ranenbg/Arduino-FFB-wheel/brWheel_my/leonardo hex/ver_info_leonardo_micro.txt

version		features

- firmware HEX versions bellow require wheel control up to v1.81

11		encoder, 3 axis
111		encoder, 3 axis, 32 buttons
112		encoder, 2 axis + 1 for load cell, 32 buttons
12		encoder, 3 axis, up to 1800deg, 2x stronger damper and inertia
121		encoder, 3 axis, 32 buttons, up to 1800deg, 2x stronger damper and inertia
122		encoder, 2 axis + 1 for load cell, 32 buttons, up to 1800deg, 2x stronger damper and inertia
13		encoder, 3 axis, 3 buttons, up to 1800deg, 2x stronger damper and inertia
130		encoder, 3 axis, 3 buttons, up to 1800deg, 2x stronger damper and inertia, fixed periodic effects
131		encoder, 3 axis, 32 buttons, up to 1800deg, 2x stronger damper and inertia, fixed periodic effects + envelope + condition
133		encoder, 2 axis + 1 for load cell, 3 buttons, up to 1800deg, 2x stronger damper and inertia, fixed periodic effects + envelope + condition
14		encoder, 3 axis, 3 buttons, up to 1800deg, 2x stronger damper and inertia, fixed periodic effects + envelope + condition, EEPROM update only, FFB balance instead of brake strength
140		encoder, 3 axis, 3 buttons, up to 1800deg, 2x stronger damper and inertia, EEPROM update only, FFB balance instead of brake strength, reduced serial response details, individual timers for periodic effects + small fix
141		encoder, 3 axis, 32 buttons, up to 1800deg, 2x stronger damper and inertia, EEPROM update only, FFB balance instead of brake strength, reduced serial response details, individual timers for periodic effects + small fix
142		encoder, 2 axis + 1 for load cell, 32 buttons up to 1800deg, 2x stronger damper and inertia, EEPROM update only, FFB balance instead of brake strength, reduced serial response details, individual timers for periodic effects + small fix
141a		the same as v141, with wheel calibration enabled at startup
141b		the same as v141, with wheel calibration enabled at startup and no pedal autocalibration
150		the same as v140, but with only 1 FFB axis (fix for LFS)
151		the same as v141, but with only 1 FFB axis (fix for LFS)
152		the same as v142, but with only 1 FFB axis (fix for LFS)
150z            the same as v150, but with z-index support
151a		the same as v151, but with no pedal auto calibration
153		encoder + Z-index, 2 axis + 1 for load cell, 3 buttons, pedal autocalib, FFB output with 2xDAC (adafruit MCP4725) - recommended for DD wheels

- firmware HEX versions bellow require wheel control v1.9 or newer

160	        encoder, 4 axis, 2 buttons, pedal autocalib, 1FFB axis
160a	        the same as v160, but with no pedal auto calibration
160z	        the same as v160, with Z-index support
161		encoder, 4 axis, 28 buttons, pedal autocalib, 1FFB axis
162a		encoder, 3 axis + 1 for load cell, 2 + 28buttons, no pedal autocalib, 1FFB axis 
163		encoder + Z-index, 3 axis + 1 for load cell, 2 + 28buttons, pedal autocalib, 1FFB axis, FFB output with 2xDAC (adafruit MCP4725) - recommended for DD wheels

- firmware HEX versions bellow require wheel control v2.0 or newer

170 		encoder, 4 axis, 4 buttons, no pedal autocalib, 1FFB axis
170a		encoder, 4 axis, 4 buttons, pedal autocalib, 1FFB axis
170z 		encoder + Z-index, 4 axis, 4 buttons, no pedal autocalib, 1FFB axis
171ah		encoder, 4 axis, 4 (1 hat switch) + 24 buttons, pedal autocalib, 1FFB axis
172h		encoder, 3 axis + 1 for load cell, 4 (1 hat switch) + 24 buttons, no pedal autocalib, 1FFB axis 
172ah		encoder, 3 axis + 1 for load cell, 4 (1 hat switch) + 24 buttons, pedal autocalib, 1FFB axis
172azh		encoder + Z-index, 3 axis + 1 for load cell, 4 (1 hat switch) + 24 buttons, pedal autocalib, 1FFB axis
173azh		encoder + Z-index, 3 axis + 1 for load cell, 4 (1 hat switch) + 24 buttons, pedal autocalib, 1FFB axis, FFB output with 2xDAC (adafruit MCP4725) - recommended for DD wheels

180		encoder, 4 axis, 8 buttons, 2 FFB axis, shift register fix, button matrix, periodic effects timing fix, duration and start delay fix, 16bit direction, new HX711 library, debug FFB optimizations, 16x less strong spring
180z		the same as v180, with support for encoder Z-index channel
180as		the same as v180, with pedal autocalib and support for ADS1015 external ADC for pedals
180az		the same as v180z, with pedal autocalib
180azt		the same as v180az, with 4x4 button matrix support
180azht		the same as v180azt, with hat switch support (1st 4 buttons from a matrix are used)					
181z		the same as v180z, but has shift register support for 16 buttons
181as		the same as 180as, but has shift register support for 16 buttons	
181ahs		the same as v181as but has hat switch support (1st 4 buttons from shift register are used)
181azh 		the same as v181z, with pedal autocalib and hat switch support
182azh		the same as v181z, with pedal autocalib and load cell support with HX711
183ah		the same as v182azh, but without z-index support and has analog FFB output with 2x12bit DAC MCP4275

- firmware HEX versions bellow require wheel control v2.1 or newer

190		encoder, 4 axis, 8 buttons, 100k CPR, wheel angle as metric for conditional effects, shift register fix, button matrix, 2 FFB axis, periodic effects timing fix, duration and start delay fix, 16bit direction, new HX711 library, debug FFB optimizations, 16x less strong spring
190as		the same as v190, with pedal autocalib and support for ADS1015 external ADC for pedals
190azht		the same as v190, with pedal autocalib, encoder Z-index channel, 4x4 button matrix and hat switch support
190azf		the same as v190, with pedal autocalib, encoder Z-index channel and XY analog shifter support
191azh		the same as v190, with pedal autocalib, shift register, encoder Z-index channel and hat switch support	
192azh		the same as v191, with load cell support with HX711
192af		the same as v190, with pedal autocalib, XY analog shiffter and HX711 support (no shift register)	
192azf		the same as v191af, with z-index support
193ah		the same as v192azh, but without z-index support and has analog FFB output with 2x12bit DAC MCP4275

- firmware HEX versions bellow require wheel control v2.3 or newer

200		encoder, 4 axis, 8 buttons, 100k CPR, wheel angle as metric for conditional effects, shift register fix, button matrix, 2 FFB axis, periodic effects timing fix, duration and start delay fix, 16bit direction, new HX711 library, debug FFB optimizations, 16x less strong spring, manual pedal axis calibration, pwm0.50.100 mode
200a		the same as v200, with pedal autocalib instead of manual calib
200z		the same as v200, with z-index support
200c		the same as v200, with hardware wheel recenter button on pin D2
200f		the same as v200, with XY analog shiffter support
200zf		the same as v200, with z-index and XY analog shiffter support
200azf		the same as v200zf, with pedal autocalib instead of manual calib

- firmware HEX versions bellow require wheel control v2.4 or newer

210		encoder, 4 axis, 8 buttons, 100k CPR, wheel angle as metric for conditional effects, shift register fix, button matrix, 2 FFB axis, periodic effects timing fix, duration and start delay fix, 16bit direction, new HX711 library, debug FFB optimizations, 16x less strong spring, manual pedal axis calibration, pwm0.50.100 mode, rcm pwm mode
210a		the same as v210, with pedal autocalib instead of manual calib
210z		the same as v210, with z-index support
210c		the same as v210, with hardware wheel recenter button on pin D2
210f		the same as v210, with XY analog shiffter support
210cf		the same as v210c, with XY analog shiffter support
210acf		the same as v210cf, with automatic pedal calibration
210zf		the same as v210, with z-index and XY analog shiffter support
210azf		the same as v210zf, with pedal autocalib instead of manual calib
210ht		the same as v210, with 4x4 button matrix and a hat switch support
211ah		the same as v210a, with shifter register and hat switch support 
211s		the same as v210, with support for ADS1015 external ADC for pedals and shift register
211chf		the same as v210cf, with a hat switch and shift register		
212ah		the same as v211ah, with load cell support with HX711 
213ah		the same as v211ah, but has analog FFB output with 2x12bit DAC MCP4275

- firmware HEX versions bellow require wheel control v2.5 or newer

220		encoder, 4 axis, 8 buttons, 100k CPR, wheel angle as metric for conditional effects, shift register fix, button matrix, 2 FFB axis, periodic effects timing fix, duration and start delay fix, 16bit direction, new HX711 library, debug FFB optimizations, 16x less strong spring, manual pedal axis calibration, pwm0.50.100 mode, rcm pwm mode, X-axis calibration 0-65k, encoder z-index reset
220a		the same as v220, with pedal autocalib instead of manual calib
220z		the same as v220, with z-index support
220c		the same as v220, with hardware wheel recenter button on pin D2
220f		the same as v220, with XY analog shiffter support
220cf		the same as v220c, with XY analog shiffter support
220ct		the same as v220c, with 4x4 button matrix support
220acf		the same as v220cf, with automatic pedal calibration
220zf		the same as v220, with z-index and XY analog shiffter support
220azf		the same as v210zf, with pedal autocalib instead of manual calib
220ht		the same as v220, with 4x4 button matrix and a hat switch support
220azht		the same as v220ht, with automatic pedal calibration and z-index support
220acht		the same as v220ht, with automatic pedal calibration and hardware wheel recenter button on pin D2
221ah		the same as v220a, with shifter register and hat switch support 
221s		the same as v220, with support for ADS1015 external ADC for pedals and shift register
221chf		the same as v210cf, with a hat switch and shift register		
222ah		the same as v221ah, with load cell support with HX711
222h		the same as v222ah, but with manual pedal calibration
222zh		the same as v221ah, but has Z-index support and has manual pedal calibration instead
223ah		the same as v221ah, but has analog FFB output with 2x12bit DAC MCP4275

- firmware HEX versions bellow require wheel control v2.6.0 or newer

230x		encoder, 4 axis, 8 buttons, 100k CPR, wheel angle as metric for conditional effects, shift register fix, button matrix, 2 FFB axis, periodic effects timing fix, duration and start delay fix, 16bit direction, new HX711 library, debug FFB optimizations, 16x less strong spring, manual pedal axis calibration, pwm0.50.100 mode, rcm pwm mode, X-axis calibration 0-65k, encoder z-index reset, additional h-shifter options, FFB on analog axis selector, variable pedal cal values
230ax		the same as v230x, with pedal autocalib instead of manual calib
230zx		the same as v230x, with z-index support
230cx		the same as v230x, with hardware wheel recenter button on pin D2
230ix		the same as v230x, with averaging of analog inputs for pedals (4 samples)
230sx		the same as v230x, with support for ADS1015 external ADC for pedals
230fx		the same as v230x, with XY analog shifter support
230cfx		the same as v230cx, with XY analog shifter support
230ctx		the same as v230cx, with 4x4 button matrix support
230acfx		the same as v230cfx, with automatic pedal calibration
230zfx		the same as v230fx, with z-index support
230azfx		the same as v230zfx, with pedal autocalib instead of manual calib
230htx		the same as v230x, with 4x4 button matrix and a hat switch support
230azhtx	the same as v230htx, with automatic pedal calibration and z-index support
230achtx	the same as v230htx, with automatic pedal calibration and hardware wheel recenter button on pin D2
231ahx		the same as v230ax, with shifter register and hat switch support 
231sx		the same as v230x, with support for ADS1015 external ADC for pedals and shift register
231chfx		the same as v230cfx, with a hat switch and shift register support		
232ahx		the same as v231ahx, with load cell support with HX711
232hx		the same as v232ahx, but with manual pedal calibration
232zhx		the same as v232ahx, with load cell and Z-index support, but has manual pedal calibration instead
232chx		the same as v232hx, with hardware wheel recenter button on pin D2 
233ahx		the same as v232ahx, but has analog FFB output with 2x12bit DAC MCP4275

- firmware HEX versions bellow require wheel control v2.6.1 or newer

240x		encoder, 4 axis, 8 buttons, 100k CPR, wheel angle as metric for conditional effects, shift register fix, button matrix, 2 FFB axis, periodic effects timing fix, duration and start delay fix, 16bit direction, new HX711 library, debug FFB optimizations, 16x less strong spring, manual pedal axis calibration, pwm0.50.100 mode, rcm pwm mode, X-axis calibration 0-65k, encoder z-index reset, additional h-shifter options, FFB on analog axis selector, with variable pedal cal values, button pin mapping fixes
240ax		the same as v240x, with pedal autocalib instead of manual calib
240wx		the same as v240x, with magnetic encoder support
240zx		the same as v240x, with z-index support
240cx		the same as v240x, with hardware wheel recenter button on pin D2
240ix		the same as v240x, with averaging of analog inputs for pedals (4 samples)
240sx		the same as v240x, with support for ADS1015 external ADC for pedals
240fx		the same as v240x, with XY analog shifter support
240cfx		the same as v240cx, with XY analog shifter support
240htx		the same as v240x, with 4x4 button matrix and a hat switch support
240chtx		the same as v240htx, with hardware wheel recenter button on pin D2
240acfx		the same as v240cfx, with automatic pedal calibration
240zfx		the same as v240fx, with z-index support
240azfx		the same as v240zfx, with pedal autocalib instead of manual calib
240azhtx	the same as v240htx, with automatic pedal calibration and z-index support
240achtx	the same as v240chtx, with automatic pedal calibration
241ahx		the same as v240ax, with shifter register and hat switch support 
241whx		the same as v240wx, with shifter register and hat switch support
241shx		the same as v240sx, with shift register and hat support
241chfx		the same as v240cfx, with a hat switch and shift register support
242ahx		the same as v241ahx, with load cell support with HX711
242awhx		the same as v242ahx, with magnetic encoder support
242hx		the same as v242ahx, but with manual pedal calibration
242zhx		the same as v242ahx, with load cell and Z-index support, but has manual pedal calibration instead
242chx		the same as v242hx, with hardware wheel recenter button on pin D2
243ahx		the same as v242ahx, but has analog FFB output with 2x12bit DAC MCP4275

- firmware HEX versions bellow require wheel control v2.6.3 or newer

250x		encoder, 4 axis, 8 buttons, 100k CPR, wheel angle as metric for conditional effects, shift register fix, button matrix, 2 FFB axis, periodic effects timing fix, duration and start delay fix, 16bit direction, new HX711 library, debug FFB optimizations, 16x less strong spring, manual pedal axis calibration, pwm0-50-100 mode, rcm pwm mode, X-axis calibration 0-65k, encoder z-index reset, additional h-shifter options, FFB on analog axis selector, with variable pedal cal values, button pin mapping fixes, 2 axis FFB support (for constant, sine, spring), 4 channel PWM output (2CH PWM modes available), dac0-50-100 mode (and its 2CH equivalents)
250ax		the same as v250x, with pedal autocalibration instead of manual calibration
250bx		the same as v250x, with 2 FFB axis and 4 channel PWM output	
250abx		the same as v250bx, with pedal autocalibration		
250bcdwx	the same as v250bx, without optical encoder, with magnetic encoder (AS5600) and hardware wheel recenter button on pin TX
250cx		the same as v250x, with hardware wheel recenter button on pin D2
250dx		the same as v250x, without support for optical encoder (you can use pot for x-axis)
250zx		the same as v250x, with z-index support		
250ix		the same as v250x, with averaging of analog inputs for pedals (4 samples)
250sx		the same as v250x, with support for 12bit ADS1015 external ADC for pedals
250fx		the same as v250x, with XY analog shifter support
250zfx		the same as v250fx, with z-index support
250acx		the same as v250cx, with pedal autocalibration
250achx		the same as v250acx, with hat switch support	
250cdwhx	similar to v250bcdwx, just with	only 1 FFB axis	
250acdwhx	the same as 250cdwhx, with pedal autocalibration
250htx		the same as v250x, with hat switch and 4x4 button matrix support	
250chtx		the same as v250htx, with recenter button on pin D2
250zhxn		the same as v250zx, with hat switch and shifter register (nano button box)
250achxn	the same as v250cx, with pedal autocalibration, hat switch and shifter register (nano button box)
250achexn	the same as v250achxn, with support for two extra buttons (on pins A2, A3)
250azhxn	the same as v250zhxn, with pedal autocalibration
250xl		the same as v250x, with load cell support with HX711
250hxl		the same as v250xl, with hat switch support
250fxl		the same as v250xl, with XY analog shifter support		
250hxnl		the same as v250hxl, with shifter register (nano button box)
250hfxnl	the same as v250hxnl, with XY analog shifter support
250ahxnl	the same as v250hxnl, with pedal autocalibration	
250zhxnl	the same as v250hxnl, with z-index support
250zhfxnl	the same as v250zhxnl, with XY analog shifter support
250bdwux	the same as v250bx, with support for 2 magnetic encoders (AS5600) via i2C multiplexer (TCA9548A)
250bcdwux	the same as v250bdwux, with hardware wheel recenter button on pin TX
250xg		the same as v250x, with analog FFB output via 2x12bit external DAC (MCP4275)
250bxg		the same as v250xg, with 2 FFB axis and 2 channel analog DAC output	
250bdxg		the same as v250bxg, without optical encoder (full analog firmware)
250bcdwxg	the same as v250bdxg, with magnetic encoder (AS5600) and hardware wheel recenter button on pin TX 	
250hxng		the same as v250xg, with hat switch and shifter register (nano button box)

- firmware HEX versions bellow require wheel control v2.6.4 or newer

250xnr		the same as v250x, with support for 3x8bit shift register chip SN74ALS166N for 24 buttons
250hxnr		the same as v250xnr, with hat switch support
250bdwuxg	the same as v250bdxg, with support for 2 magnetic encoders (AS5600) via i2C multiplexer (TCA9548A)
250chfxn	the same as v250cx, with support for hat switch, XY analog shifter and shift register (nano button box)
250chfxnr	the same as v250chfxn, with support for 2x8bit shift register chip SN74ALS166N for 16 buttons, instead of nano button box
250dwfx         the same as v250fx, with support for magnetic encoder (AS5600) instead of an optical one
250dwxn         the same as v250x, with support for magnetic encoder (AS5600) and with nano button box
250kx		the same as v250x, with gas axis split into gas and brake axis

- firmware HEX versions bellow require wheel control v2.6.6 or newer

250dkx		the same as v250dx, with gas axis split into gas and brake axis
