ranenbg/Arduino-FFB-wheel/brWheel_my/docs/RS232 commands info.txt

Milos Rankovic, ranenbg@gmail.com
first created 25.03.2020.
last update 19.03.2024.

This txt file contains a list of all available RS232 serial interface commands implemented in my latest Arduino FFB wheel firmware version fw-v250 (you can use this info to make your own control GUI)

Arduino boards are also recognized as a virtual serial communication device (COM port) through which we can send/receive commands to/from the ATmega32U4 microcontroller

RS232,   commands are not case sensitive (in this manual capital letters are used only as an example)
         some commands do not have any parameter following a command char, but if they do, a range of available input values is given
         all commands must be terminated with CR: carriage return - char(13)
         upon receiving valid command Arduino terminates all responses with CR+LF: carriage return - char(13) and line feed - char(10)
         some commands have response and some don't (in this txt file, null means no serial response from Arduino)
         most commands can apply changes right away, but some require Arduino restart (for PWM settings - reconfiguration of internal timer registers is necessary)
         if Arduino restart is needed, do not send any additional commands before restart
         firmware will check if any serial command is received every 10ms (100Hz refresh rate)
         Arduino response time is therefore maximally 10ms, but typically is around (2-5)ms
         at each Arduino powerup firmware will automatically load and configure all settings from EEPROM (for load cell - it takes additional 2s for completing tare zeroing)
         FFB clip LED will quickly blink 3 times to indicate that everything is loaded, configured and ready to use

versions, I have put some logic in firmware naming, so here is some basic explanation (if you plan to upgrade firmware, please respect this, only up to fw-v24X):
         fw-vXX,  two digits only are a test versions of new firmware features (not used anymore)
         fw-vXX0, three digits ending with 0 - the basic firmware with no external devices support, except for optical/magnetic encoder (has PWM signal as FFB output)
         fw-vXX1, three digits ending with 1 - adds support for external button box
         fw-vXX2, three digits ending with 2 - adds support for both external button box and load cell
         fw-vXX3, three digits ending with 3 - adds support for external button box, load cell and two external 12bit DAC - MCP4725 (has analog signal as FFB output)

versions from fw-v250, I've changed firmware naming logic such that all 3 digits in the name now represent firmware version only (everything else is an option, see bellow)

options, firmware version string may include some letters after digits, their meaning is:
         a - pedal autocalibration enabled (if no a, then manual calibration is enabled)
         b - 2 FFB axis support with physical output (4 channel digital PWM or 2 channel analog DAC outputs available)
	 w - magnetic encoder AS5600 support
         d - no optical encoder support
         z - optical encoder with z-index support
         h - enabled Hat Switch (uses first 4 buttons from button box)
         s - enabled external 12bit ADC for analog inputs (ADS1015 i2C)
         t - enabled 4x4 button matrix
         f - enabled XY analog H-pattern shifter
         i - enabled averaging of analog inputs
	 e - support for two additional digital buttons (clutch and handbrake axis will be unavailable)
	 x - enables the option to select to which (analog) axis is FFB tied to
         r - support for external shift register chips for 24 buttons (3x SN74ALS166 wired in series)
         n - support for external button box for 16 buttons via Arduino nano (with my button box firmware)
         l - support HX711 chip for load cell
         g - support for external 12bit DAC to be used for analog FFB output (2x MCP4725 i2C)
	 p - no EEPROM support for loading/saving firmware settings (firmware defaults are loaded at each startup)
         m - replacement pinouts for ProMicro (for FFB clipping LED, buttons 3 and 4, PWM direction pin)

[1] all wheel parameters read out
received numbers are: wheel rotation angle, general, damper, friction, constant, 
periodic, spring, inertia, auto center spring and end stop spring effect gains,
min torque PWM, brake pressure, desktop effects byte, total PWM steps (resolution), encoder CPR and PWM configuration byte
command		example response
U		1080 100 50 50 100 100 100 50 70 0 0 45 1 500 2400 9

[2] show firmware version
command		example response
V		fw-v240x

[3] show states for encoder
0 - not calibrated or no z-index found (normal for encoders without z-channel)
1 - calibrated or z-index found
2 - calibration error
command		example response
S		1			

[4] re-calibrate wheel
this feature has two modes of operation depending on firmware option "z"
(a)for firmware without "z" option, this procedure will try to rotate wheel to the right until a mechanical end stop is detected
do not use this command if you do not have a mechanical limits for wheel rotation installed (should use center command instead)
(b)for firmware with "z" option, this procedure will rotate the wheel until a z-index pulse from encoder is detected
at this position of z-index, a 0deg value will be assigned to the wheel (this may not be a real wheel zero angle)
if a wheel is not centered at this position (99% chance), return the wheel by hand to the center, then send "center" command, then send "save" command to save new z-index offset value
this procedure will store the z-index pulse angle offset in EEPROM 
on next Arduino powerup as soon as z-index is detected, the firmware will automatically apply the angle correction using the offset loaded from EEPROM
note that z-index angle offset will change if you re-mount your encoder, as you are not able to put it back to the exact same angle mechanically
command		example response
R		null

[5] adjust load cell brake pressure calibration factor (valid for fw-vXX2 only, for all other it becomes a *PWM balance slider)
sent and received number is only a relative value
each load cell will have a different max force
value of 4 will give 1:1 reading from HX711 24bit ADC chip
*PWM balance slider - you can use it to compensate for example if your motor has a stronger pull in one direction (128-center, equal pull in both directions)
value	leftPWM(%)	rightPWM (%)
0	100    		50
128	100		100
255	50		100
command		example response	range
B 45		1			1-255

[6] re-calibrate pedals
will reset pedal axis auto-calibration
if load cell is used for brake it will not affect its calibration factor and will only reset throttle and clutch
if no load cell is used reset will be done for brake axis as well
command		example response	range
P		1			null

[7] optical encoder CPR (PPR) adjustment
sent and received number is CPR - counts per revolution of encoder shaft (valid for optical, magnetic encoders and pots)
encoders usualy have specified PPR - pulses per revolution
CPR = 4 * PPR * X
X=1 if encoder is directly mounted to the wheel rim, otherwise it is a gear ratio between encoder and wheel shafts
if a pot is used for X-axis then CPR is tied to resolution of that analog input (Arduino 10bit 1024, with averaging 4096, or with ADS1105 in single ended readout 2048)
command		example response	range
O 2400		1			4-600000

[8] re-center wheel
use this command to reset 0deg position of your wheel rim (after you manually centering the wheel)
this will be required each time Arduino is powered on or reset, but it's very quick and easy to do
for HEX firmware with "z" option enabled, it will set z-index offset in the units of encoder CPR
command		example response	range
C		1			null

[9] reset encoder Z-index
use this command to set the Z-index encoder offset value to 0
after using this command you can move the wheel to a new position and press the center, than press save button
command		example response	range
Z		1			null

[10] adjust wheel rotation angle 
sent and received number is in degrees (lock-to-lock)
command		example response	range
G 900		1			30-1800

[11] adjust desktop effects
byte, bit0-autocentering spring, bit1-damper, bit2-inertia, bit3-friction, bit4-ffb monitor, bits5,7-are index of FFB axis selection (bit5 is LSB for index, 0 means X-axis)
bit0 - is LSB (lowest significant bit)
sent and received number is a decimal equivalent (form) of this byte
command		example response	range
E 1		1			0-31

[12] adjust PWM/DAC settings - only requires Arduino restart to apply PWM changes (press reset button, or just re-plug Arduino to USB port)
byte, bit0-phase correct (or fast pwm), bit1-dir enabled (or pwm+-), bits 2-5 are frequency select, bits6-pwm0-50-100 mode enable, bit7 is unused
PWM0-50-100 mode selection is done by setting bit1 LOW and bit6 HIGH
RCM mode selection is done by setting both bit1 and bit6 HIGH (please note that not all frequencies are available, see firmware_info.txt for more details)

bit0 pwm_type
0    fast pwm
1    phase correct

bit1 bit6 pwm_mode	pwm_mode2 (2-ffb axis)
0    0    pwm+-		2ch pwm+-
0    1    pwm0.50.100   2ch pwm0.50.100
1    0    pwm+dir       2ch pwm+dir
1    1    rcm           2ch rcm (not used)

IMPOPRTANT NOTE: if USE_MCP4725 is uncommented in Config.h then configuration byte has the following interpretation
bits 0-4 unused, bits 5,6 dac mode (see bellow), bit7 dac output (enable/disable)

bit7 dac_out
0    disabled (set to 0V or 2.5V depending on dac mode)
1    enabled

bit6 bit5 dac_mode     dac_mode2 (2-ffb axis)
0    0	  dac+-        1ch dac+- (xFFB)
0    1    dac0-50-100  2ch dac0-50-100
1    0    dac+dir      2ch dac+dir
1    1    none	       none

for available frequency selection see firmware info.txt
sent number is a decimal equivalent (form) of this byte
received number is PWM resolution (max number of PWM steps, for given PWM frequency and PWM type)
the settings will be stored in EEPROM right away (no additional saving is necessary with command A)
command		example response	range
W 5		400			0-255

[13] Save command - store firmware settings in EEPROM (stores everything except for PWM settings)
command		example response
A		1

[14] adjust FFB general (overall effects) gain
unit for sent and received number is %
command		example response	range
FG 100		1			0-200

[15] adjust FFB constant force effect gain
command		example response	range
FC 100		1			0-200

[16] adjust FFB damper effect gain
command		example response	range
FD 100		1			0-200

[17] adjust FFB friction effect gain
command		example response	range
FF 100		1			0-200

[18] adjust FFB periodic effect gain (affects sine, triangle, square, sawtoothup and sawtoothdown effects only) 
command		example response	range
FS 100		1			0-200

[19] adjust FFB spring effect gain
command		example response	range
FM 100		1			0-200

[20] adjust FFB inertia effect gain
command		example response	range
FI 100		1			0-200

[21] adjust FFB auto-centering spring effect gain
command		example response	range
FA 100		1			0-200

[22] adjust FFB end stop spring effect gain
command		example response	range
FB 100		1			0-200

[23] adjust minimal PWM signal level
unit for received number is x0.1%
range corresponds to (0.0-20.0)% of max PWM value
command		example response	range
FJ 100		1			0-200

[24] XY analog shifter calibration "a" limit
sets the X pos limit between 1st-2nd and 3rd-4th gear
command		example response	range
HA 255		1			0-1023

[25] XY analog shifter calibration "b" limit
sets the X pos limit between 3rd-4th and 5th-6th gear
command		example response	range
HB 511		1			0-1023

[26] XY analog shifter calibration "c" limit
sets the X pos limit between 5th-6th and 7th-8th gear
command		example response	range
HC 767		1			0-1023

[27] XY analog shifter calibration "d" limit
sets the Y pos limit between gears 1,3,5,7 and neutral
command		example response	range
HD 255		1			0-1023

[28] XY analog shifter calibration "e" limit
sets the Y pos limit between neutral and gears 2,4,6,8
command		example response	range
HE 511		1			0-1023

[29] XY analog shifter gear configuration byte
advanced configuration allows to adjust how shifter operates 
input is a decimal representation of a byte where
bit0=1: reverse gear button inverted (for Logitech G25/G27/G29/G923 H-shifters)
bit1=1: 8 gear mode (rev gear in 8th+rev button), otherwise it's in 6th+rev button
bit2=1: X-axis inverted
bit3=1: Y-axis inverted
command		example response	range
HF 2		1			0-255

[30] XY analog shifter calibration and config readout
returns shifter config byte and limits a, b, c, d, e
command		example response	range
HG		0 255 511 767 255 511	null

[31] XY analog shifter position readout
returns current h-shifter X and Y position
command		example response	range
HR		123 456			null

[32] manual pedal axis calibration "a" limit
sets the minimal calibration value for brake pedal
command		example response	range
YA		1			0-4095

[33] manual pedal axis calibration "b" limit
sets the maximal calibration value for brake pedal
command		example response	range
YB		1			0-4095

[34] manual pedal axis calibration "c" limit
sets the minimal calibration value for accelerator pedal
command		example response	range
YC		1			0-4095

[35] manual pedal axis calibration "d" limit
sets the maximal calibration value for accelerator pedal
command		example response	range
YD		1			0-4095

[36] manual pedal axis calibration "e" limit
sets the minimal calibration value for clutch pedal
command		example response	range
YE		1			0-4095

[37] manual pedal axis calibration "f" limit
sets the maximal calibration value for clutch pedal
command		example response	range
YF		1			0-4095

[38] manual pedal axis calibration "g" limit
sets the minimal calibration value for handbrake pedal
command		example response	range
YG		1			0-4095

[39] manual pedal axis calibration "h" limit
sets the maximal calibration value for handbrake pedal
command		example response	range
YH		1			0-4095

[40] manual pedal axis calibration readout
returns pedal axis calibration limit values a, b, c, d, e, f, g, h
note that depending on firmware options these limits have different ranges
range	fw-option
1023	all (except "s" and "i")	
2047	"s"
4095	"i"
command		example response		range
YR		0 4095 0 4095 0 4095 0 4095	null
