ranenbg/Arduino-FFB-wheel/brWheel_my/wirings/Firmware-vXX1 button box pinout.pptx

This pinout is valid for firmware with option “n” only
Arduino Leonardo (as wheelbase) -> Arduino Nano or UNO (as button box)
Leonardo GND -> Nano GND
Leonardo 5V -> Nano 5V
Leonardo pin 6 (DT_SR) -> Nano pin 12
Leonardo pin 7 (CLK_SR) -> Nano pin 13
Leonardo pin 8 (PL_SR) -> Nano pin 10 and pin 2
Nano pins available for buttons (0-15):
A0, 7, 6, 5, 4, 3, 9, TX, RX, 8, 11, A5, A4, A3, A2, A1

one pin of each switch go to one of these pins,
other end of all switches go to GND
when pressed, switch has to short these 2 pins (normally open contact)

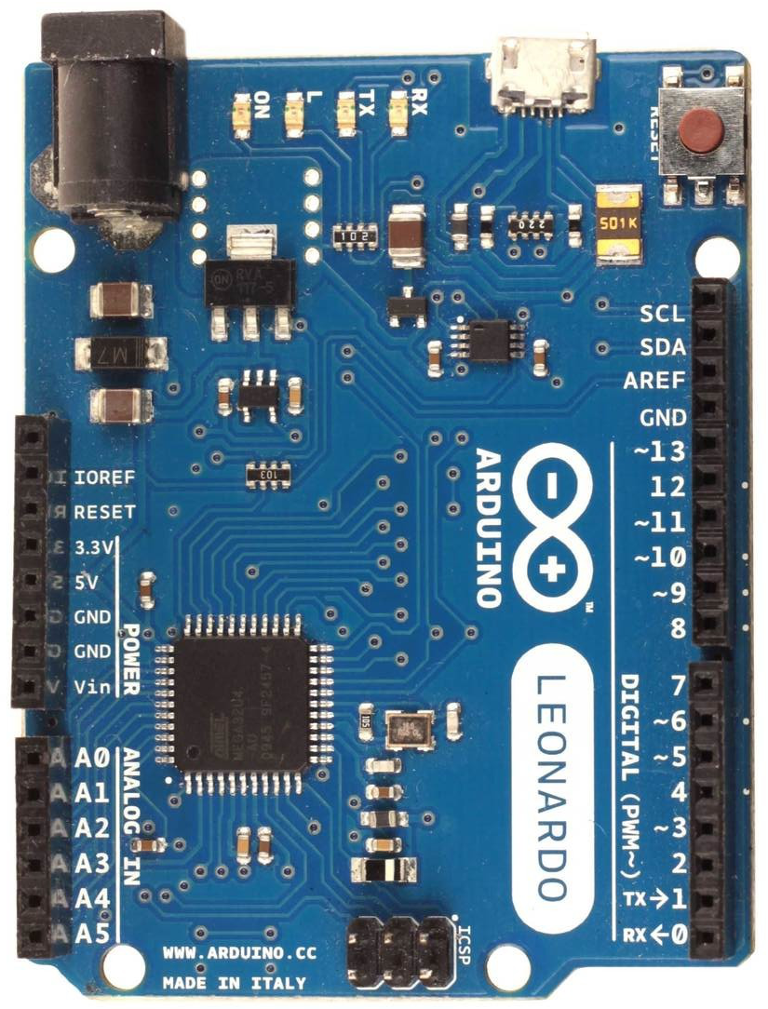
[picture p15: figure]

separate button box
*.ino file is provided

Firmware with “h” option
has hat switch support on
nano pins:

A0 - up
D7 - right
D6 - down
D5 - left

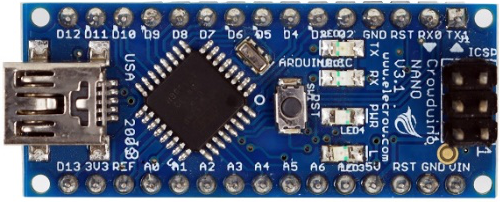
[picture p16: figure]

Goes in the wheel rim along with all switches
Up to 16 switches are possible (can be less or none)

you will need to find a way to take
5 wires through or around the wheel shaft

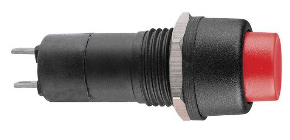
[picture p17: figure]
