ranenbg/Arduino-FFB-wheel/brWheel_my/wirings/Firmware-v16x pinout.pptx

Arduino Leonardo

Arduino Leonardo FFB wheel fw-v16x pinout:
GND - common ground
5V - Vcc for all devices
A0 - throttle pot
A1 - brake pot (if LC - then clutch pot)
A2 - clutch pot (if LC - then handbrake pot)
A3 - handbrake pot (if LC - then button0)
A4, A5 - buttons 1,2 (fw-v160)
RX - channel A optical encoder
TX - channel B optical encoder
2 - SDA, data for i2C (ADS1105)
3 - SCL, clock for i2C (ADS1105)
4 - DT pin for HX711 (LC)
5 - CLK pin for HX711 (LC)
6 - DT_sw for shift register (wheel rim)
7 - CLK for shift register (wheel rim)
8 - PL for shift register (wheel rim)
9 - left PWM channel
10 - right PWM channel
11 - PWM direction pin
12 - button3
13 - FFB clipping LED
LC - load cell with HX711


Arduino Pro Micro


Replacement pinouts:
16 - PWM direction pin
3 - FFB clipping LED (if no ADS1105)
14 - button1 (fw-v160)
15 - button2 (fw-v160)
2 - button3 (if no ADS1105, fw-v160)
