ranenbg/Arduino-FFB-wheel/brWheel_my/wirings/Firmware-v15x pinout.pptx

Arduino Leonardo

Arduino Leonardo FFB wheel fw-v15x pinout:
GND - common ground
5V - Vcc for all devices
A0 - throttle pot
A1 - brake pot (if LC - then clutch pot)
A2 - clutch pot (if LC - then unused)
A3, A4, A5 - buttons 0,1,2
RX - channel A optical encoder
TX - channel B optical encoder
2 - SDA, data for i2C (ADS1105)
3 - SCL, clock for i2C (ADS1105)
4 - DT pin for HX711 (LC - load cell)
5 - CLK pin for HX711 (LC - load cell)
6 - DT_sw for shift register (wheel rim)
7 - CLK for shift register (wheel rim)
8 - PL for shift register (wheel rim)
9 - left PWM channel
10 - right PWM channel
11 - PWM direction pin
12 - unused
13 - FFB clipping LED


Arduino Pro Micro


Replacement pinout:
A3 - button0
16 - PWM direction pin
3 - FFB clipping LED (if no ADS1105)
14 - button1 (fw-v13 only)
15 - button2 (fw-v13 only)
