ranenbg/Arduino-FFB-wheel/brWheel_my/resources/as5600_pcb.jpg

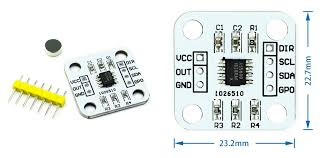
brWheel_my/resources/as5600_pcb.jpg
