ranenbg/Arduino-FFB-wheel/brWheel_my/resources/bts7960.jpg

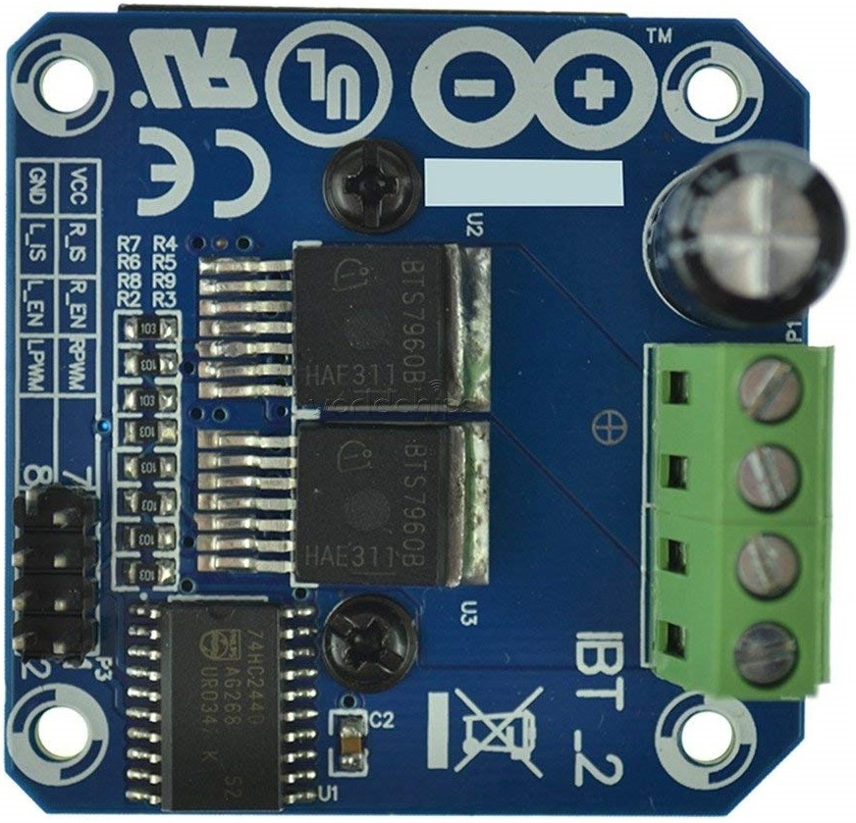
brWheel_my/resources/bts7960.jpg
