ranenbg/Arduino-FFB-wheel/brWheel_my/resources/button_matrix.bmp

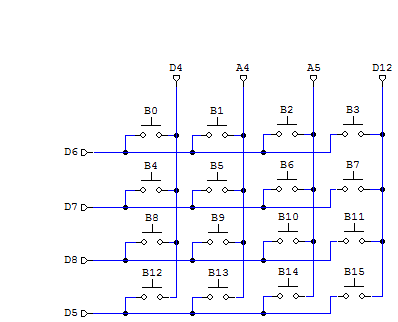
brWheel_my/resources/button_matrix.bmp
