ranenbg/Arduino-FFB-wheel/brWheel_my/resources/button_matrix_PCB.jpg

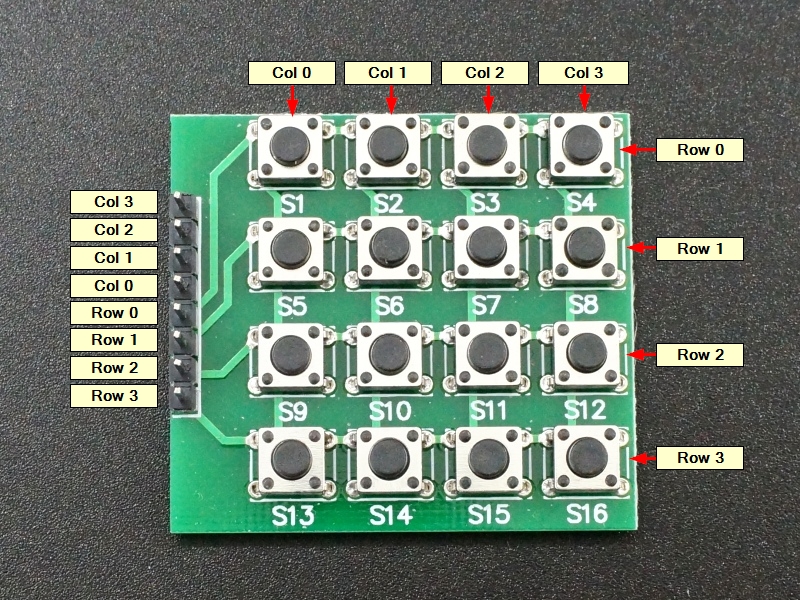
brWheel_my/resources/button_matrix_PCB.jpg
