ranenbg/Arduino-FFB-wheel/brWheel_my/resources/HX711_module_pcb.jpg

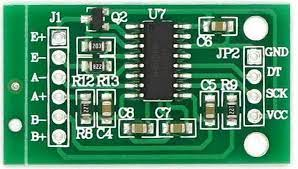
brWheel_my/resources/HX711_module_pcb.jpg
