ranenbg/Arduino-FFB-wheel/brWheel_my/resources/pot_pic.jpg

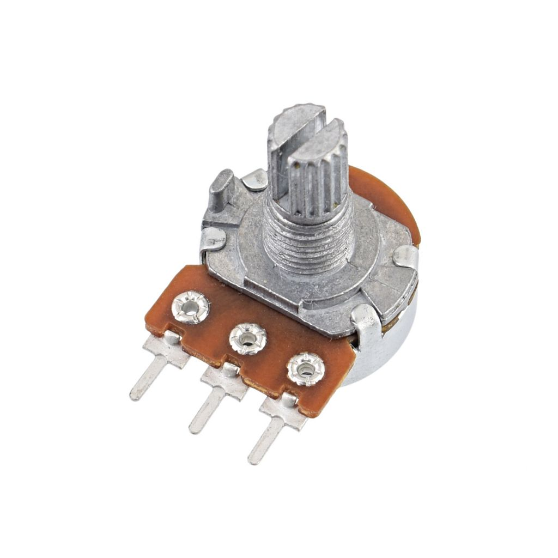
brWheel_my/resources/pot_pic.jpg
