ranenbg/Arduino-FFB-wheel/brWheel_my/resources/sn74als166n_shift_register.png

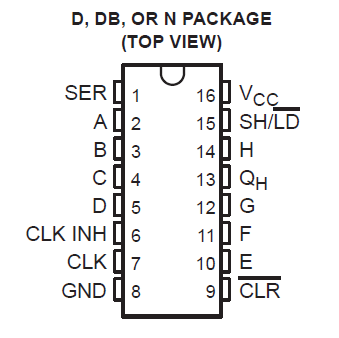
brWheel_my/resources/sn74als166n_shift_register.png
