ranenbg/Arduino-FFB-wheel/brWheel_my/resources/sn74hc165_shift_register.png

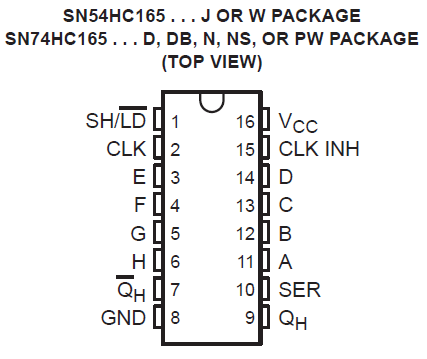
brWheel_my/resources/sn74hc165_shift_register.png
