ranenbg/Arduino-FFB-wheel/brWheel_my/resources/tca9548a.jpg

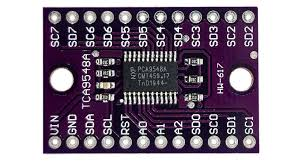
brWheel_my/resources/tca9548a.jpg
