ranenbg/Arduino-FFB-wheel/brWheel_my/wirings/Firmware-v15x pinout.png

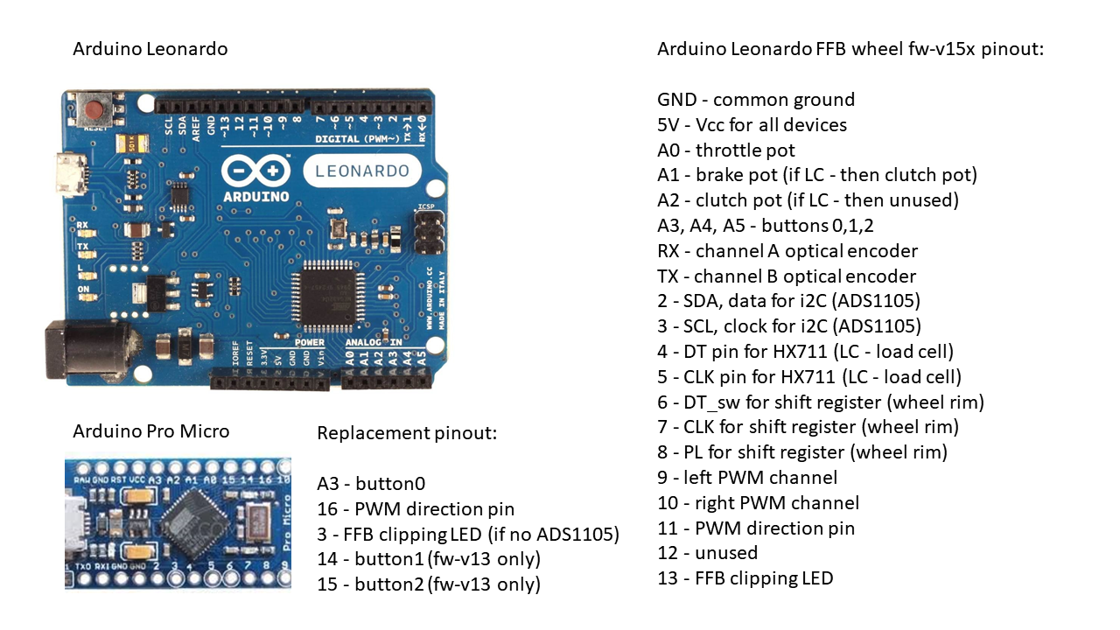
brWheel_my/wirings/Firmware-v15x pinout.png
