ranenbg/Arduino-FFB-wheel/brWheel_my/wirings/Firmware-v17x pinout.png

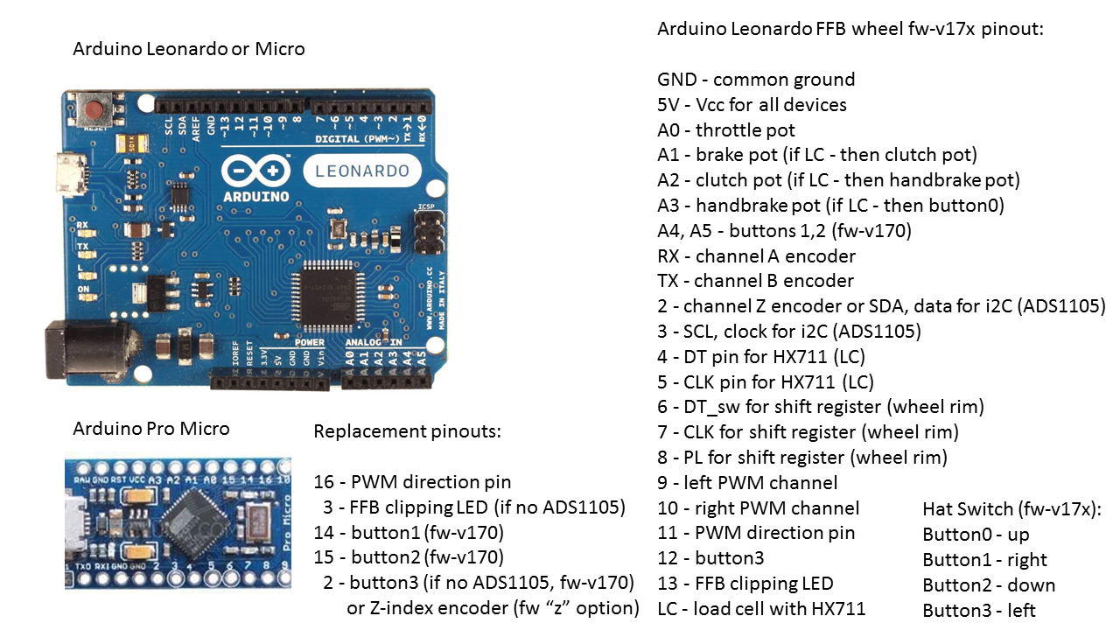
brWheel_my/wirings/Firmware-v17x pinout.png
