ranenbg/Arduino-FFB-wheel/brWheel_my/wirings/Firmware-v18x pinout.png

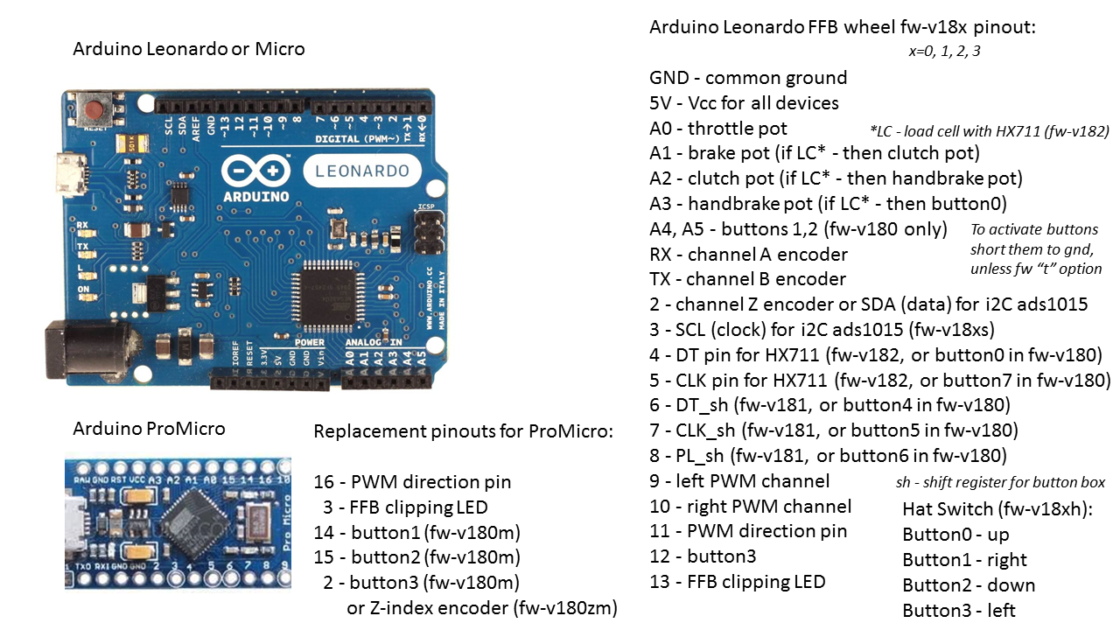
brWheel_my/wirings/Firmware-v18x pinout.png
