ranenbg/Arduino-FFB-wheel/brWheel_my/wirings/Firmware-v22x pinout.png

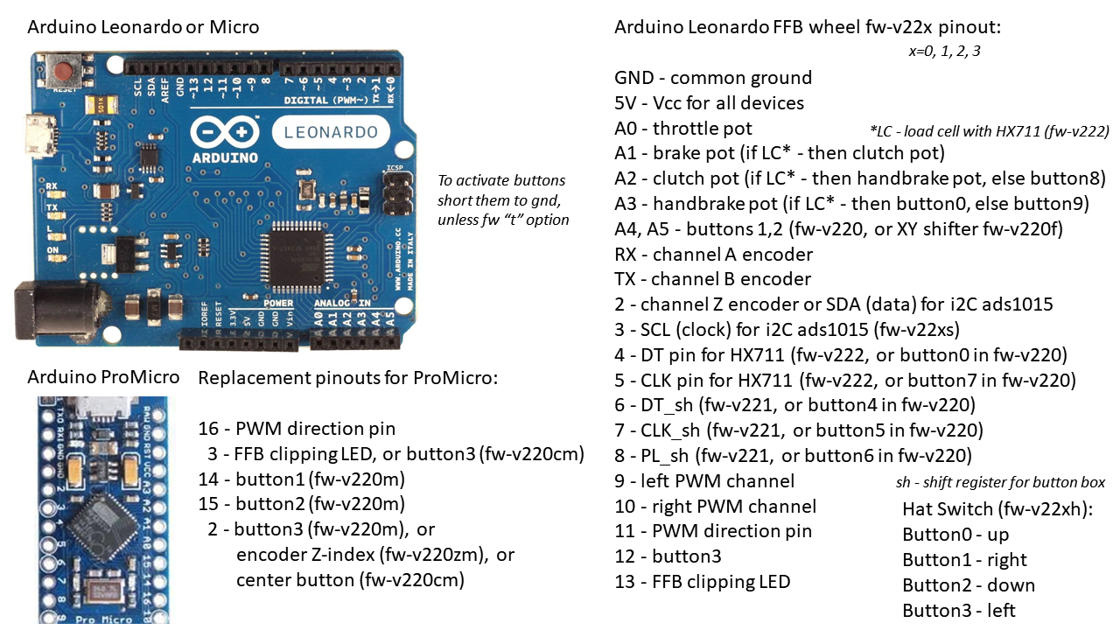
brWheel_my/wirings/Firmware-v22x pinout.png
