ranenbg/Arduino-FFB-wheel/brWheel_my/wirings/input_report_bytes_ver1.png

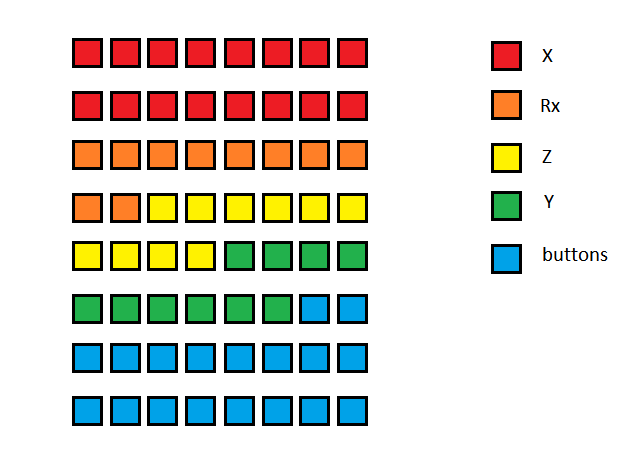
brWheel_my/wirings/input_report_bytes_ver1.png
