ranenbg/Arduino-FFB-wheel/brWheel_my/wirings/XY_shifter_wiring_diagram.pptx

Wiring diagram for analog XY shifter (only valid for firmware with option “f”)

Arduino Leonardo or Micro only

a

c

1023

neutral gear (no button)


10k linear pots

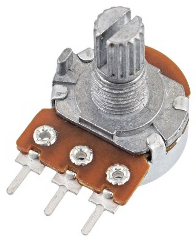
[picture p41: figure]

Y

1

3

5

7

pot0

pot1

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
6 (r)

8 (r)

0

X

1023


button0 for
reverse gear

in order to activate a reverse gear
you need to press this switch and
shift into last gear which
can be 6th or 8th depending
on the shifter configuration

Arduino XY shifter
5V 5V (pot0,1 pin 3)
GND GND (pot0,1 pin 1)
A4 X position (pot0 pin2)
A5 Y position (pot1 pin2)
4, A3* button0 (push switch)
*when load cell is enabled (firmware option “l”),
note that button0 is at pin A3 instead

b

or A3*
