ranenbg/Arduino-FFB-wheel/brWheel_my/wirings/mcp4725_wiring_diagram.pptx

Wiring diagram for external DAC’s (only valid for firmware with option “g”, in DAC± mode)

Arduino Leonardo, Micro or ProMicro

20k

+Vcc

shielded audio grade cable

Vcc can be provided by
regulated bipolar power supply
use LM7812, LM7912 for ±12V
or LM7815, LM7915 for ±15V

output ±10V

goes to AASD analog input
use of analog optocoupler
is desired but not required


10k

+

10k

20k

IC1

-Vcc


DAC1
0x61
right

IC1 - can be any audio grade
operational amplifire like
TL072, NE5532 or equivalent

DAC0 - ADDR pin to GND
i²C address 0x60 is for left force
DAC1 - ADDR pin to VCC
i²C address 0x61 is for right force

DAC0
0x60
left

Arduino MCP4725
5V VDD
GND GND
2 SDA (i²C data)
3 CLK (i²C clock)

MCP4725
external i²C 12bit DAC
