ranenbg/Arduino-FFB-wheel/brWheel_my/wirings/button_matrix_wiring_diagram.pptx

Wiring diagram for 4x4 button matrix (only valid for firmware with “t” option)

Arduino Leonardo, Micro or ProMicro

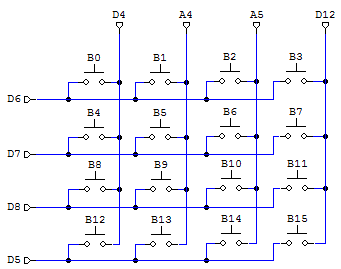
[picture p43: figure]

Firmware with “h” option
has hat switch support on
matrix buttons B0-B3:

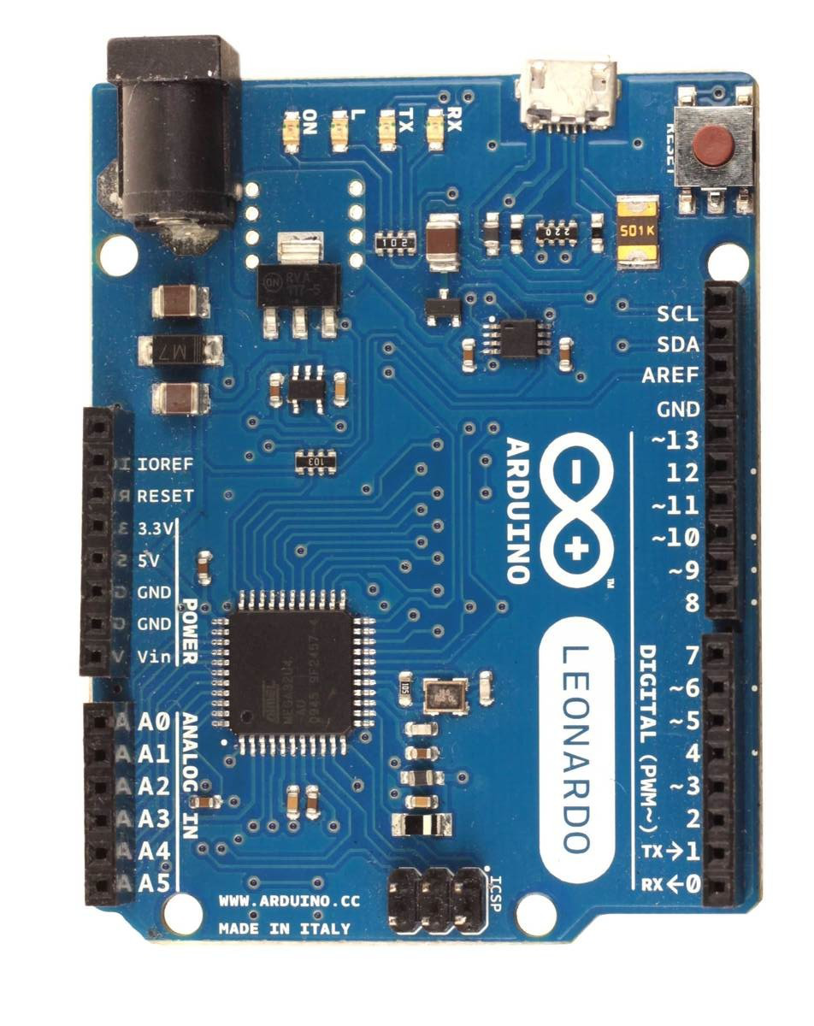
[picture p44: figure]

B0 - up
B1 - right
B2 - down
B3 - left

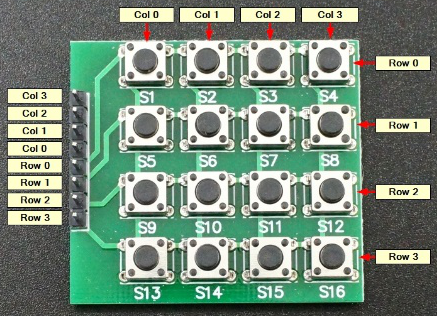
[picture p45: figure]

Button matrix schematic and PCB

Matrix pins:
row0 - D6
row1 - D7
row2 - D8
row3 - D5
col0 - D4
col1 - A4
col2 - A5
col3 - D12
