ranenbg/Arduino-FFB-wheel/.github/versions-to-build.txt

# List versions to build (space or newline separated)
# Example:
# v250
# v251
v250
