ranenbg/Arduino-FFB-wheel/(threads)

Thread 1 (2022-04-06):

More detailed and visual diagram

lazenyuk-dmitry, 2022-04-06:
It's hard to understand the wiring diagram.
Could you paint it more visual and detailed?
And the readme could be improved.

Like in this project for example https://github.com/vsulako/AFFBWheel

lazenyuk-dmitry, 2022-04-18:
Hey Milos. I want to draw a wiring diagram. What does "if LC - then clutch pot", "if LC - then handbreake pot", "if LC - then botton0" mean? what does LC mean?

lazenyuk-dmitry, 2022-04-18:
Why are you replacing pins with ProMicro and Leonsrdo? Leonsrdo also has pins 14, 15, 16 on the ICSP connector. Or am I misunderstanding something?

lazenyuk-dmitry, 2022-04-18:
What is i2C (ads1105) for?

ranenbg, 2022-04-19:
Hi Dmitry, tnx for the questions. Here is the explanation:

LC stands for load cell, as it is written in firmware_info.txt, all HEX that ends with number 2, has support for HX711 chip, in that case, analog input pin A3 is free and I am doing some rearranging of analog inputs due to that, such that I can use other available analog input pins for buttons for example.

I have to provide replacement pins for Arduino ProMicro, because it does not have pins 12 and 13 that I use in Leonardo. Even though Leonardo has this ICSP header with pin numbers 14-16, those pins are just shorted to corresponding SPI pins on the Leonardo which are 10,12 and some other - that is the part which you are overlooking.

My firmware supports external ADC or DAC with the i2C bus. There are two variants of external ADC available for Arduino. Those are 12bit ads1105 and 16bit ads1115. I'm using ads1105 to read pedal inputs and this is supported in HEX files that have letter "s" in the version. I did not compile such HEX yet, since no one was requesting it. Also I do now want to have to compile a milion versions of HEX files covering all possible combinations of my firmware options. I tried to compile only the most used ones. If one wants, I provided the entire source code and compile it himself or make any changes.

Tnx for all suggestions, I do try to provide all explanations and make them as clear as I can. All my instructions assume at least a basic knowledge of electronics and microcontrollers, since this is not a beginner project.

lazenyuk-dmitry, 2022-04-19:
> My firmware supports external ADC or DAC with the i2C bus. There are two variants of external ADC available for Arduino. Those are 12bit ads1105 and 16bit ads1115.

Are you sure you spell ads1105 and not ads1015 correctly?

I only found schemas for [ads1015 and ads1115](https://forum.fritzing.org/t/adc-ads1015-ads1115/4081).

lazenyuk-dmitry, 2022-04-19:
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

Hat switch this is a D-Pad?
I see where buttons 1, 2, 3 are connected, but I don't see where button 0 is connected.

ranenbg, 2022-04-19:
Yes, you are right it's ads1015. I made a typo, will fix it tomorrow.

Yes, the hat switch is an 8-way D-pad. Button0 is at pin A3 when LC is used (fw-v182) and on pin 4 when there is no LC, that is for all other firmware versions except for fw-v182. I will update the pinout png, tnx for pointing this out man.

lazenyuk-dmitry, 2022-04-20:
> Could you draw or write how you connected ads1105?

How do youuse ads1015?
More or less like this:
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

lazenyuk-dmitry, 2022-04-20:
Here's what I'm getting at the moment)
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

or* - connection differences for the firmware version.

But I think it's still complex, confusing, and hard to edit. I think we need to draw a diagram for each firmware version. Or draw one common to the major version and then draw only schema changes to other versions. What do you think about this?

ranenbg, 2022-04-20:
Hi Dmitry, tnx for this wiring diagram, it is correct. I must admit that I am not a fan of such wiring diagrams at all, that is why I tried to avoid making one and just provide the firmware pinouts. For me, an actual electronics scheme is enough, but for many people that is just way too technical, so I avoided that as well. I think the best would be just to keep the original pinout.png and add individual pictures for the wiring diagram for each external device separately, indicating which firmware supports it, just like you did for ads1015.

The ads1015 wiring diagram looks good, I'm preparing my own, which looks pretty similar to yours but with some useful details, I'll upload it soon.

As for the main/master branch stuff, I'm a total github noob as you can see. This was my first ever repo that I created, I was using gitbash and remote commands, so something got messed up and I never figured out how to fix that. I'd appreciate any help in solving it.

ranenbg, 2022-04-21:
Ok, I have uploaded the ads1015 wiring diagram and compiled a corresponding HEX. I also finally sorted out the branch things, such that there is only 1 branch called master.

lazenyuk-dmitry, 2022-04-21:
> Also, I do now want to have to compile a milion versions of HEX files covering all possible combinations of my firmware options, each time I update the code.

try to take a closer look at this project https://github.com/vsulako/AFFBWheel

It does not compile a million files, but simply writes what changes need to be made to config.h in order to get this or that functionality.

It might make your job easier. You can just flash from source through the IDE.

lazenyuk-dmitry, 2022-04-21:
Can you write to me what firmware versions you want to compile now and what they are for?

For example: fw-v18Xh - hat switch, fw-180 - main firmware and etc.

I want to understand whether it is possible to draw one general diagram and then draw diagrams that reflect which modifications. I think it should work)

lazenyuk-dmitry, 2022-04-21:
And I still really like this implementation of the buttons. There are a lot of them, 32 buttons. They are divided into two lines. For example, it is very easy to place 8 buttons on the steering wheel and 8 on the base, and also make a gearbox out of 8 buttons and place 8 more buttons on the gearbox. That's more than enough buttons and doesn't need to run a lot of wires. And it's cheap on the 74HC165. Do you plan to implement something similar on cheap components 74HC165 or analog?

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

lazenyuk-dmitry, 2022-04-22:
z-index supported in fw version with "z" suffix only?

lazenyuk-dmitry, 2022-04-22:
A4, A5 - button1,2 its only for fw-v180 or and forfw-v18X?

ranenbg, 2022-04-23:
Hi Dmitry, I see you have many question already for me, I'll try to answer.

I want to provide HEX for my firmware in order to minimize the effort required by users with no Arduino IDE knowledge. My firmware is using 4-5 Arduino usb core files which are modified and in order to compile from IDE is required to replace those files, which is not a trivial task at all. I have provided all modified files, used libraries and a full package or Arduino core files for boards version 1.6.21 so advanced Arduino users will be able to use that. For everyone else HEX is easy to upload with XLoader.

All info about what each firmware version support is in the ver_info.txt and ver_info_promicro.txt files. It is possible to make a wiring scheme for the most basic firmware version fw-v180 and make additional ones with specific devices separately.

As I mentioned before and I have written in my instructions, the code for button box that is uploaded to Arduino Nano is simulating shift register chip, so you can in principle just connect two 74HC165 in series and get 16 buttons readout, on firmware fw-v181. With a simple number change in my source code, more shift register chips can be supported, for now HID supports up to 28 buttons (4 of those are taken by HatSwitch, but that can be extended if required).

Buttons 1,2 on pins A4,A5 on Arduino Leonardo are enabled for all firmware versions. Only for Arduino ProMicro, since it does not have those pins, I have moved them to other available pins.

FFB clipping LED is to be connected at pin13 (Leonardo) and pin3 (ProMicro). This pin provides a separate PWM signal (it is not the same as for FFB output) to drive the LED and is not just a simple ON/OFF indicator. I have made a special function for it and this is how it works -  when FFB magnitude is from (0-89)% LED is off, for FFB (90-99)% it lights up linearly from (0-50)% of LED intensity and for 100% FFB it's at the max intensity or LED pin is at 5V. You have to connect LED anode (+) to pin13 and LED cathode (-) to one end of a series resistor for example (220-680)Ohm and another end of a resistor to GND. I have written how FFB clipping LED works in one of the firmware info txt files.

lazenyuk-dmitry, 2022-04-23:
> As I said earlier, I'm not a fan of such wiring diagrams because they have no value to me, I do not want to have to trace some lines and colors to be able to know what goes where. I do think that a simple pinout table for the firmware is good enough and provides complete wiring information.

Thank you for your responses. I agree with you that drawing a wiring diagram is not very convenient. And perhaps even for those who are well versed in electronics, the pinout table is much more convenient than the wiring diagram. But as a person who knows how to simply solder two wires, I’ll say that the wiring diagram is simpler and clearer for me, and the pinout table raises many questions and takes a very long time to figure it out, I even thought to draw a diagram just for myself.

lazenyuk-dmitry, 2022-04-23:
I have almost everything ready. I will prepare all the changes and make a pull request.

lazenyuk-dmitry, 2022-04-23:
I have a question about version 183, you write "but has analog FFB output with 2x 12bit DAC MCP4275". I understand that this is the only difference. Can you provide a pinout table for the DAC MCP4275 or a wiring diagram?

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

ranenbg, 2022-04-23:
Yes, the connection is something like that, except that SDA is at pin 2 and SCL at pin 3. I'll make a wiring diagram for this one and put a differential amplifire to utilze 2xMCP4725 in DAC+- mode, such that output is +-10V which is suitable for AASD.

lazenyuk-dmitry, 2022-04-23:
> This was my first ever repo that I created, I was using gitbash and remote commands, so something got messed up and I never figured out how to fix that.

You can try using a GUI like *[SmartGit](https://www.syntevo.com/smartgit/)*.
Of course, it's good to be able to use git Bash, but the GUI is convenient)

lazenyuk-dmitry, 2022-04-23:
> I'll make a wiring diagram for this one and put a differential amplifire to utilze 2xMCP4725 in DAC+- mode, such that output is +-10V which is suitable for AASD.

 Ok. I just have to make a circuit for the MCP4725.

lazenyuk-dmitry, 2022-04-23:
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

Is it correct that I connected the PWM direction(pin11) to R_EN and L_EN pins on BTS7860?

ranenbg, 2022-04-23:
Tnx for suggestion about SmartGit, I'll check it out.

No, you should not connect bts pwm enable pins to pin11, because in pwm+- mode, this pin is allways low (unused), while in pwm+dir mode it is low when ffb is negative and high when ffb is zero or positive. It should be connected to 5V, the same ss vcc pin of bts.

lazenyuk-dmitry, 2022-04-23:
> No, you should not connect bts pwm enable pins to pin11, because in pwm+- mode, this pin is allways low (unused), while in pwm+dir mode it is low when ffb is negative and high when ffb is zero or positive. It should be connected to 5V, the same ss vcc pin of bts.

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

That's right? VCC connects to R_EN and L_EN on BTS7960?

Then what is pin 11 on the Arduino Leonardo for?

ranenbg, 2022-04-23:
Yes, this bts connection is good now.

Some motor drivers like brushless, H-bridge or AASD for servo motors have the input defined as pwm signal and direction signal. For that use case I made pwm+dir mode of FFB output, where  pin 9 provides pwm signal and pin 11 provides a direction signal.

ranenbg, 2022-04-28:
Hi Dmitry, I have uploaded a new wiring diagram for mcp4725. If all is fine, you can close this thread.

lazenyuk-dmitry, 2022-05-03:
I made a pull request)
https://github.com/ranenbg/Arduino-FFB-wheel/pull/5

Closed 2022-05-03.

Thread 2 (2022-04-06):

Wiring of buttons.

lazenyuk-dmitry, 2022-04-06:
Somehow very difficult in your project with buttons. And you can make more buttons.
I think you could implement the same button connection as in this project like https://github.com/vsulako/AFFBWheel.

ranenbg, 2022-04-06:
Hi Dmitry,

Tnx for your feedback.

My implementation of buttons is the same as in the project you mention. I'm
using a standard shift register protocol, except that instead of shift
register chips I'm using Arduino nano that simulates a shift register and
has 16 buttons. It is possible to just change one line of code and have the
ability to read more than 16 buttons when using shift register chips
stacked in series.

I believe that my wiring diagram shown on the button box wiring png is
clear enough, there is all information one needs, but you are right there
can be improvements I'll think about it and put a better picture. I did
show an example of wiring one button, but the same goes for all other
buttons, not sure what exactly is not clear there to you.

Best regards,
Milos.

On Wed, Apr 6, 2022 at 4:02 PM Dmitry Lazenyuk ***@***.***>
wrote:

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

Closed 2022-04-06.

Thread 4 (2022-04-30):

Have a ads1115 16 bit and arduino uno button box

Armagedon13, 2022-04-30:
Hi and thanks for this firmware, my question is if i can have a ads1115 16 bit [ads datasheet](https://www.ti.com/lit/gpn/ads1114) and a arduino or multiplexer button box and if i can make a button matrix to optimize the buttons in pins like this:
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
And the multiplexer is the 74hc4067 or 74HC595 [74hc4067 datasheet](https://www.ti.com/lit/ds/symlink/cd74hc4067.pdf) / [74HC595 datasheet](https://www.diodes.com/assets/Datasheets/74HC595.pdf) and you can wire multiple by cascading:
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

Armagedon13, 2022-04-30:
Something off topic you can add more flash memory with this: [https://github.com/Marzogh/SPIMemory](https://github.com/Marzogh/SPIMemory) and a cjmcu-2516 module (W25Q16BVSIG chip) add 16 M-bit more memory

ranenbg, 2022-05-05:
Hi, I can compioe a HEX firmware with some custom options, that would be fw-v181hs. It will have support for ads1015 and arduino nano button box for 16 buttons. I did not enable ads1115 because it is much slower than ads1015, but I can if you wish, however you should note that only brake axis is 16bit in HID while other pedal axis are oboy 12bit.

ranenbg, 2022-05-11:
In order to compile my code yourself, this is a tricky part. It took me about 6 months just to compile Fernando's code back when I was starting. You can use the latest Arduino IDE 1.8.19, but I use older boards version 1.6.21. You will have to copy all the avr/core files that I provided and also replace a few USB core files, which are inside br_wheel_my folder. Said files have to be replaced in C:\Users\milos\AppData\Local\Arduino15\packages\arduino\hardware\avr\1.6.21\cores\arduino. You also have to put all required libraries that I provided in your documents\arduino\libraries folder.

Closed 2022-05-07.

Thread 7 (2022-06-20):

Esp32 Upgrade

etempm, 2022-06-20:
Hi, thanks for great work. I want to convert project to esp32.   I can code esp and arduino and want to convert project to arduinoesp framework. What is your opinion about this ? Can be doable, easy or hard ? Thanks again.

ranenbg, 2022-06-20:
Hi man, you are welcome. I think that porting this code to esp32 is an extremely difficult task, but feel free to do it :) There are many Arduino USB core files that I modified. Esp32 will have those very different, so you will most probably have to write them from scratch. Remember, this is low-level C++ stuff, so you have to know your way around HID very well.

etempm, 2022-06-20:
Thanks for pointing me to right direction. I am no so pro low level c++, so I will go with arduino. I have a small problem when compiling. Arduino ide can not find Platform.h file. Where can I find it ? I am using Lenoard.

Thanks for quick reply.

etempm, 2022-06-20:
Finally One more question. VNH5019 is very pricy in my country. I can easyly find BTS7960 here and it is cheap. Can I use this firmware with BTS7960 ? Thanks again.

ranenbg, 2022-06-20:
Yes, as you can see in the description I have provided wiring for BTS7960. What you saw in the code is just some leftover from previous guys that worked on the code, I left it there, but it is commented and VNH5019 is not in use in the code.

ranenbg, 2022-06-20:
Here is some info on what you need to do, that I know so far:

Thread 8 (2022-06-22):

Some New Questions

etempm, 2022-06-22:
Hi again,

I am planing to build wheel with rs997 motor (more bigger one) and bts7960 as I said before. Here I have some questions about build.

1) Is it possible to use AS5600 magnetic encoder (4000ppr) with firmware. It is cheap and more resolution (12bit)
2) Is it possible to use loadcell for brake and throttle pedal together
3) Because of big motor, it will be nice to read currents from BTS. Is there a support in firmware about this

Thanks you again.

ranenbg, 2022-06-22:
Hi man, here are the answers:
1. yes, but I do not plan to do it any time soon
2. probably, you have to do this in the game somehow, I do not plan to implement that in the firmware
3. there is no need to waste main mcu time for this, you can just use a separate arduino and read these voltages and display it on some LCD

Closed 2022-06-23.

Thread 10 (2022-07-28):

Custom code / xbox 360 racing wheel

Leizar06001, 2022-07-28:
Hi,
Great job !
I'm currently trying to modify an old racing wheel I have from the x360, there has never been any driver for the FFB on pc..
So I'd like to do this with as few modification as necessary. This wheel uses one potentiometer instead of an encoder to get it's position so I tried to change bits of your code but I keep getting errors during the compilation, and I tried many things with the files included here, but never get to the end of compilation..
I'm really out of idea now ! :(

ranenbg, 2022-08-01:
Yeah, getting the code to compile error free is a real pain. When I first took Fernando's code back in 2017 it took me 6 months to figure it out. I do not remember anymore the exact procedure and I was only able to get it to compile on 2 PC's, one with windows 7 and other with windows 10. The Arduino boards version 1.6.21, IDE 1.8.19 You have to replace the original USB core files with the ones present in the BRwheel_my folder. You also have to place it along with all hardware avr core files, I have them in the following folder:
C:\Users\milos\AppData\Local\Arduino15\packages\arduino\hardware\avr\1.6.21\cores\arduino
If there are still errors, then at one more place which I forgot where you have to replace USBCore.h and USBCore.cpp files.

Closed 2022-11-03.

Thread 11 (2022-07-31):

Encoder Resolution

etempm, 2022-07-31:
Hi, what is your suggested resolution in ppr? I have 400 and 600 ppr with z index. Also I have as5047p magnetic higher resolution. Is bigger is better, or there is a limit for arduino?

I am making some modifications to work with dd wheel foc controlled. If I succeed, I can share it.

Thanks again.

ranenbg, 2022-07-31:
Hi dude, in principle the bigger the encoder PPR the better, but there is a limit in arduino, regarding how fast it can detect pulses at interrupt pins. This limit is at about 100kHz and very much depends in the max desired encoder rpm. Magnetic hall can be good if 14bit, 12bit is too low, but you have to implement it in the code yourself. There is not enough mcu power to run the FOC loop along side everything I have so far. Even stm32f407 would struggle.

etempm, 2022-07-31:
Foc is working on stm32, simplefoc. It takes inputs from arduino(your ffv).
For optical omron like encoders, so 400 - 600 ppr is not good enought, right?

ranenbg, 2022-07-31:
It is good enough. If you don't mind losing the z channel, you can allways mount encoder via a pulley to motor shaft and increase CPR, you don't need more than 5k, 6k PPR.

Closed 2022-08-01.

Thread 12 (2022-08-01):

Linux FFB support?

HanYangZhao, 2022-08-01:
Hi,

I was wondering if this will work with Linux with FFB? I have previously build a steering wheel with EMC firmware but the FFB did not work on Linux. The reason I need Linux is because I'm using a Steam Deck as a steering wheel.

Thanks

ranenbg, 2022-08-01:
I have not tested it under Linux and I'm 99% sure that it will not work since I did not implement the DirectInput API for HID and PID in full. Your best bet is to have a look at openffb firmware for stm32F407.
https://hackaday.io/project/163904-open-ffboard
https://github.com/Ultrawipf/OpenFFBoard

Closed 2022-08-01.

Thread 14 (2023-05-26):

Force feedback not working

tomascarabajal7, 2023-05-26:
Hi! Great project!
I'm currently having issues with 2 subjects.
1) my force feedback doesn't work. Hardware wise it all moves. But when i try the wheel config app or the i racing one nothing moves or changes. I have everything conected as it is specified. The only time i got it to respond was when i plugged one of the pwm to pin 11 and it made sort of a barrier just in one way. This brings me to my second question.
2) PWM pin direction (or pin 11) is not specified ANYWHERE. I see there is an option in the software tl implement it but hardware wise I don't even know how to connect it.
Thanks in advance!

ranenbg, 2023-05-26:
Hi man, tnx. So to continue answering from my other GUI repository where you asked questions firmware related.

1. You have to upload the correct firmware (HEX file) to your Arduino first. Please have a look at the readme of the FFB-wheel repository, there you have a detailed explanation of how I name each HEX and what it means, which features it supports. For you, I assume something like HEX with fw-v220 would be a good start. As I wrote in the readme, please make sure to upload the correct HEX that is designed for the Arduino board that you use. Micro HEX is only for Arduino ProMicro board, while Leonardo HEX can be used for both Arduino Leonardo and Arduino Micro.

2. Once you upload for example fw-v220, you can configure it using my GUI the desired ffb output option, for that I also made a dropdown menu selection in the GUI, just note that for each change of PWM settings you have to restart Arduino for changes to take place. Depending on which motor type and motor driver you plan to use. I assume you have a DC motor and use it with H-bridge driver like BTS7960, so then just have a look at readme, there I have put a detailed wiring diagram for this case. In the very first image in the readme, you can see the pinouts for the firmware, by default PWM+- mode, you will have pin9 as left PWM signal and pin10 as right PWM signal. If you want to utilize the direction pin then you have to select PWM+dir mode in my GUI, where PWM signal is on pin9 and direction signal will be on pin11. Note that I made firmware in a way that configuring everything in Arduino takes place via serial communication, so in principle you could use any other software cable of serial configuration to configure it, you don't have to use my GUI if you don't want. Then I would refer you to RS232commands.txt for more info about it.

I hope this answered all your questions, but if you have more, I'll gladly answer. Take some time and read the manuals, txt files and readme more carefully, I have explained pretty much everything there.

tomascarabajal7, 2023-05-26:
Excellent answer! Thank you very much :)
I understand now that i hD the wrong firmware. Apparently i was so tired that night that choose the wrong one hahaha.
Besides that i still don't understand how the direction pin works at a hardware level 🤔. I have a bts 7960 and I've wired it exactly as the diagram shows.
Also I'm new to ffb wheels so there are some things that i don't quite understand. For example, if i choose "c" (hardware wheel re center support, do i need to wire some sort of switch? Or the program will remember where i set las time the center and use that?.
Sorry if this seems silly but my wheel almost killed me last night hahahaha

ranenbg, 2023-05-27:
The "c" version firmware gives you two ways to reset your wheel's center position (0 angle), by hardware using a switch, or by software in GUI by pressing center button. As this firmware doesn't utilze a 3rd channel of an encoder called z-index you will have to center the wheel after each powerup. If you do have an encoder with 3 channels or with a,b and z you could use "z" firmware version, there it would automatically find 0 angle as soon as a z-index pulse from encoder is detected.

For your bts7960, I recommend the following PWM settings: fast top, 8kHz and PWM+-. You should not use PWM+dir mode with it, as this mode is designed for other type of motor drivers like ac servo motor driver or some other that need that kind of control input. Briefly, PWM+dir mode works in a way that PWM provides and absolute magnitude of the FFB signal (always positive) and dir signal gives the sign (direction) of the FFB signal. In my firmware, on dir pin 0V - left direction and 5V - right direction, while PWM's duty cycle represents 0-100% of FFB signal.

Just take your time and be patient, once you setup your wheel correctly you will enjoy it very much. It's very rewarding feel and this effort pays off in the end.

tomascarabajal7, 2023-05-30:
Thanks again for the great answer 👏😁.
I made it work and it's awesome! In some games its dull but older ones like assetto corsa or my fav Race Room it's EPIC how i can feel every detail! 😍🥳🥳🥳.
I still need to figure out a way to keep the belt tensioned or it skips steps 😅. I think i will try printed gears instead. Any advice?
Also the version with the nano wheel works FANTASTIC!.
I'm from Argentina and wheels with FFB are soooo expensive so I'm enjoying this thing A LOT!

ranenbg, 2023-05-30:
You're welcome. I strongly recommend you to try LFS (live for speed), in my opinion this is the best sim with the best ffb and demo version is free, there are a lot of servers to chose from, plenty of players from south america. Assetto corsa does have a decent ffb, but LFS has even better while online gameplay and overall game experience is many levels above.

I tried using gears. The only gear type that makes sense for this application is a Herringbone (double helical) gear, but those are very difficuilt to 3D print correctly. It may be better to stay with belt + pulley system, because it allows you to have some imperfections in the mechanism. People make spring loaded dummy pulley made out of M5 or M5 screw and some bearings to keep the belt tightened. Try HTD 3M or even 5M with 3mm or 5mm tooth spacing, these are timing belts and pulleys with l, that DIY community uses the most. Usually people buy small 12 tooth aluminium pulley that goes on motor shaft and design and 3D print their own big pulley with 60+ teeth.

By wheel with nano, I think you are talking about a button box firmware for arduino nano which allows connection of up to 16 buttons. Yeah, it took some effort to make that working correctly and not waste too much of the MCU time in the main board firmware.

tomascarabajal7, 2023-05-31:
Thanks for all the info! I will check that sim out!
Im using a 12tooth and a 60tooth. I'm thinking of printing a few gears for the encoder. I was able to tighten the belt for the motor but it was a pain in the ass haha 😆.
Now i get all range, no skipping and even the psu has a hard time keeping up (12v 10A) with the dc775.
I think i will add a second motor but donno what to do with the psu... Maybe a pc one? 😅.
I will still try gears at some point cause in my country pulleys are hard to come by, expensive and more so for thicker ones.
And so if it is meant for Thrustmaster... Will it be possible to use Thrustmaster wheels? Just for curiosity haha.

ranenbg, 2023-05-31:
Please, let's keep the disscussion only to firmware related things.

In principle Thrustmaster wheel rims should be compatible with my firmware, but one has to be very careful because TM wheel rim operates at 3.3V and Arduino is 5V, so some bidirectional TTL level converters must be used for every signal line between arduino and a wheel rim.

Closed 2023-05-31.

Thread 15 (2023-06-09):

Wheel Control 2.1 doesn`t show FW version.

RomanFolab, 2023-06-09:
Wheel Control 2.1 doesn't show the FW version.
Was uploaded "brWheel_my.ino.leonardo_v14"
Im using Arduino pro Micro

ranenbg, 2023-06-09:
Hi, if you look closely into the readme of GUI in my other repository, you will see that wheel control v2.5.1 is only backward compatible with Arduino HEX firmware down to v170. The HEX version you have now v14 is ancient, this was way before I introduced the firmware recognition features. You have to update to the latest firmware, for example, v220m, this is suitable for your Arduino ProMicro. Please have a look at the pinout diagram to avoid wiring confusion.

RomanFolab, 2023-06-09:
Hi
I have uploaded v220m and received from wheel control next massage
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

Closed 2023-07-05.

Thread 16 (2023-07-05):

About open programming

Zigandbee, 2023-07-05:
I wanted to know how I can edit that open schedule I put nor do ID is but a lot of errors appear I use 1.8.13 ide . What do I have to do to be able to edit it and then compile .I wanted to do a different project.

ranenbg, 2023-07-06:
Hi, I have described the procedure of compiling the source in Arduino IDE in section "how to compile the source code" of readme on GitHub.

Thread 17 (2023-07-06):

pwm frequency question

ernest-cpu, 2023-07-06:
What is the max pwm frequency and resolution in your firmware? I see in the data sheet the best I can get out of the 32u4 is 9.6bit and 20khz pwm frequency on a 16mhz pro micro. It makes sense to use 20khz because you don't want a really whinny motor. Does it make sense?

ranenbg, 2023-07-07:
Hi dude, yes it does make sense. I have put detailed information about the available PWM frequencies of my firmware in the documentation. Have a look at firmware_info.txt in the docs folder, there are plenty of PWM options to choose from.

ernest-cpu, 2023-07-07:
How does fast compare to phase correct? I would imagine that it might cause the wheel to be more noisy but the forces should feel finer?

ernest-cpu, 2023-07-07:
I was imagining 800 steps in one direction not dived in half haha

ranenbg, 2023-07-07:
Fast PWM has random small glitches even when there is no PWM signal. This is however no issue at all for DC motors with bts7960, thay anyway require some min voltage to start spinning.

It is 800 steps per direction, since there are two PWM channels which are used in PWM+- mode.

korvolle, 2023-07-08:
Im

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

I have a motor controller that only accepts "RC PWM". Would this work to connect to that controller? Sorry for this dumb question, im not good at electronics at all

ranenbg, 2023-07-08:
It's not a dumb question at all. Sometime in the past I have added this special PWM mode for RC servos or RC ESC, I call it in my firmware RCM.

You can use it for your motor driver, there are plenty of frequencies to chose from. Normaly, in RC world they use 50Hz for this PWM signal, which is good enough for human control (20ms update rate), but it's very low for FFB signal. In theory, max supported frequency for RCM mode is 500Hz which is exact match with the FFB update rate of my firmware. Since I can't check all possible drivers myself, you may want to experiment with your driver and see which frequency it likes the best. I wouldn't go lower than 100Hz.

korvolle, 2023-07-08:
Thank you so much for the reply! Its actually a hoverboard motor driver that i will use for this project. I will update with how it goes once i get it working :)

korvolle, 2023-07-08:
Btw i just noticed that your firmware has support for DAC output and the custom firmware that i will use on the hoverboard controller has support for ADC input, wouldnt that work better than PWM you think?

ranenbg, 2023-07-08:
Ah I see, good. I think that you will need to calibrate the driver, such that it knows which PWM duty cycle corresponda to 0 force and which for max left and right forces. You can use autocenter spring for this, with enabled ffb realtime monitor amd just move encoder untill you get desired ffb outputs, for the driver calibration procedure. As I'm told, this is quite tricky to do. So pls, do update

ranenbg, 2023-07-08:
Yes, you can use external dac. I don't know which is better, you may want to play with this as well. PWM signals are less prone to external noise. If you go the analog way, you will have to pay special atention to shielding all the wires that cary ffb signals, in a similair way as you would do with audio signals before the amplifire.

Closed 2023-07-24.

Thread 18 (2023-07-07):

Dual bts7960

tomascarabajal7, 2023-07-07:
Hi i have an issue with my dual motor Setup.
I've connected 2 bts7960 to two dc775 and every wire that comes from the Arduino in parallel. And when it hits an end (either right or left) it's starts to spin like crazy randomly. But if i use spring or centering effects it just works. The problem it's, for now, only on the ends.
I believe there could be 2 reasons but please enlighten me 😅. First one could be that there is some sort of lag between the two drivers.
And the second one could be the wiring. In this one i will like to add that for the first driver i used the shunt resistors you specify on the wiring diagram and in the second one i didn't bother. Could this be the issue? What are this shunt resistors used for?
Thanks in advance 👏🤩

ranenbg, 2023-07-07:
Hi man, yeah, interesting behaviour. I recommend to first use only 1 bts7960 and 1 RS775 motor, untill you make it work as intended. Then you may try adding one more bts in parralel to PSU and to Arduino PWM output pins. Endstop force is very similair to a spring force, the only difference is that it gets activated when the encoder hits the ends of the axis, the force should

tomascarabajal7, 2023-07-07:
Thanks! So quick! Haha.
I had the wheel working with two motors and one bts but the bts burned one of the chips so it only worked on one side haha.
I will check the cables again but everything is jumped from the connection i had that worked fine. Any othe ideas?
And i will take the shunt resistors off then 😅. I misunderstood from the diagram that i SHOULD have them connected.

tomascarabajal7, 2023-07-07:
I'm using exactly that, 12v 40A and keeping it to 0.7 overall strength. And from what I've researched 775 has a max of 15A, so two of them would be safe for a 7960.. but i was wrong apparently haha. Also both are cooled with a blower so as they don't spin they are still cooled.
I donno really where this issue could be coming from... Again, I'll try cables.. but could it be that the two bts have a delay? I'm loosing my mind haha. If i plug just one it works fine.

ranenbg, 2023-07-07:
I'm not exactly sure, but I think that stall curent for RS775 is much higher than 15A. It is a 300W motor, so it depends on the voltage. It's coils should be good even at 30A. The issue is that in FFB wheel application motor is barely spinning and is not able to cool its coils with airflow created by the fan at the back of the shaft.

Also the issue with bts is that it comes with a horrible cooling solution. You may think that it's fine as heatsinc is not even warm, but the fact is that heat is not conducted well from mosfets, causing them to overheat and die long before heatsinc gets warm.

tomascarabajal7, 2023-07-07:
Hahahaha yep! I have 80mil fan just for the driver and also did glue some of those small heatsinks that comes with 3d peinters but with 2 motors it just died wile racing hahaha.
Now the solution and also the problem is to use 2 of them, one for each motor... But after taking out resistors and checking wires it goes crazy when it touches the end 😅💔

tomascarabajal7, 2023-07-07:
Solved it! 👏😍.
Problem was... Wait for it... Damper Gain in wheel control 😅. It was in 0.6, lowered it to 0.3 and done! I also changed the Min torque % to 5.5 As you recommended. That for sure did something but to be honest i don't really know what most of this values do ✌️🤣. If you can explain this one it would be great.

Again... Im so happy with this project and your kindness to always help so quickly. You have earned heaven my friend! Have a nice weekend!

ranenbg, 2023-07-08:
Tnx man. Unfortunately, I don't have much time for my hobies at the moment, so I will not be writing a detailed explanation for every slider and button in my gui. I tried to make it in a way to be very intuitive to use and self explanatory.

The beat is to first read manual.txt for the gui. There I explained all important stuff and how to use it. In principle, every slider on the right is a gain for each FFB effect and there is a possibility to enable some of those effects as "allways on", also called user or desktop effects. In my gui, you can enable/disable these with a square button next to a slider. These are damper, inertia, friction and auto center spring. For a DC motor, I do not recommend to use any of those. You can leave auto center spring enabled, because thos one is special in a way that it is automaticaly turned off, as soon as a game or other application takes over the ffb control.

tomascarabajal7, 2023-07-17:
Hey! I've been doing some testing... Apparently the problem is that the motors spin too fast. This i should fix it by changing the gear ratio from 4:1 to 8:1 or something like that.
The motors without the actual wheel attached to the shaft spun out of control. Once there is some weight to it doesn't go crazy.
Besides that i believe there is something to add to the firmware. The force feedback should cut after a certain threshold. Otherwise if the system looses position it just keeps spinning forever and braking everything into pieces. I believe, if possible, this could add some layer of security.
Maybe something simple as a condition that contemplates some extra margin after the set maximum (for example if you set 900deg it should be 50 deg extra, or something like that) and when exceeded the ffb dies.
Something to add more security.
Thank for your time! I hope this helps :)

ranenbg, 2023-07-17:
The question is where you mounted encoder. Arduino has a certain limitation above which it can no longer detect pulses from encoder. But yes, you are right there could he some sort of software detection of curent angle and a safety that cuts off ffb in case of emergency. Usualy these stuff are handeled by the motor driver, but since bts is simply a brainless amp, it must be done somehow with arduino. I'll think about it and see what can be imolemented.

Closed 2023-09-13.

Thread 19 (2023-07-24):

.

vortex464, 2023-07-24:

ranenbg, 2023-07-24:
Hi dude, first of all, it is pointless to post such a long compiler error list. I see that you didn't read my reply for your question about how to compile the source code. I'm copy pasting the instructions I wrpte in the readme file of the repository.

How to compile the source
In order to compile the firmware yourself you may use windows7, 8, 10 or 11, you need to install Arduino IDE v1.8.19 and Arduino Boards v1.6.21. You must place all [libraries](https://github.com/ranenbg/Arduino-FFB-wheel/tree/master/arduino-1.8.5/libraries) in your .../documents/Arduino/Libraries folder. In windows folder options set to show hidden files and folders then navigate to C:\Users\yourusername\AppData\Local\Arduino15\packages\arduino\hardware\avr\1.6.21\cores. Rename the folder "arduino" as a backup as we will need some files from it latter, I just add "arduino_org" to the filename. Create a new folder called "arduino" and place the entire content from [modified core](https://github.com/ranenbg/Arduino-FFB-wheel/tree/master/arduino-1.8.5/hardware/arduino/cores/arduino) into newly created "arduino" folder. Navigate back to "arduino_org" folder and copy files "IPAddress.cpp", "IPAddress.h", "new.cpp" and "new.h", then paste and replace the ones inside the "arduino" folder. That should fix all errors and you should be able to compile the code. Bare in mind that if you make any changes to HID or USB core files you will need to repeat the procedure and paste all modified files in the newly created "arduino" folder each time.

ranenbg, 2023-07-26:
Make sure to install Arduino boards 1.6.21 and copy and paste all the modified files to the correct location. Also make sure that in your Arduino IDE sketch, you have all the tabs with .h and .cpp files.

Closed 2023-08-24.

Thread 20 (2023-07-25):

Inverted FFB issue

EliDev05, 2023-07-25:
Hi, congratulations for the project!
Really well documented, and it's the only Arduino based FBB wheel firmware that is plug and play and user friendly.

I have only one problem, that's on the force feedback direction. When I connect BTS9760 R_PWM and L_PWM pins according to given scheme (so R_PWM to Arduino pin 10 and L_PWM to pin 9) and power up circuit, connect Arduino and open wheel control program, if I turn the wheel to left the motor starts rotating left instead of right, vice versa if I turn the wheel right.
If I swap R_PWM and L_PWM pins (so pin 10 for L_PWM and pin 9 for R_PWM), the FFB start to working good, so if I turn the wheel to left the motor starts rotating right, trying to re-center the wheel.

My question is if it's a problem swapping the R_PWM and L_PWM pins or maybe there is an "Invert FFB" option somewhere.
I'm using Arduino Leonardo.

Thanks.

ranenbg, 2023-07-25:
Hi, thank you very much. Do not change Arduino or BTS PWM pins, just swap the motor wires :) It's just a DC motor and it has no polarity so you can connect it the way you want. To invert ffb, you simply reverse motor direction, that's all.

Closed 2023-09-13.

Thread 22 (2023-07-29):

Reduce torque

jwinfieldnz, 2023-07-29:
Great project! I built a steering wheel using a cordless drill. It seems to have worked out of the box which is great. This is my first project with FFB and am a bit lost so apologies for the N00B questions. Being a cordless drill it has finger amputating torque. Which would be the best setting to tone down the power?

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

ranenbg, 2023-07-29:
Hi man, very nice build, tnx for sharing. Master control for overall ffb strenght is general gain slider, about 0.5 should be good starting point.Play with it first to find a good feel, then you can add a little bit of min torque slider to compensate for the ffb deadzone in low forces, about 4-5% should be enough.

jwinfieldnz, 2023-08-02:
Great I found it. Here is a video of my project. Not an issue technically: https://youtu.be/vo7tVuBD-hI

jwinfieldnz, 2023-08-03:
[Hackaday](https://hackaday.com/2023/08/03/force-feedback-steering-wheel-made-from-power-drill/) picked it up as well so that is cool.

Closed 2023-08-02.

Thread 23 (2023-08-02):

open

vortex464, 2023-08-02:
hello, my project needed a special firmware so I modified yours but I have a question for you to send the configuration data did you use 100% serial connection? How did you make the Arduino not crash with too much information. I also modified the force feedback to peg to get the "torque" I used the already existing torque variable is it the best option?

if (torque >= 0) {
        motorffb.TurnRight(abs(torque));
      } else {
        motorffb.TurnLeft(abs(torque));
      }

ranenbg, 2023-08-02:
Hi, congratulations on compiling my firmware, you are the 1st one  so far who managed to do it :)

I'm not sure that I understand what do you want to do with your project. Yes, I'm using virtual serial port connection to configure everything and send the ffb single value data, for the purpose of the feature of my gui called ffb real time monitor. Arduino is receiving serial comands that are terminated by CR, processing them and then sending the response terminated by CR+LF, there is no reson to have a crash. Each config data is sent individually. The difference is only in ffb monitor or torque data, once you send the comand to arduino it starts sending data continously, which requires some smart coding on the receiver side, you can have a look how I solved that in my gui.

vortex464, 2023-08-02:
It was exactly what I needed to modify the FFB, I just wanted to know if I collected the correct value I used the value I found "torque",. in serial communication I already understood!

Closed 2023-08-24.

Thread 24 (2023-08-03):

Hall effect support

jwinfieldnz, 2023-08-03:
I am not sure if it is tuneable in Arduino-FFB-gui but I would like to use hall effect sensors for the pedals. The problem with these (the ones I have anyway) is the quiescent voltage is around 3.2v and goes up maybe 1-1.5v to 4.2-4.8v. I was going to use a rail-to-rail op-amp or even a slave Arduino to convert the voltage but if this could be done in Arduino-FFB-wheel that would be awesome!

ranenbg, 2023-08-03:
Hi, you can use firmware with manual pedal calibration, there you can set the range for each pedal axis using the gui. Arduino analog input will read 0V to 5V in 10bits, so you should be use those hall sensors. The only downside would be that once you do the range calibration you can be left with a small number of steps, but even with 200-300 steps left out of 1024 it shpuld be still usable. Logitech pedals are 8 bits anyway (256 steps).

jwinfieldnz, 2023-08-03:
Actually, I just clicked on autocal and worked perfectly! 4096 steps. Hate to go OT but one niggling issue is the wheel in the GUI tool turns about 25% faster turning one way than the other. Maybe it is the encoder I am using.

ranenbg, 2023-08-03:
Ok, good, pedal autocalibration is done on every powerup, it just dynamicaly looks for min and max values and keeps the calibration only while arduino is powered. On each powerup, you just press all pedals full range and it will calibrate itself.

Yeah, that is interesting situation. You should check in DXtweak and maybe have to do reset device default calibration, encoder axis is Xaxis and it could be that something went wrong there. Then in gui you only have to set correct encoder CPR, desired rotation degrees and recenter.

jwinfieldnz, 2023-08-22:
Seems unless I have the encoder sensor perfectly parallel to the encoder disk it will turn further one way than the other. It must have some sort of parallax error.

Closed 2023-08-22.

Thread 25 (2023-08-19):

Hello,

BobbysRoss, 2023-08-19:
Hello,

in PWM + DIR on pro-micro, Dir seems to be not working.
Arduino is fine tho. On dual PWM both pins work.
Just on PWM+Dir, Dir stays at 0V while direction change.

Unbeliveable Work btw! Really love it!

Closed 2023-08-20.

Thread 26 (2023-08-24):

z index

vortex464, 2023-08-24:
How Encoder z-indexing works how it works

ranenbg, 2023-08-25:
Hi, this is a very general question. The answer consits of 2 parts, one is understanding the hardware or how the encoder with 3 channels work and which signals it outputs on A, B and Z channel, this I will assume you already know.

Now the 2nd part is about firmware, or a routine which I implemented to support such encoders. The idea is that z-index pulse is always triggered at a fixed angle of encoder. Since the slit in z channel on encoder disc is very small, we can say that reaching towards this angle from both directions of rotation will trigger z-index pulse the same way. In practice, this is true for 1k ppr encoders, but for 2.5k ppr or above there may actually be 2 distinguishable angles, z+ and z-. To avoid this issue, I recommend to allways search z-index pulse from the same direction as when doing first z-index offset calibration. Depending how you mounted encoder on your wheel shaft this angle may end up anywhere inbetween 0-360deg, so you have to tell the firmware  how far is this angle from the actual zero angle of your wheel shaft. This you do by pressing z button in gui, then save. That way arduino will save this z-offset and store it in eeprom, such that on next power up as soon as z-index pulse is detected, this offset will be applied to the curent angle and voila, that's it :)

Closed 2023-09-13.

Thread 27 (2023-08-26):

SPI version of button box

jwinfieldnz, 2023-08-26:
It would be great to have a SPI version of the button box firmware. So rather than use "DT," "CLK," and "PL" you could use SPI and then use something like a NRF24L01 to communicate between the wheel and the Leonardo removing the requirement to try and run wires up the steering shaft.

ranenbg, 2023-08-26:
Hi, I agree, it would be great for sure :) I'm not going to be  implementing this, I don't think here is enough memory left. You may go ahead and add it ofcourse.

ranenbg, 2023-08-27:
I did have a look into this, to maybe try to get the NRF module working on the Arduino nano, but again, even nano has SPI pins used for the shift register communication, so I really see no easy possible way to add this module anyway.

RaceMax, 2023-08-29:
Hi there. What about if, connect 2 slave boards to the master board? Or even use separate boards for different tasks with additional power supply ( plug in to one usb hub to connect PC) ?

Warning - I'm a noob yet) But  it's intereting project, and I get started ).. , now stuck with choosen fw version for fist prototype...

ranenbg, 2023-08-29:
Haha, you wild ideas RaceMax :) Well, in principle Arduino Leonardo has 2 communication interfaces, one is i2C and other is SPI, so one could implement a 2 way communication using both. In theory, one could attach one more Arduino to each of those and offload some of the tasks, but this is way out of the scope of my project. If one needs more procesing power then switching to another microcontroler is a much better idea. There are plenty of ffb wheel firmware for STM32F407, like OpenFFB, VNM, EMC or MMOS.

For start, you can use HEX fw-v220 for Leonardo as this is the most basic and easy to get setup. You only have to connect encoder to get some functionality and first signs of life.

RaceMax, 2023-08-29:
Thanks for answer) I'm only on start and so badly in theme.

to topic: "...NRF24L01 to communicate between the wheel and the Leonardo..." - thinked about that trick, but, if removed wires from wheel, needs other microcontroller and power supply on the wheel, is in't?

jwinfieldnz, 2023-08-29:
With the SPI pins on the leonardo already populated it sounds like it is dead in the water. You wouldn't use the shift register on the nano if you were using SPI maybe? I think a curly cord is a solution. It would just be cool to have a quick release with out having to plug in a cord. First world problems:)

ranenbg, 2023-08-29:
Yes, if say I make an SPI version of button box, I need to free up pins 11, 13, 7 which means no PWM+dir mode, no FFB clip led indicator and no digital button on pin 7. It's not that much of a sacrifice, but another problem is I'm at about 95% of used memory already. Once I start adding libraries required for NRF it will probably get passed by 100%, then I would need to start cutting down other features which I'm not a fan of.

RaceMax, 2023-08-29:
Just theoretically. Replace Nano with Nano 33 IoT or some other BLE models?

ranenbg, 2023-08-29:
Yes, it's a good idea, but that's only 1 part of the story. Still, a transmitter board and ble devices (inside wheel rim) need to be coded and an appropriate communication format has to be developed, which I really do not have time or motivation to get into.

Closed 2023-09-13.

Thread 28 (2023-08-29):

Rotary encoder pos stuck outside of range

Cle4tle, 2023-08-29:
Hi, I have a problem where my rotary encoder's position is outside 0-65k, I can't seem to return it to within that range no matter how much I turn the input shaft (both ways). Resetting to default in DXTweak2 doesn't work. The rotary encoder is working when I test it with an Arduino UNO.
I have tried pushing the reset button on the Leonardo, unplugging and plugging into the pc, restarting my pc. I have not tried re-flashing the Leonardo, a different rotary encoder or a different Leonardo.
When press b in wheel control it shows that it is at 65535 same thing is shown in DXTweak2, otherwise it is centered at 32767
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

Cle4tle, 2023-08-30:
ay reflashing and doing all that worked, thanks man.
Also, I used the center button and the c command before, but it was still not getting any input. So I just tried every command, “b” and “c” were the only ones that did something.

Closed 2023-08-30.

Thread 29 (2023-09-12):

Encoder help

tote46, 2023-09-12:
Hi i have a problem in which my encoder only reads movement clockwise even if irl i spin it clock wise or counter clock wise , what could it be?

ranenbg, 2023-09-12:
Hi, the encoder will only turn in one direction when only one of its two channels is connected. Check your encoder wiring again and it should be fine, given that encoder itself is working ok.

tote46, 2023-09-12:
Hello I checked and it seems wiring is OK, I've tried everything: connecting a and b phase to respective pins, only works one side , inverting connections, still only works one side, connecting a phase only still the same, connecting b phase only still the same.
I have not tried using pull up resistors as I do t have 10k resistors rn, for my encoder might be a must because is an open npn collector.
Also wheelcheck and other axis showing apps don't even recognize any movement, only arduino gui recognize some move.
Also I'm having problems with other axis,  when connecting some analog Hall sensors, they work they output voltage but for example braking axis triggers Y, RX and the other axis in app.
Also even when everything is unconnected only leonardo is on, the app triggers the 20 button. When I connect hall sensor and use a magnet near it it changes the trigger from button 20 to button 22 so it seems like it's detecting it like a button?

tote46, 2023-09-12:
Could it be I'm flashing it wrong? Do I need to restart pc o do something after ploading firmware?

ranenbg, 2023-09-12:
Which firmware did you upload? I'm 99% sure you uploaded the wrong one :)

tote46, 2023-09-12:
Hi ye i uploaded the last one as i thought it was the most refined, i plan to use only steering axis and some analog axis for pedals. Which one should i use?

ranenbg, 2023-09-12:
Yes, exactly as I suspected :) You uploaded probably v223. This firmware expects an i2C communication device like a DAC or ADC, if you don't connect one then the firmware will just hang.

For your use case, I recommend vanilla firmware for Leonardo v220.

tote46, 2023-09-12:
Now I feel bad cause you're right lol you spend lots of time doing this and I want it to work right away doing nothing , sorry.
Ok gonna try that one.
I'm having problems with my bts 7960 as I cannot make it work, I have a cordless drill motor 18v and a atx psu, both have thin wires so maybe I cannot get sufficient current flow , do you know anything bout this? Idk how to test if it's a psu problem or pwm pins problem how can I check that?

ranenbg, 2023-09-13:
You opened the encoder help issue, which I think we solved now, so I'm going to close this one.

As before, first, go through all the previous issues. Many people already asked about BTS7960 wiring and troubleshooting, there I went into details on how to check things. If you still have some questions you may open a new issue. Yeah, generally you want to put the correct wires that can support 10A at least between BTS and the motor. Getting a cheap multimeter is a good start. You have to be able to measure the voltages at least.

Closed 2023-09-13.

Thread 30 (2023-09-12):

Rename device

jwinfieldnz, 2023-09-12:
Is it possible to rename how the device appears in Windows from Arduino Leonardo to something like "Handbrake HID"?

Would it just be a case of changing the name in `add_to_boards.txt` and compiling?

ranenbg, 2023-09-12:
Yes and yes.

jwinfieldnz, 2023-09-22:
Doesn't seem to work, unfortunately. I got it to compile okay but the name is stuck with the default, I updated it in boards.txt manually also. Plugged into another PC also to check it wasn't cached in Windows or something. Just in case anyone else tries it.

Closed 2023-09-12.

Thread 31 (2023-09-15):

Raspberry pi pico with arduino firmware support?

smahdink, 2023-09-15:
As the title says, will this project work on a pico that runs arduino firmware and is flashed with this?
Thanks

ranenbg, 2023-09-16:
Hi, that's an interesting idea. I didn't try this myself so I have no idea if it would work, You can give it a try and please let me know how did it go.

However, I'd be very surprised if it would go without any compiler error, after all, these are two very different MCUs.

Closed 2024-09-09.

Thread 32 (2023-09-21):

Hall sensor encoder

tote46, 2023-09-21:
sorry to be bothering again lol, i cant get to work my encoder so im looking for some alternatives.
Will a hall effect encoder work?

Closed 2023-09-23.

Thread 33 (2023-09-23):

X Axis troubleshooting (?)

tote46, 2023-09-23:
Hello, i having a problem with games reading X axis (encoder axis i guess), both in AFFB GUI and some other apps like WheelCheck, DlView,DxTweak and even in windows calibration X axis is read, but it seems like games (Automobilista 2 and F1 2023) cant read it for some reason.
Leonardo board and analog inputs are readed and work just fine, i made some pedals with hall sensors and potentiometers and they work fine in both games.
What can i do?

ranenbg, 2024-05-06:
Hi, give it a try with new firmware HEX v230x and wheel control 2.6.0 and see if this helps. It seems like a non-firmware related problem, more like something to do with the automobilista 2 if windows and both wheel control report X axis movement correctly.

Closed 2024-09-09.

Thread 34 (2023-11-02):

Pomoc

dericakasapin, 2023-11-02:
zdravo brate, vidim da si moj sugradjanin i ako mi ti ne pomognes ne znam ko ce. U glavnom imam problem sa enkoderom i arduinom. Sve radi ali enkoder nikako ne moze. Kad stavim na pinove 2 i 3 radi ali na tx i rx nece nikako. Da li je problem u arduino ploci ili kodu. Da li je moguce da se neki hex kod izmeni da bih mogao da stavim signale na pinove 2 i 3. Ne treba mi ffb dovoljno mi je da imam volan gas i kocnicu. Ako ovo vidis mnogo bi mi znacilo da mi pomognes. Hvala u napred

ranenbg, 2023-11-03:
Cao Zemljace :) Najpre budi siguran da si uploadovao HEX v220 ispravno, mozes videti u mom wheel control programu verziju firmware-a. Sledece stavi pullup otpornike na kanale A i B od enkodera, mozes da probas od 10k do 1k bilo koji. Ne mogu da promenim HEX i prebacim enkoder na pinove 2 i 3 jer pin 3 nema hardwerski interupt, a pin 2 vec koritstin za Z kanal od enkodera.

dericakasapin, 2023-11-03:
zaboravio sam da napomenem da enkoder brojis amo u pozitivnom smeru bez obzira na koju stranu okrecem. Hvala na informacijama, probacu ovo pa se javljam!

dericakasapin, 2023-11-03:
Da li je moguce da mi je crkao neki od pinova ex tx, jer nikako nece da radi, a radi sa obicnom kodom koji sam nasao za testrianje enkodera na pinovima 2 i 3?

ranenbg, 2023-11-03:
Da, moguce je da je jedan od Tx, Rx pinova mrtav. Ako ti registrure pomeraj enkodera samo u jednom smeru, to znaci da jedan od kanala A ili B nije registrovan.

ranenbg, 2024-05-06:
Again, once more the user hardware-related problem, has nothing to do with the firmware itself, so I'm closing the issue.

Closed 2024-05-06.

Thread 35 (2023-12-13):

Pwm pins issue

Hulababa-22, 2023-12-13:
Hi so i have an issue where the ffb of my wheel doesn't work if i turn my wheel clockwise. after some diagnosis i think its the pin 9 on my arduino that is broken, can you change the pwm so it uses pin 11 and 10 instead of 10 and 9? so it will be 11 for rpwm and 10 for lpwm. or add a feature to choose pwm pins?

ranenbg, 2023-12-13:
Hi, unfortunately, it's not as simple as that.

I can't change the PWM pins, because not all PWM pins are the same. These, pin9 and 10 are connected to TIMER1 in Arduino which is the 16bit timer, other pins are connected to 8bit timers. What this means is that only on pins 9 and 10 you can get a PWM signal with enough resolution and frequency that makes sense for an FFB wheel.

Just buy another Arduino :)

Hulababa-22, 2023-12-13:
oooh ok ok thanks for the answer and can i ask is it possible to run this firmware with a stm32 board?

ranenbg, 2023-12-13:
No. I didn't invest time into porting the firmware to stm32 microcontrollers, because there are already 3-4 such firmware that are available. For example openFFB, vnm, EMC or mmos.

Closed 2023-12-13.

Thread 36 (2023-12-14):

Force feedback stops working

Matteo2607, 2023-12-14:
I encountered a problem while using the software. When I connect the Arduino and start playing everything is ok, but as soon as I hit a curb, or a sudden change of direction or in any case a rapid variation, the force feedback stops working. The peculiar thing is that only the force feedback stops working, while the encoder and pedals continue to work, but to solve the problem I have to disconnect and reconnect the Arduino, which is a problem in the race. Is there any parameter I can change to fix the problem? or some other firmware version to use?
I currently use 200a.hex
the configuration is as follows:
Bts7960
arduino leonardo
24v 500w dc motor
encoder 1024ppr

ranenbg, 2023-12-14:
Hi, that seems wierd, I didn't come across such issue. Which game is it?

Firmware v200a is not the lattest, give it a try with v220a.

Matteo2607, 2023-12-14:
the problem occurred on the racing set-up and the competition running set-up.
trying to do right left quickly in the gui I encountered the same problem.
Now I will try with the 220a.
And I make a video with the problem.

ranenbg, 2023-12-14:
You have to be very careful, with such a powerful motor. It has a big back EMF, it can easily generate voltage above 27V which is dangerous for bts. You may want to look into some brake resistor circuits.

Matteo2607, 2023-12-14:
The encoder Is okey.
This is the video, where u can see the issues.
https://streamable.com/jlf024
https://streamable.com/q7wzlg

ranenbg, 2023-12-29:
Unfortunately, there is no information important for me to see what is the actual problem. You didn't mention the conditions of when this happens and if it is reproduceable. Try enabling ffb monitor in wheel control and follow what happens with ffb signal. See if you can pinpoint moment when the ffb cuts out.

Matteo2607, 2024-01-03:
Hi, sorry for my absence. I solved the problem by setting the ffb to approximately 50%, and the minimum force to 3%, in this way the problem does not arise.

ranenbg, 2024-01-03:
Great that you managed to solved it.

So the issue was due to your hardware, probably something was either overheating or entering into some sort of protection, overcurent or overvoltage.

ranenbg, 2024-01-03:
I'll close the issue as it was not firmware or software related.

Closed 2024-01-03.

Thread 38 (2023-12-23):

sharing what I'm experiencing and some suggestions

Notriatv, 2023-12-23:
Hello friend Milos. I'm already using your GUI to control my Arduino Leonardo board, and I'm really enjoying it. Thank you for your work.

But I would like to know if the following settings are possible?: a simple AB encoder without a Z index (just rx tx ports) (which is my current use, and I don't see any issues using the GUI to manually center the steering wheel). Then, the analog pins would be used for the accelerator, clutch, handbrake and H-shifter XY on A3, A4, and A5 as I saw in your diagram.(or can we, maybe, use A3 for an optional extra axis for some randon use (like a second potentiometer brake pedal) if it´s not really necessary for reverse gear) Additionally, a load cell on pins 4-5 for the brake pedal and 9-10 for the BTS driver.

If I'm correct, there would be 8 free pins left, which could be used in a matrix 4x4 (16 buttons?) or 3x3(9 buttons?) and 2 additional inputs for the paddleshift (this would prevent false inputs if shifting gears and pressing another button at the same time.

summarizing it would be:
1 encoder steering axis
5 axis  for accel, brake (with LC), clutch, handbrake and a optional potentiomenter extra axis (if possible)
16 buttons via matrix scheme or 9 butons plus 2 separeted inputs from this matrix
1 bts driver (pwm +- mode)

I find something like that in your  "v192azf" firmware where we have xy shifter option and load cell at the same firmware, but I was having some trouble with autocalib pedals.. manual calibration works fine to me :)
so..what's do you think? is that possible mission? I follow your step by step and I'm able to compile to arduino board via IDE but I haven't knowledge yet to edit the code :(

I'm currently using v222zh.hex firmware, things are good but I have no inputs working I don't know why but they (buttons 0 to 11) starts to blinking when I turn my ffb power supply on
again thank you so much for your work

ranenbg, 2023-12-23:
Hi, tnx for support, it means alot to me.

What you are describing should be the firmware version v222ht but without a shift register (button box). This should be doable, I'll check, there ahould be enough memory for such a combo.

In HEX v222zh, the buttons are blinking because the firmware expects a button box input. This is arduino nano with my button box firmware. If you don't connect one and leave the pin6 unconnected it's normal. It's allways good practice to gnd all unused pins.

ranenbg, 2023-12-23:
Ok, I've just checked and I have bad new.

Unfortunately, HEX which has load cell can't use XY shifter at the same time due to memory limit:
Sketch uses 29294 bytes (102%) of program storage space. Maximum is 28672 bytes.

Also, when using 4x4 button matrix, it's not possible to use at the same time XY shifter or shift register. So that is why I have not already included such a HEX combo in the release :(

Notriatv, 2023-12-26:
@ranenbg Hii, thank you for the explanation!! I see, indeed, the memory of atmega32u4 is limited, but I really like using it, and I don't see the need to use an STM instead. With your software controlling the board, I will probably stick with this platform for a good while. However, I'd still like to know if it is possible to create something like a firmware "v222f" for a pedal with a load cell and an analog H-shifter, and the unused ports could be some simple inputs as in  "v192azf"? what do you think? Also, I'm already using a second Pro Micro with Simhub to control some LEDs, motors, axis and matrix buttons..the things are fine running together, thanks !!

ranenbg, 2023-12-26:
I have to check if load cell and XY shifter can work at the same time.

Notriatv, 2023-12-26:
I see.. that's ok , you provided us enough options for vary setups, and it gave a whole new driving experience, especially in Assetto Corsa. The 'min pwm' option really helped eliminate the dead zone in the force feedback near the center and made the steering wheel much quicker to correct the car on the track! Thank you for that, and thanks for your attention. I'll try to buy you at least a coffee or a beer for this. TNX!!

Closed 2023-12-31.

Thread 39 (2023-12-28):

Load Cell

EliDev05, 2023-12-28:
Hi, I'm upgrading my setup with load cell on brake pedal.
I have a 10kg load cell and HX711 module connected to Arduino Leonardo according to this schematic:

Red E+
Black E-
Green A+
White A-
GND to general GND of Arduino
VCC to 5V of Arduino
DT D4
SCK D5

I have installed fw-222ah, and the first time i ran it, the wheel control application correctly read output from the load cell, then i unplugged and re-plugged the Arduino and the load cell stopped working... now the Y Axis is blocked on -1.0 value.

I really don't know how to fix this, I'm worried that my load cell or HX711 fried up.
Thanks in advance if somebody can help me.

ranenbg, 2023-12-29:
With the information you provided it's hard to say where the problem is. You wired it correctly and the fact that it was working well the first time you run wheel control confirms it.

There is low chance that HX711 or load cell died just like that. It's probably some lose connection, some wire not holding properly, check that DT and CLK wires are connected firmly in pins 4 and 5. Even without load cell connected, when touching HX711 pins by finger you should see some noise readings. Make sure that you do not reverse A+, A- wires of load cell, as negative values are not displayed in Y axis, only positive. When it shows a -1 reading on Y axis, this is usualy sign that there is communication with HX711, or that it's interrupted.

In wheel control, there is a slider to adjust brake pressure, by default it's at 45 (out of 255). Try changing it a little back and forth. Each time you change it, a tare of load cell (zeroing) is performed. The most sensitive (1:1 reading) is with value of 4.

Hope this helps. Good luck.

EliDev05, 2023-12-29:
I think that there are some software issues, or maybe the HX711 module goes on some stand-by mode...
First i have switched the HX711 module on 80hz mode and i have discovered something new:
my pedals set are connected with rj45 cable to a custom arduino shield, so i can connect and disconnect all the pedals with just one cable...
when i connect the pedals cable, for one second i can see the brake axis (the yellow one) at some values and if i give some pressure to the brake pedal the value increase, then the value drops to 0 and the Arduino can't read any value from the brake pedal.
Without powering off the Arduino, if i disconnect and reconnect the pedals cable the same thing happens.

I have attached a video where you can see this strange behavior:
https://github.com/ranenbg/Arduino-FFB-wheel/assets/59321870/5ef2ec64-843a-497d-aaab-e1222900b1ad

Thanks for the help.

ranenbg, 2023-12-29:
Yeah, this seems very wierd. Not sure what you can do here other than playing with max brake pressure slider. You had it at 45 or 40, this is quite high value for such a tiny 10kg  load cell. I have a 75kg one and I use 45 for it as this feels best for me. You can try something lower, for example 32 or less.

EliDev05, 2023-12-29:
Thanks i will give a try with a lower max brake pressure and with the last version of wheel control... If all of these solution won't work i will buy a new load cell with higher kg like yours, maybe 10kg is to low.
By the way the ground is the common for the shield and all devices and component so i don't think that can cause this problem.

I will keep you updated, thanks a lot for the help.

EliDev05, 2023-12-29:
I have tried to lower the max brake pressure value, update to the last version but nothing helped.
I'm not sure but maybe there are some interference/false contact in the rj45 connector...
I will buy a "larger" load cell and a different HX711 module.

ranenbg, 2024-05-06:
I'm closing this issue as it was related to some hardware issue of the user and it's not a firmware-related problem.

Closed 2024-05-06.

Thread 40 (2023-12-30):

no ffb efect

madhack2142, 2023-12-30:
just finished assembling and cant get it work, already tried few bts7960, no effect
tried different firmware, changed pwm frequency, fast top/phase corr
i use arduino leonardo 32u4

madhack2142, 2023-12-31:
okay i reflashed again the lastest firmware and it started to work

Closed 2023-12-31.

Thread 41 (2024-01-01):

MIcro and XY shifter

jwinfieldnz, 2024-01-01:
I don't see any specific wiring for the micro and XY shift (f) firmware. So I have connected it up to A2 and A3 and this seems to translate well to RX and RY but the XY Shifter only sees movement in a diagonal direction when moving RY. If you see the diagram below RY moves but there is no movement in the RX shifter at all.

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

Just wondering if it is fully implemented in MIcro or not. I think I have tried all F firmware.

ranenbg, 2024-01-01:
I didn't put any specific wiring for XY shifter for micro HEX, because it is the same as for leonardo HEX. You have to use pins A4, A5 (x, y) for analog shifter.

What you observe is not an issue at all. You left A4, A5 unconnected (floating), while you connected pedal axis pins A2, A3. Which ever voltage was on pin A3 was reflected with quite some noise to floating pins A4, A5 in the same way. That is why you saw a diagonal movement, as both pins received the same input.

Wire it correctly and it'll work just fine.

jwinfieldnz, 2024-01-01:
Ahh TIL there is a Micro and Pro Micro. Strangely the pro micro (the one I am using) skips A4 and A5! Thanks for your reply

ranenbg, 2024-01-01:
You're welcome.

You are right, it's somewhat missleading. HEX for leonardo and micro is the same, as both boards have the same pins. Only proMicro board has a different format and I'm using special HEX for it with replacement pins, but I named it micro HEX. It is a bit confusing, I admit, however, I explained that clearly in the first paragraph of readme.

jwinfieldnz, 2024-03-11:
This is the first image on the readme, it doesn't seem to mention the alternative pins for the XY shifter and micro. I have figured that out. What would be the reverse button input?

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

Would it be A0 or A1?

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

jwinfieldnz, 2024-03-12:
Ahh pin 4.

ranenbg, 2024-03-12:
Hi, yes, as you can see in both pictures I wrote button0 is on pin 4, or pin A3.
The bottom picture shows a h-shifter wiring and there you can see in more details, which of these two pins is used for reversed gear, depending on HEX version that you use. If you use HEX with a load cell v222m, then one analog pin A3 gets free and I used it for button0. Otherwise, it's on pin 4, for HEX v220m, or v220.

ranenbg, 2024-03-13:
Ok, good, I'm closing the issue as there was none. Please pay more attention to the documentation I provided and we can avoid these kinds of questions.

Closed 2024-01-01.

Thread 42 (2024-01-07):

Compilation error 'Joystick' was not declared in this scope

SebLaser, 2024-01-07:
Thank you for your code which is very detailed.
I have so far succeeded in compiling the button box by adding an small XY joystick on the following bytes. Loading the code on the nano is done well. I will use it too move the mouse on the screen.
Now i plan to program the leonardo but i can't compile your code.
In USBDesc.h in the last lines i have the compilation error 'Joystick' was not declared in this scope.
I follow your "How to compile the source" explication, a lot of errors are gone but this one remains.
In HID.cpp the word Joystick is black, not orange:
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
Is there a librairy missing?
Thank's for your help.

SebLaser, 2024-01-07:
Sorry, i found the mistake.
In the IDE, under tools the nano board was selected from my previous project... I choose leonardo and now there is no error but a lot of warning with arduino 1.8.18:

```
D:\Partage\FFB\brWheel_my\brWheel_my.ino: In function 'void setup()':
D:\Partage\FFB\brWheel_my\brWheel_my.ino:151:29: warning: large integer implicitly truncated to unsigned type [-Woverflow]
   CONFIG_SERIAL.begin(115200);
                             ^
D:\Partage\FFB\brWheel_my\ffb.ino: At global scope:
D:\Partage\FFB\brWheel_my\ffb.ino:63:1: warning: invalid conversion from 'void (*)(uint8_t, uint16_t, uint16_t) {aka void (*)(unsigned char, unsigned int, unsigned int)}' to 'void (*)(uint8_t, uint16_t) {aka void (*)(unsigned char, unsigned int)}' [-fpermissive]
 };
 ^
D:\Partage\FFB\brWheel_my\ffb.ino: In function 'void FfbHandle_EffectOperation(USB_FFBReport_EffectOperation_Output_Data_t*)':
D:\Partage\FFB\brWheel_my\ffb.ino:483:23: warning: invalid conversion from 'uint8_t {aka unsigned char}' to 'const void*' [-fpermissive]
     LogBinaryLf(eid, 1);
                       ^
D:\Partage\FFB\brWheel_my\debug.ino:146:6: note: initializing argument 1 of 'void LogBinaryLf(const void*, uint16_t)'
 void LogBinaryLf(const void *data, uint16_t len)
      ^
D:\Partage\FFB\brWheel_my\ffb.ino:505:23: warning: invalid conversion from 'uint8_t {aka unsigned char}' to 'const void*' [-fpermissive]
     LogBinaryLf(eid, 1);
                       ^
D:\Partage\FFB\brWheel_my\debug.ino:146:6: note: initializing argument 1 of 'void LogBinaryLf(const void*, uint16_t)'
 void LogBinaryLf(const void *data, uint16_t len)
      ^
```

And more if i use arduino 1.8.19
I will  try to download tomorrow.

I would like to take this opportunity to ask you if you have already made a potentiometer version for the steering wheel because in my arcade cabinet there is no encoder.

ranenbg, 2024-01-08:
Hi, you can just ignore all those warnings, this part of the code is used for debugging of DirectInput protocol for FFB. In normal operation it is not enabled, so it doesn't matter. Congrats on successfully compiling the code and making the change in button box code.

I didn't make a version where the X-axis is controlled by a pot, as this is not desirable due to lots of noise on input that will be reflected in the FFB signal. However, now that you have the code to compile, it's very easy to make such a change. Just before a function that sends USB data is called, you can remap one of the pedal axes into an X-axis. You would of course not be able to use that pedal axis anymore, so you could use for example handbrake axis for this purpose.

ranenbg, 2024-02-09:
I just did some testing and it turnes out you can may any other axis other than X-axis as a steering input and wait for it - the FFB will still work :)

SebLaser, 2024-02-20:
Hi, sorry for the lack of response. I have made good progress on the subject. Adding an AnalogRead worked well as well as with desktop effects. The FFB is better than with my previous solution (ArduinoJoystickWithFFBLibrary), in certain games it works whereas before nothing happened.
But I realize that there is noise which results in jerks in the steering wheel, so I am going to install an encoder.

I managed to send the information from my little joystick via the following two bytes to the Leonardo.

I also managed to give a different name to the arduino in windows by modifying the files in your directory, so it is indeed possible contrary to certain comments.

I want to add the possibility of having a spring effect on top of the game effects. (Some games only send vibrations so the steering wheel does not return to center.)
I haven't found what deactivates the desktop effect when you launch a game. So I think I'll code a little extra function.

I'm progressing little by little, but the result is pretty good thanks to you. When it is fully functional I will just have to make a copy and paste because it is a twin cab!
Thanks again.

ranenbg, 2024-02-20:
Hi, congrats again on your progress. About analog X-axis for ffb - it is noisy, I told you so :) but it's good that you tried it and saw for yourself that encoder on ffb axis is a must afterall. At least for an ffb wheel, I guess for gamepad one could get away with just rumble motors.

This other ffb library for arduino you mentioned probably has just constant force effect implemented, so that's why it didn't work with a game that only sends periodic effects. In that sense my firmware is the most complete compared to other ffb implementations for arduino.

Yes, ofc, one can just change board name and it will appear in windows like that under game devices.

Autocenter spring effect is handeled internaly by the directInput protocol itself. There is a special flag for it and this you can't change. What you can do however is to add a desktop centering spring effect, that will always stay on once you enable it. Have a look at how I implemented this for other desktop effects like damper, friction and innertia. To keep consistency with my firmware, in principle you just need to add "square button" next to the spring gain slider, this will send an effects configuration byte to the firmware. Then in ffb.ino add one more if statement which checks this bit and adds one more spring effect on top of ffb signal. Anyway, I should also do this sometime if I find enough motivation, it's a good suggestion, tnx.

Thread 43 (2024-02-01):

How to get 32 buttons to work?

johanneslerch, 2024-02-01:
Hi there, first of all, thank you for sharing this awesome project.

I'm trying to get 32 buttons to work (I'm using four 8-bit shift registers chained together). By using DEBUG_SERIAL I was able to confirm that I can read all 32 buttons values, but it seems only 24 buttons receive push events in windows.
I'm looking at the USB game controllers window, which successfully lists 32 buttons in theory, but the first 8 will never be pushed while I can successfully use the latter 24.

Here is a screenshot of what I'm looking at (note that all buttons have pull-up resistors and I didn't negate any values yet, which causes them all to appear pushed while they are actually not):
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

My code changes can be found here: https://github.com/johanneslerch/Arduino-FFB-wheel/commit/8112df4e093598882267c2dc1da1f56ec0bb7158

I assume I'm missing some change in the USB device setup. Any hints would be appreciated!

ranenbg, 2024-02-01:
Hi, tnx. Congrats on what you did so far, very nice work. It's important to understand there are a few ways to do this.

Have a look at hid.cpp this is the usb device setup part that you are probably missing, as I didn't see you made any changes there. There is a part in hid descriptor which defines a hat switch and buttons come after it. There are 8 bits reserved for hat switch that come first, while last remaining bits are for buttons.

Input bytes function "ver 5" that you use at the moment probably has to be changed as well.

johanneslerch, 2024-02-02:
> Have a look at hid.cpp this is the usb device setup part that you are probably missing, as I didn't see you made any changes there. There is a part in hid descriptor - input report definitions, which at the end defines a hat switch and buttons after it. There are 8 bits reserved for hat switch that come first, while last remaining bits are for buttons. This structure must be respected.

Do you refer to this section in hid.cpp ? That's at least the only one that I can spot mentioning a HAT SWITCH and Buttons. Note that I did not change hid.cpp directly, but indirectly as I changed the `#define NB_BUTTONS 24` to 32 in USBDesc.h.
```
  0x09, 0x39,                     // USAGE (HAT SWITCH)
  0x15, 0x01,                     // LOGICAL_MINIMUM (1)
  0x25, 0x08,                     // LOGICAL_MAXIMUM (8)
  0x35, 0x00,                     // PHYSICAL_MINIMUM (0)
  0x46, 0x3B, 0x01,               // PHYSICAL_MAXIMUM (315)
  0x65, 0x14,                     // UNIT (Eng Rot:Angular Pos)
  0x55, 0x00,                     // UNIT_EXPONENT (0)
  0x75, 0x04,                     // REPORT_SIZE (4)
  0x95, 0x01,                     // REPORT_COUNT (1)
  0x81, 0x02,                     // Input (Data,Var,Abs)

  0x05, 0x09,                     // USAGE_PAGE (Button)
  0x15, 0x00,                     // LOGICAL_MINIMUM (0)
  0x25, 0x01,                     // LOGICAL_MAXIMUM (1)
  0x55, 0x00,                     // UNIT_EXPONENT (0)
  0x65, 0x00,                     // UNIT (None)
  0x19, 0x01,					            // USAGE_MINIMUM (button 1)
  0x29, NB_BUTTONS,               // USAGE_MAXIMUM (button NB_BUTTONS)
  0x75, 0x01,                     // REPORT_SIZE (1)
  0x95, NB_BUTTONS,			          // REPORT_COUNT (NB_BUTTONS)
  0x81, 0x02,                     // Input (Data,Var,Abs)
```
I believe this change resulted in USB GameController dialog showing 32 buttons instead of 24. Is there something else that I need to take care of?

> Input bytes function "ver 5" that you use at the moment probably has to be changed as well if you want to keep the hat switch.

I didn't plan to use any hat switch. Best to my understanding, the hat switch is sent as part of the "buttons" variable, right?
I've dropped the left shift to avoid messing with my 32 values in the buttons variable: https://github.com/johanneslerch/Arduino-FFB-wheel/blob/8112df4e093598882267c2dc1da1f56ec0bb7158/brWheel_my/Inputs.ino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
How would I disable the HAT SWITCH completely?

>Do not forget to copy changed hid.cpp file as well as all other usb core files you changed in correct folder, otherwise it'll use the old ones even after making changes to them in arduino ide.

Phew, this I completely missed. Wondering why it seems some changes did have an effect. I will double check this one.

ranenbg, 2024-02-02:
Yes, this is part of hid decriptor I wanted you to have a look at. Yeah, I also saw this wierd N+1 button showing up. It seems that the number is correct only when one uses 16, 32 or 64. Anything in between gets the wierd +1, but this is only a small cosmetic issue.

To completely remove hat switch you can just comment out its usage page and everything below it,
just up to the buttons usage page, but I do not recommend it. You may get stuck in damaged hid descriptor and the device will not even show up, it's extremely hard to debug this, you must know exactly what you are doing. Yes, out of 32bits sent there are some reserved for hat switch, that come first.

Instead, I would rewrite the input report function to have 8+32 buttons, something like 16,16,12,12,12,8,32. But I leave it up to you to decide. If you remove hat switch then you can utilize all 32bits for 32 buttons, using the ver 5 function.

johanneslerch, 2024-02-02:
Got it working now. Of course I was missing something obvious...
I did not uncommend the declaration section for axis rz, but started using ver5 which wants to send rz. That means, I ended up sending rz, but it was interpreted according to the declaration, which means my empty value for rz was interpreted as value for the first buttons.

My current state is here: https://github.com/johanneslerch/Arduino-FFB-wheel/commit/aa2016fdbf74139757848daa13cfe0c217a8b9e1

In a next step, I want to clean that up and create a ver6 as you suggested using two 32bit variables allowing to push 4 bits for the hat switch + 60 buttons. That should be enough, even for me ;-)

Thank you so much for the support.

I believe, it may be time to share a little about my other plans (as I may run into more questions in the future).
I'm planning on
* 32 push buttons,
* a rotary encoder on pins D4 and D5, which I will transform into two buttons that will be virtually pushed depending on the direction of rotation
* a 3-axis joystick with an integrated push button on A3, A4, A5 and D12.
* a possible further extension of buttons (if I ever get to add buttons directly to the wheel) via a Nano in the wheel and UART communication via D2 and D3

If from these, you already see me running into a problem, let me know. Though, the custom PCB is produced and now successfully tested to be working already, so I'm kind of committed to make it happen ;-)

ranenbg, 2024-02-04:
I see, tnx for all this info, nice :)

I never tried or even thought to stack arduino nano (software shift register) with an actual hardware shift register IC, that is why I say it can't work at the same time. But maybe it can work without any additional code modification, you tell me. In principle nano is simulating the operation of shift register, so as long as everything is in sync concerning the PL (pull) signal logic, it should be fine in theory.

johanneslerch, 2024-02-08:
Ah, there is a misunderstanding. I did plan to add the nano to different pins than the shift registers.

ranenbg, 2024-02-08:
Oh, I see. Yeah, that may work I guess.

Originaly in BR wheel code there were two pins planned for such purpose, one for h-shifter and another for wheel rim, but it was never implemented. I ditched it and just exanded/restructured a single shift register readout with arbitrary bits number.

MrCjxer, 2024-07-19:
Hi @johanneslerch
did you make it success ?

johanneslerch, 2024-07-19:
> Hi @johanneslerch did you make it success ?

Hey, the answer depends on what you are refering to.
The part with the nano for additional buttons within the wheel rim is something I didn't even start yet.

All the parts shown in the CAD picture above are realized and fully functional.

johanneslerch, 2024-07-19:
Found your issue and therefore, assume it's about how to get the 32 buttons to work using shift registers. I will continue to describe in this issue to have all details of my solution in here.

I've been using SN74HC165N shift registers. I strongly recommend reading about how shift registers work. You will need to understand what CLOCK, LOAD, and SERIAL pins mean, because these you will need to your Arduino Leonardo or whatever board you are using.

I'm attaching you some schematic of the wiring that I did:
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

Then I did some changes to the code that you can find on my fork https://github.com/johanneslerch/Arduino-FFB-wheel/commits/master/.
The respective commit is this one, though, I'm not entirely sure anymore if a later one fixed something or it worked in that state already: https://github.com/johanneslerch/Arduino-FFB-wheel/commit/aa2016fdbf74139757848daa13cfe0c217a8b9e1

ranenbg, 2024-07-19:
Tnx very much for this info, it's a super useful resource :)

MrCjxer, 2024-07-20:
> Hey, the answer depends on what you are refering to. The part with the nano for additional buttons within the wheel rim is something I didn't even start yet.
>
> All the parts shown in the CAD picture above are realized and fully functional.

hi again
Exactly what you said 👍 :)
I need more buttons like you

=====================
woooow . soooo nice and thank you
very useful

>
> Later commits extend the HID to support up to 64 buttons as I ended up with 32 buttons via shift register + some more directly connected to the Leonardo board.

1- but you mean its support 32 Button for now? and maybe someday you will edit it and extend the HID to support up to 64 buttons?

> some more directly connected to the Leonardo board

2 - how many buttons directly connected to the Leonardo board?
because i have the same board (Leonardo)

> Then I did some changes to the code that you can find on my fork https://github.com/johanneslerch/Arduino-FFB-wheel/commits/master/

3 - for this changes that you did, need any change on FFB-gui?
https://github.com/ranenbg/Arduino-FFB-gui

> I'm attaching you some schematic of the wiring that I did

4 - on the schematic, what is " WHEEL-COMM " and " TEMPOMAT_ENCODER "?

sooooo sorry for many questions, I'm noob :)

Closed 2024-02-02.

Thread 44 (2024-02-07):

ffb max output force?

Notriatv, 2024-02-07:
Hello! I wonder if there is a possibility of adding this feature? Because in some cases FFB is too strong, and the power supply ends up shutting off.(mostly on beamng or iracing colisions) I know that if I reduce the overall gain, I can solve this, but I don't want to lose the minimum forces.. what do you think?
Thanks in advance :)

ranenbg, 2024-02-07:
Hi, this is not a real issue of the firmware. You can't have both at the same time, there is allways some tradeoff. What you can do is use lower voltage for your motor when powering BTS7960, if you have a psu that has voltage output adjustment.

With firmware you can play with general gain and min pwm sliders. You can also try out different PWM frequencies. Remeber that lower PWM freq will give you more ffb resolution as PWM signal will have more steps inside one period.

Notriatv, 2024-02-08:
I see, for sure that's not an issue but I don't know another way to contact developers here on github lol
I was just thinking about that because I saw this feature or something like that on EMC and AFFBWheelGUI (not tested here yet) in "cut force" description but I'm completely noob and don't know how you guys do the magic :)
ok I'll keep playing with sliders to find perfect sets for every game..
I'm using a 200w dc spindle for CNC with 1:10 belt reduction and a 24v 500w(not real) psu
I once tried running it with a 24v battery and ffb was great without turning off due to "ffb peaks"
I'm currently running with 8khz for racing games since the engine sounds are louder than pwm noise and 16khz for ets2

Notriatv, 2024-02-08:
oh yess another quick question.. is it possible to use some BL motors with your firmware? like those we find on hoverboards

ranenbg, 2024-02-08:
Just as I thought, 24V 500W motor is scary :)
EMC and AFFB have 8bit ffb with only a few effects, while mine is 16bit will full ffb effect support which takes a lot of memory, so that is why they were able to fit ffb filtering on it. I was once a complete noob with arduino programing and ffb, but I'm working on this since around 2017 and had a strong motivation to learn more. I only used sources available online.

In the game you can always set ffb strenght in such a way that clipping does this job of cutting high peaks for you. If you set it on a higher side, such that there is no clipping under normal conditions, so ffb signal is most of the time close to 100%. When a sharp peak comes, it will be just clipped out as game can't send more than 100% ffb. You can use my realtime FFB monitor in GUI just click on a square button next to a general gain slider and run the game in window mode such that FFB graph is just behind and below game window.

Howerboard motors, yes, for that reason I made a special pwm mode I called RCM. This is the same as the one used in RC cars for servo motors that you put on the front wheel for steering. Howerboard electronics can work with such pwm input signal. There were a few guys asking around about this and I made it upon their request. I'm not sure of they got it to work, they said there were problems with it concerning calibration of pwm input on the howerboard electronics side, there is some knock-off firmware for this board somewhere.

Notriatv, 2024-02-08:
oh I see.. big thx for sharing your knowlege with rest of us 👍
 for sure one day I'll try bldc just to satisfy my curiosity :) and learn to use that cliping window
if you want to see something of my project that's my yt channel https://youtube.com/@NotriaTV?si=KOfzXNBMi3usPVOP
thx again!!

Closed 2024-02-11.

Thread 45 (2024-02-17):

Reversed motor polarity

duce1nik, 2024-02-17:
I am having issue with x axis just spin in the direction after I turn the wheel and it don’t stop.
For example, the steering wheel is center.  If I turn it to the right the steering wheel would just spin in right direction and do not stop.  I would center it again and turn left and it would turn in left direction and without stopping.  I am would expect it to turn back to center at 0 degree if I turn it in either direction.  Please help.

ranenbg, 2024-02-17:
Hi, your motor is connected in reverse. Just swap wire polarity on it and it will be fine.

duce1nik, 2024-02-18:
That fixed.  Thank you @ranenbg

ranenbg, 2024-02-18:
You're welcome, take care.

Closed 2024-02-18.

Thread 47 (2024-02-21):

Invert X or Y manual shifter

jwinfieldnz, 2024-02-21:
I had a quick look through the code but I couldn't find a flag to invert an axis using the `f` firmware. I am using a PS3 analogue stick and I can't really swap the polarity as it's mounted to a PCB. The issue is that left and right are ok but pushing forward and back are inverted. I guess it doesn't really matter in a game but it would good to see the right behaviour in the wheel_control tool.

ranenbg, 2024-02-21:
Hi, there is no such flag, I didn't implement it in firmware. All axis reversal and ffb reversal stuff I deliberately left out as they can be done by hardware with correct wiring. First reason is that this uses extra memory space, I was trying to save and second is that it will create a mess in diagnosing what is reversed and where.

However, the suggestion is resonable and I may have to revisit it at some point, but I'm not a fan of this idea, as I made decision not to do it from the very early days of firmware developement. The firmware is ment for DIY community, where one has the skills and freedom to do his own wiring.

In your case, there are two options: cut some traces on the pcb, or just put one extra line of code after analogRead to reverse the readout like: value = 1023 - value;

jwinfieldnz, 2024-02-21:
So something like `shifterX = 1023 - shifterX;`? It would be great to have a release with this feature, particularly if you can set the axis to invert in the wheel_control tool. Agreed, most will use individual pots and not face the issue at all. These HW-504 however are cheap and hardy and are ideal for this application other than this one small issue.

ranenbg, 2024-02-21:
Yes, just like that, but place it right after shifterX=analogRead().

I'm sure that you realize how much work it is to make a new release of both firmware (20+ HEX files) and wheel control, just to add one tiny feature that almost no one would use. One line of code change in firmware is not worth a new release. I have however a few things on a to do list already and thinking how to implement all of them without braking backwards compatibility is not trivial at all. This is all given that there is enough memory left in arduino.

Even with reversed Y axis, the H-shifter will be perfectly functional. Only the reversed gear will be in 2nd instead of 6th or 8th, which is not that big of a deal.

jwinfieldnz, 2024-02-22:
Ok no worries. I will try and find a workaround on the HW-504.

ranenbg, 2024-05-06:
Since I have released a firmware version that supports advanced shifter config, including the inverting both X and Y shifter axis, I'll close this issue.

Closed 2024-05-06.

Thread 48 (2024-02-28):

Firmware for STM32F103C8T6 (STM32 Blue Pill)

chizhkovanton, 2024-02-28:
Hello! I would like to know if there will be firmware for the STM32F103C8T6 (STM32 Blue Pill) board? Do we need to change the for memory? Or what will be the pinout for this board with Arduino firmware?

ranenbg, 2024-02-28:
Hi, I have no plans of porting the firmware to any other chip than AtMega32U4. That would require writting everything up from scratch pretty much. You can't just use a different MCU like that and especialy not STM32 that has a totaly different architecture.

I mean, you can try and see what happens, but I'm sure there will be a ton of unfiable compiler errors, that it makes not much sense to port it.

chizhkovanton, 2024-03-06:
Okay, anyway, thank you so much for your hard work. But there is a question: what if the Wheel Config writes the firmware version as 0.0?

ranenbg, 2024-03-07:
Tnx, you're welcome.

Wheel Config is a part of AI wave firmware and it is not compatible with my firmware at all. It is true that my firmware is based on some very early version of it, so as ESP Wheel, so as BR wheel, but that's where all similarities end. My firmware is a huge step up from those in almost every aspect, concerning FFB quality and other features.

If you want to do any configuration of my firmware, you have to use the wheel control GUI that I made, it is in my other repository on Github. Alternately, you don't even have to use my GUI, I have provided full documentation in RS232_commands.txt so you can use any program capable of serial communication to configure it. My firmware is also presented as a virtual serial port to any windows PC, so it's easy to work with it and configure it once you know which command to send.

Closed 2024-09-09.

Thread 49 (2024-03-21):

Wiring help (optical encoder)

guilhermevleite, 2024-03-21:
Hi, I am sorry to create an issue just for this, but I can't figure this out.
So, I got an optical encoder that needs between 5V and 25V to power up, and the arduino cannot feed this much. My solution was to get an external power supply and a tension regulator to bring the power from 110V -> 15V -> 5V, and then power the encoder.
That being said, I still cannot get the wheel_control to register the encoder signals. I know the encoder is working because I tested it with a simple sketch.
What am I doing wrong? In the image is my wiring setup, A0-A3 are shorted to GND.
Is there a discord server I can also try to get help?
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

ranenbg, 2024-03-21:
Hi, the wiring diagram you presented is correct, this should work.

Which firmware version did you upload to your proMicro? It could be that you uploaded hex ending with 3, like v223. That will not work without an i2C dac connected, so make sure you have correct HEX, like v220 for beginning.

If that doesn't help, you could try with a higher voltage, for example just put a different voltage regulator like LM7812 or LM7815. If you do it, be very careful not to keep pullup resistors still connected to this voltage as you will burn arduino. Instead, connect them to arduino 5V pin, such that they pull encoder signal lines HIGH to 5V. Value of 4.5k seems a bit odd, you can go down to about 1k, but I recommend to use 3.3k and only go lower if you see encoder step skipping (drift of wheel center over time).

I have no specific discord server for my firmware, I preffer to keep the communication via github only.

guilhermevleite, 2024-03-21:
Hi, thanks for the quick answer.
I have tried a few of the hexes, right now I am using brWheel_my.ino.micro_v220cm.hex
You are correct, 4.5k is weird, I am using 4.7k, do you think I should go lower?
I will try another regulator and move the pull-up resistors to VCC, as soon as I buy the proper regulator.
Thank you again!

ranenbg, 2024-03-21:
You're welcome.

In principle, you don't need lower pullups than 4.7k. This depends on PPR of your encoder. You should be fine with this values up to 2k PPR encoders.

ranenbg, 2024-03-22:
After a second look at your wiring diagram, I noticed that you didn't connect encoder GND to arduino GND pin. This is crucial and it's definately a reason why you had no signals from encoder. Once you make this connection I'm 99.9999% sure that it will work.

guilhermevleite, 2024-03-22:
> After a second look at your wiring diagram, I noticed that you didn't connect encoder (and psu) GND to arduino GND pin. This is absolutely crucial and it's definately a reason why you had no signals from encoder. Once you add this connection to your circuit I'm 99.9999% sure that it will work fine.

THAT WAS IT! It worked!
The odometry is a little off, when I turn counter-clock it looses the center point. But that may be some loose wire in my part, will test more.

Thank you again!

ranenbg, 2024-03-22:
Make sure to enter the correct CPR value for your system. If you have encoder mounted directly on wheel shaft then CPR=PPR×4. If you have it via pulley or gear system then you have to multiply with a gear/pulley ratio.

You may also want to try with a lower pullup values like 1k, to get more fast signal response (faster pullup to 5V).

Closed 2024-05-06.

Thread 51 (2024-05-03):

Kompilovana verzija ne radi

Azur12345, 2024-05-03:
Zdravo! Ja pravim volan sa ovime ali nemam enkoder. Imam samo ovaj potenciometar. A znam poprilicno o Arduino tako da sam htio samo malo da prepravim kod da radi sa ponteciometrom. Nego, prije nego sto sam poceo da modifikujem kod samo sam ga istestirao sa gasom i kocnicom. I dalo mi je dosta gresaka. Uradio sam sve kako je Readme rekao. Zamijenio sam arduino core, downgradevao boards manager I nista. Koristim Arduino Leonardo i stvarno sam zapeo. I kad sam probao hex verziju samo onako kad sam probao da udjem u Assetto corsu samo da vidim da li radi, samo se zacrnio ekran i crashovalo se. Sa ovime se vec satima zezam. Probao sve zivo. Includovao inputse i jos tona stvari ali apsolutno nista nije radilo. Za Assetto corsu probao sam da koristim Joystick library od MHeironimus-a i tad je Assetto corsa radila normalno.

ranenbg, 2024-05-04:
Hi, for the sake of others, I'll repply in english.

Briefly, this user is asking about how to compile the source code and reporting the issue with compiled HEX files, simply stating that it doesn't work in assetto corsa.

With the details you provided in this issue, there is not enough information for me to give you exact solution. You have to write in mode details (prefferably in english) all the steps you took so far and which kind of errors you get from arduino ide, which ide version do you use, from which arduino boards version you downgraded, which HEX versions did you try so far, which wheel control version did you use.

Usual mistake when it comes to HEX files is uploading a wrong version for the hardware you have connected to arduino, or arduino board itself. Fail safe versions are the ones ending with a 0, like v230, or v230x. They do not require anything to be connected to arduino and should work without any configuration straight away. If you have a proMicro use the HEX files with "m" option. I recently released new firmware and GUI, I strongly recommend to use them. In your case, with v230x you can use a pot for steering and working FFB effects on analog axis.

Azur12345, 2024-05-05:
Sorry for the late reply and for being quite vague. Okay so, the main problem is that I wanted to use the .ino version because I wanted to tinker with it and see how it worked. So now I redid the steps that were mentioned in the readme and now it won't get past the first line of code.
The error is;
:\Users\User\AppData\Local\Arduino15\packages\arduino\hardware\avr\1.8.5\cores\arduino/new.h:3:10: fatal error: new: No such file or directory
 #include "new"
          ^~~~~
And for the assetto corsa black screen/crash this is it:
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
I tried to do it with the simpler library(ArduinoJoystickWithFFBLibrary from YukMingLaw) and still it is giving me the same error on crash. When I tried using the standard Joystick library(from MHeironimus) it worked and launched the game without a problem. It's not a problem with assetto corsa I reinstalled it and verified files removed mods reinstalled csp everything and yet nothing worked. Maybe it is a problem with my windows. I looked directly into the .h and the .cpp files and they were exactly the same as in the other one. I was using the v230x hex version.

ranenbg, 2024-05-05:
To compile the source, I'm using arduino IDE version 1.8.19 and boards version 1.6.21, try with that. The error you had says you have no new.h header file, so probably something wrong with either boards or IDE version you used, can't say more than this.

About HEX v230x, once you upload it to Leonardo, did you try to open wheel control 2.6.0? Can you send a screen shot of it, if you can get passed the configuration?

Azur12345, 2024-05-05:
I miracoulsly managed to fix the issue with assetto corsa. Turns out my dinput and other hid dll system files on windows were corrupted. Replaced them and now it works flawlessly. I am using arduino 2.3.2 and boards 1.8.5. I will try to use the approapriate windows and board version. The computer does recognize the leonardo as the controller. I will get back to you with more details.

Azur12345, 2024-05-05:
Okay now I installed arduino 1.8.19 and 1.16.21 and now it is giving me this error code:
exec: "C:\\Users\\Azur\\AppData\\Local\\Arduino15\\packages\\arduino\\tools\\avr-gcc\\7.3.0-atmel3.6.1-arduino7/bin/avr-g++": file does not exist
Error compiling for board Arduino Leonardo.

ranenbg, 2024-05-06:
Ok, good, at least some progress with HEX.

It seems that you did not copy the usb core files correctly, or that IDE is using them from a wrong location. By now, you had installed many versions and I have no idea what is happening on your PC anymore, this is going to be a pain to diagnose. That IDE v2 may have still left some of its traces. I've never seen a compiler error that serial.begin() or other ones connected to serial com functions are not working.

Anyway, it took me about 6 months to get this to compile error free, when I was just starting with Fernando's BR wheel project back in 2017, so don't give up just yet.

Azur12345, 2024-05-06:
I somehow got it working now. No erorrs anymore! all of a sudden it started working. I changed nothing and it compiled.

Azur12345, 2024-05-06:
I reinstalled the same core hundred times and it somehow started working.  Thank you kind sir.

Azur12345, 2024-05-06:
if it all of a sudden breaks I will notify!

ranenbg, 2024-05-06:
Great, congrats and welcome to the club :)

Closed 2024-05-06.

Thread 52 (2024-05-15):

FFB Wheel

mustafabasboluk, 2024-05-15:
I have 1 BTS7960 driver
1 piece 1000 pulse encoder
1 Arduino Leonardo
I have 1 RS775 DC motor.
Which software should I use?
I have tried a few but FFB does not work.

ranenbg, 2024-05-15:
Hi, most probably you didn't connect something correctly. You have to check step by step each connection. Then troubleshoot, if encoder is working, if you have connected and powered bts, if bts is working, only then connect a motor. You can use a voltmeter to measure if bts gives any output.

For fail safe, use HEX firmware v230x from leonardo folder and you should use wheel control v2.6.0.

From the info you provided, you basicaly only said that you have those components, but didn't say anything how you connected them. At this point I can't help without knowing more details about your particulair wiring or component issue.

mustafabasboluk, 2024-05-15:
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

This is my connection.
There's resistance, I just didn't show it.
FFB doesn't work even though I installed 230x software.
When I give external power to the motor, the motor works, the motor is not broken.
When I connect it to the driver, it does not work, I could not understand my driver is faulty.
Is there a mistake in the connection?
I check it from wheelcheck with this connection and it does not work.

Translated with DeepL.com (free version)

ranenbg, 2024-05-15:
Ok, good, this is something we can work with.

Wiring is fine mostly, except for the encoder connection. This way you are shorting encoder outputs to 5V all the time, it will not give any movement and therefore, you will not see any FFB.

What you need to do is add pullup resistors instead of a red wire that shorts A, B to 5V. The resistors can be anything between 1k and 10k.

mustafabasboluk, 2024-05-15:
The resistors will be at 5v coming to A and B of the encoder, right?

ranenbg, 2024-05-15:
Yes, one end of each resistor go to 5V and other end go to A, B, Z. One pullup resistor for each encoder channel.

MrCjxer, 2024-07-14:
Hi , can i use this sensor ?
It has GND , VCC , RX , TX
need any Z phase or Z button or Z trick ?

Thank you

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

ranenbg, 2024-07-14:
This one I think you could use, it should be just like any other optical quadrature encoder with 2 channels, where RX and TX are channels A and B. You have to check if it can operate at 5V and if signal level at it's RX, TX outputs is also 5V. You should be able to check this with a  multimeter, but scope would be ideal. It looks like it has quite high PPR, so you can even mount it directly at the wheel shaft, it should provide enough resolution in steering axis. You will have to use trial and error to determine the correct CPR. I expect something around 3600 CPR.

For the z-index, it probably doesn't have any z channel, so you can just click center button after every arduino powerup, or connect tge button and use firmware with hardware recenter feature, this is HEX with "c" option.

MrCjxer, 2024-07-14:
hi again
yeah it work with another FW but with your FW i did not test yet , so i will test it
i think its a 2150 CPR.

i have another question for you
i want use ALL 24 button with D-PAD , should i use which FW ?

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

and which PINs on Arduino Leonardo should i use ?
Shift register ? or matrix buttons ? or something else ?
and which model of shift register ?

i'm sorry for my bad English bro 😅
thank you

ranenbg, 2024-07-14:
About encoder, it should work with my firmware, just do not forget to put 4.7k pullup resistors. Anything between 1k and 10k will do, but lower is better as it has a faster signal response and is less prone to step skipping.

For buttons, you can use max 16 with separate arduino nano to which you upload my button box firmware. Other 8 buttons are reserved for analog H-shifter. It is possible to use all buttons available, but that requires modifying the source code, it's a relatively easy task if you know exactly what you're doing.

Closed 2024-09-09.

Thread 53 (2024-06-12):

Deadzone in inputs?

RandomHuman97, 2024-06-12:
When I try to turn the wheel, there is a very noticeable dead zone (the encoder moves and pulses, but the wheel doesn't send it as an output), is there any way to disable/lessen it?

ranenbg, 2024-06-12:
Hi, you are probably refering to the FFB deadzone around wheel center when autocenter spring force is active.

The cause of this issue is in the firmware or arduino, but inthe way how a DC motor operates. It simply needs some minimal voltage/current to make it start spinning.

In my firmware I made a setting to compensate for this motor startup current. You will see a slider in wheel control GUI named "min pwm torque", which does exactly that. Its available range is from 0% to 20% and you will have to play with it to find a sweet spot. Start with about 5% and go higher from there. Whay you want is to minimize the ffb deadzone around center, but prevent any small oscilations, so it's a trade off. You can adjust it with 0.1% increments to really fine tune it, but be aware that this will also depend on pwm frequency and general gain slider value, so make sure you have set those two first.

RandomHuman97, 2024-06-12:
Nevermind, I was talking about the rotary encoder deadzone, but turns out it was a software issue.

ranenbg, 2024-06-12:
There is no software or firmware issue with the encoder. You probably had a hardware issue with incorrect wiring. Make sure to use pullup resistors and to connect them correctly. I've provided a wiring diagram.

Next time if you post an issue, please put some more effort to precissely describe the problem, as we can get to the solution much faster and help others solve their similair problems.

Closed 2024-06-12.

Thread 54 (2024-06-16):

pmw + dip problem

Envi4, 2024-06-16:
Hi, before that, there was an affb firmware. I decided to switch to your new one, but I have a problem with PWM + dim. I only have single-way recoil, but everything works fine with PWM, just like it does on the affb. Everything works well with PWM + DIP.

ranenbg, 2024-06-16:
Hi, I'm not sure which problem exactly are you trying to describe. You are talking about pwm+dir mode. Double check if you are taking the direction signal from a correct pin on arduino, as it differs for the 3 supported arduino boards.

Envi4, 2024-06-16:
PWM+DIR Yes, I'm referring to this mode, but I couldn't get the circuit to work for me. Maybe I connected it incorrectly.

ranenbg, 2024-06-16:
Yes, that's the first thing you have to check. If you have a multimeter it's very eqsy to mesure dir signals, it's either 0V or 5V, it ahould alternate these two values when ffb changes direction.

Envi4, 2024-06-16:
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

I have correctly connected everything to the bts7960 itself?

ranenbg, 2024-06-16:
You are using wrong mode, as bts7960 is a H-bridge type of motor driver that needs 2 channel pwm+- mode. You can set 8kHz, it should be fine. Pins 9 and 10 are the pwm outputs, also make sure to connect 5V (vcc) to pwm enable pins.

Envi4, 2024-06-16:
Thank you very much, but what kind of board is generally used for pwm + dir

ranenbg, 2024-06-16:
There are some H-bridge DC motor drivers that use pwm+dir as input, but they are rare. Most of the time, this kind of input is used on 3 phase AC servo motor drivers, or on some 3 phase BLDC drivers. Howerboard motor driver is another example as well.

Closed 2024-06-16.

Thread 55 (2024-06-18):

Support for Arduino UNO R3

Beocamik, 2024-06-18:
I tried uploading Leonardo firmware with Xloader on my Arduino UNO R3 and it don't seen to work. Does Arduino Uno and Leonardo have difference on firmware?

ranenbg, 2024-06-18:
Hi, you can not upload my firmware on Arduino Uno, it has a completely different microcontroller, that lack's hardware USB HID. It is the essence or magic that makes it work like a joystick in windows.

I pointed out which Arduino boards are supported at the beginning of the github readme. It's leonardo, micro and promicro.

Beocamik, 2024-06-18:
Okay, thank you very much.

Closed 2024-06-18.

Thread 56 (2024-07-04):

Problem with the pedals

MatteoDav2607, 2024-07-04:
I only have 2 pedals and the remaining 2 free axles flicker continuously. How can I disable them?

ranenbg, 2024-07-04:
Hi, you can not disable the unused axis, but you can still prevent flickering. This is noise on the floating unconnected inputs and it's normal.

You should connect all unused arduino analog inputs to gnd (0V). Then use manual calibration for pedals in GUI. You just need to raise the lower callibration limit of each unused axis until it is just slightly above the zero level, if it's not already at 0 and staying there.

MatteoDav2607, 2024-07-04:
I did this and solved the problem with the unused axes, but the 2 that are needed continue to flicker. what could I do?

ranenbg, 2024-07-05:
This is quite tricky to solve comoletely, as there are several sources of noise in analog inputs:

[1] Analog to digital (ADC) conversion noise in arduino, that depends on the ADC settings. I'm using default settings, so +-1 step out of 1023, is normal noise.

[2] Unshielded cables or dirty pots. It is recommended to use shielded cables for all pots. You can use an usb cable wire, it has an outer shield plus 4 more wires inside, so you can use one such cable for up to 3 pots, where shield is gnd. For dirty pots I just spray WD40 which helps to get all the dirt out and sligthly lubricate it. This source of noise can be up to about +-10steps out of 1023.

[3] Electromagnetic interferrence - if you have unshielded wires that cary high amps with a pulsing or AC voltage close to your sensitive analog signal wires, this can create a lot of noise +-50 steps or more. Good practices are to twist motor wires, and move away any wires with 220V 50Hz AC. Shielding and earthing all sensitive analog parts, including enclosing arduino in a metal box.

Closed 2024-07-11.

Thread 57 (2024-07-14):

Use 24 Buttons with D-PAD

MrCjxer, 2024-07-14:
Hi again
i don't want use another Arduino nano for max 16 buttons
and i can't edit the source code, CUZ i'm noob :)

" If you decide to go the hard way, it is possible to stack 3 8bit shift register chips (parralel in serial out) and utilize 24 buttons including a D-pad "
if i want to do that, what should i do ?

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

can i use this shift register module ?!

1 - i want 8 button for H Shifter ( not a analog H-shifter ) CUZ i designed my H shifter and i can't change it )
2 - i want 2 button for sequential shifter on back of wheel
3 - i want 11 or 12 button on wheel ( like logitech or ... )
4 - if it possible have a D-PAD in addition to the 3 things I mentioned above

at the end 21 button (8 for H shifter - 2 for sequential shifter - 11 for on wheel ) + 4 D-PAD

the guy you did mention :
https://github.com/johanneslerch/Arduino-FFB-wheel

but i didn't understand what he did

edit 1 :
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

can you explain me what means this these three items ? DT_sh - CLK_sh - PL_sh
how many button can i use with this Shift register ?

ranenbg, 2024-07-14:
You seem to be missing to understand many things. You need to do some research about shift register chips and how they operate. The one you suggested has an i2C interface and you can't use that one.

Data, clock and pull are signals required for the operation of the shift register.

MrCjxer, 2024-07-14:
yeah, i told you i'm noob :)

so tell me for 3 things I mentioned, what i need ? ( software or hardware )
i want work on it hard and search for all i need

and with 6 :DT_sh ---- 7: CLK_sh ---- 8: PL_sh how many button i can use?
thank you

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

MrCjxer, 2024-07-19:
Hi again
bro any advice ?
for 21 or 22 button ?

how many shift register i can use on default FW ? 4 shift register or more or less ?

ranenbg, 2024-07-19:
Without any modification of FW, you can stack 2 8bit shift registers to get 16 buttons, or use arduino nano. With small FW mod you could utilize all 28 buttons that are available by HID, that is 3.5 8bit shift registers. By significantly moding FW and also its HID descriptor part, you can go up to 64 buttons.

MrCjxer, 2024-07-20:
hi again
thank you for your guidance <3

1 - if I want use XY Shifter, can I use it with 2 shift register? (8 button with XY shifter and 16 buttons with 2 8bit shift registers)
or just supported one function?

2 - or if I want use XY shifter, can I use it with 4x4 button matrix? (8 button with XY shifter and 16 buttons with 4x4 button matrix)

=====================================================
>With small FW mod you could utilize all 28 buttons that are available by HID, that is 3.5 8bit shift registers
> By significantly modding FW and also its HID descriptor part, you can go up to 64 buttons, that is 8 8bit shift registers.

but for small FW mod or significantly modding, need I change something on FFB-gui?

https://github.com/ranenbg/Arduino-FFB-gui

MrCjxer, 2024-07-23:
hi again
sorry bro to bother you again
can you tell me about three questions i asked?
I want to buy the components

>1 - if I want use XY Shifter, can I use it with 2 shift register? (8 button with XY shifter and 16 buttons with 2 8bit shift registers)
or just supported one function?
>2 - or if I want use XY shifter, can I use it with 4x4 button matrix? (8 button with XY shifter and 16 buttons with 4x4 button matrix)
>3 - If I go with " Button box - for Arduino Nano/Uno ", how many buttons will remain directly to Arduino Leonardo?
>

@johanneslerch
bro sorry to bother you too
can you help me with three questions?

and this
>but for small FW mod or significantly modding, need I change something on FFB-gui?
>https://github.com/ranenbg/Arduino-FFB-gui
>

thank you

johanneslerch, 2024-07-23:
Check the wiring diagrams. They show you what is used for what purpose. XY shifter is attached to analog buttons A4, A5. You can also see that if not used as shifter, they are mapped to buttons. How many buttons there can be, is just counting them in the wiring diagram. I leave that as exercise for yourself.

Note that XY shifter must be attached to an analog input. You can't connect them to shift registers.

MrCjxer, 2024-08-03:
> Check the wiring diagrams. They show you what is used for what purpose. XY shifter is attached to analog buttons A4, A5. You can also see that if not used as shifter, they are mapped to buttons. How many buttons there can be, is just counting them in the wiring diagram. I leave that as exercise for yourself.
>
> Note that XY shifter must be attached to an analog input. You can't connect them to shift registers.

Hi again and thank you bro
But the wiring diagrams very confusing for me 🥲

Yeah i know for XY shifter i should use analogs but i mean when i use XY shifter, can i use two shift register beside XY shifter?

And i bought the Arduino NANO for buttons box
Can you tell me, when i use it for buttons box, how many buttons can i have on the Arduino Leonardo as directly?🤔

I mean when i use 230cx.hex for Leonardo and connect Arduino NANO to the Arduino Leonardo, how many buttons can i have on the Arduino Leonardo as directly?
Even i want use A3,A4,A5 for normal buttons if there is any chance

Thank you 🙏🏻😊

ranenbg, 2024-09-09:
If you use Arduino nano as button box, with v231 HEX you can have 3 extra buttons on A3, A4 and D12.

Closed 2024-09-09.

Thread 58 (2024-07-31):

Arduino Nano

MrCjxer, 2024-07-31:
Hi
I want to use an Arduino Nano for button box, but which version I should use?

1 - Arduino Nano CH340
2 - Arduino Nano V3.0
3 - Arduino Nano V3.1
4 - LGT8F328P Nano
5 - Arduino Nano CH340 with ATMEGA168

or all are the same?
or maybe can I use 1 and 2 and 3 except 4 and 5 ?

thank you

ranenbg, 2024-07-31:
Hi, any nano with ATmega328 will work. They usually come with a Chinese USB-to-serial converter chip CH340, because the MCU does not support it natively.

MrCjxer, 2024-08-03:
Hi
Thank you

I have a new problem bro 😅🥲
I used FW 230cx.HEX for Leonardo
But when i uploaded it to board and open the GUI, after pass the steps, it goes directly to the main GUI app !

I mean when i choseed the Leonardo at this step :

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

It goes to this page :

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

I want config the AXIS and buttons or others like this :

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

What should i do ? 🤔

ranenbg, 2024-08-03:
Hi, you're welcome. Please, don't abuse this issue with another question, if I already answered what you needed in the first place. You close this one as solved and then make a new issue with a new question. I will answer your new question this time and close the issue. If you still have questions, please make a new issue.

This is not a problem what you're showing, this is how I designed my firmware/software. It's supposed to work like that, as you only need to configure the pink window once correctly on a single PC and that's it. This is just the link that makes sure you're using my firmware with my GUI. On the left side there are inputs that my GUI is expecting to see and in the right side is the actual HID device (usualy arduino with some of my HEX), but in general it may be any other joystick that exists. In principle, you can link any GUI axis with any HID axis, or any GUI button with any HID button, but that's simply irrelevant, as in your games you can map any axis or button to any function that you would like. Only for the sake of simplicity, I've put an example of how a pink window should be linked, to avoid confusion, as you can map axis to a button for example , or button to hat switch and so on..It is possible to reset the config such that you do the pink window again, but I'm not gonna explain that here at this moment.

Closed 2024-08-03.

Thread 59 (2024-08-01):

3-phase BLDC Motor

I2m0roI, 2024-08-01:
Hi,
has anyone tried to get a 3-phase motor to work?

I'm currently planning on using one from an old hoverboard, but can't find any motor controllers with direction-specific PWM inputs.
They all use one PWM / 0-5V input for speed and another for DIR (presumably pulled high internally, switch to GND to change direction).

Could I just connect both PWM outputs of the arduino to the corresponding input of the controller and use the 'PWM direction pin' for switching direction?

Best regards

I2m0roI, 2024-08-01:
Well, what a few hours of sleep can do for you... Found the PWM settings, solved.

Notriatv, 2024-08-17:
so.. did you got it working??

I2m0roI, 2024-08-17:
Yes I did. Just needed to switch to 'PWM+Dir' in the software.
But the motor controller (Walfront 5-36V from A***on) broke when I tested the torque with a 24V/5A power supply.
Still looking for a better replacement.

Notriatv, 2024-08-21:
can you provide more info about that? like some pics with wirings schemes?

Closed 2024-08-01.

Thread 60 (2024-08-05):

reset the config and calibrations

MrCjxer, 2024-08-05:
Hi
I want to reset the config
I mean I want to see the pink window for config and change buttons again
What should I do?🤔

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

*Note : i didn't see this pink window never 🤔 it's just automatic did the job 😅 but I want to change it and reset it
I am using 230cx.hex of your FW

Marcos2BR, 2024-08-07:
in dir. ...._\ranenbg-Arduino-FFB-wheel\wheel_control_v2_6_0\data_
delete file "Arduino Leonardo wheel v4" or "Arduino Leonardo wheel v5"

This is the file where the button map is located.

MrCjxer, 2024-08-07:
> in dir. ...._\wheel_control_v2_6_0\data_ delete file "Arduino Leonardo wheel v4" or "Arduino Leonardo wheel v5"
>
> This is the file where the button map is located.

Hi and thank you
I did delete files you said but it happened :

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

 and i still can't map buttons :(

Marcos2BR, 2024-08-07:
just config the COM PORT in file "COM_cfg.txt"
See more in **Troubleshooting - first time run** :  [COM_cfg.txt](https://github.com/ranenbg/Arduino-FFB-gui?tab=readme-ov-file#troubleshooting---first-time-run)

ranenbg, 2024-08-07:
Ok, I have to involve here. Plsease don't delete Arduino Leonardo wheel v5, file as this is what GUI expects to see in data folder. I'm not sure if you can create it yourself, it should be possible but I didn't check it. It must be named exactly like that, or the gui will hang in the startup like that.

Why do you want to change these mappings? Can't you just rewire your buttons such that you see it in GUI as you want? This is onky link between HID and mu GUI, you are not remaping buttons as seen by windows (HID).

Marcos2BR, 2024-08-07:
I'm sorry, I was just trying to help.
Before, I did tests on the protoboard and tried to use a potentiometer for the X axis, sometimes I needed to reset the mapping and I think I deleted the file...

ranenbg, 2024-08-07:
Yeah, no worries, I understand. It's just something I have not experimented with myself. I did originaly create the mapping using the pink window in the first place. This is not my code, it's just a HID library that I'm using. It has it's downsides, but this is how it is at the moment, it's pretty much dictated by that game controls plus lib. Without it, GUI would still work but one could not see any axis or buttons, as it reads directly the HID values from the device.

Just spend some time to rewire your buttons and you're good to go.

MrCjxer, 2024-08-17:
> Ok, I have to involve here. Plsease don't delete Arduino Leonardo wheel v5 file, as this is what GUI expects to see in data folder. I'm not sure if you can create it yourself, it should be possible but I didn't check it. If you do manage to create it by yourself, the mapping file must be named exactly like that, or the gui will hang durring the startup like that.
>
> Why do you want to change these mappings? Can't you just rewire your buttons such that you see it in GUI as you want? This is only link between HID and my GUI, you are not remaping buttons as seen by windows (HID). The games are looking at HID, so you should remap by hardware connections, it's very easy, I have documented which arduino nano pin corresponds to which HID button. What you're trying to do has no meaning, as I said before.

Hi
i want to change some buttons.
Like the handbrake axis, I don't it . and i want to remove it or change the buttons
may i have the ping page or not?

i am use your HEX for my Arduino Lenonardo
thank you

MrCjxer, 2024-08-17:
> I'm sorry, I was just trying to help. Before, I did tests on the protoboard and tried to use a potentiometer for the X axis, sometimes I needed to reset the mapping and I think I deleted this file...

hi
but it did not work for me :(
still need to get the ping window

MrCjxer, 2024-08-21:
@ranenbg

hi please HELP me :(
I need to remap the PINs and buttons
I was waiting for weeks :(

just tell me how to go in pink window and remap all PINs
thank you

ranenbg, 2024-09-09:
Either get a new arduino or just connect A4 to gnd.

MrCjxer, 2024-09-10:
BRO please! :|

can you just tell me how I should reset the configs and see the pink Window?!
it is not about just the A4 pin I want to change some button and ANALOG pins
all wires connected with shield, and I can't change it Hardware wise.
please just tell me how should I go in pink window, if it is impossible just tell me << it is not possible >>

THANK YOU ...

Closed 2024-09-09.

Thread 61 (2024-08-07):

enhancement request : MOTOR_ENABLE_PIN with PWM+-

Marcos2BR, 2024-08-07:
Hello Milos,
First of all, thank you very much for your excellent work.
I'm using your firmware on a Vintage AVB Wheel Force Feedback GC-FBW1

I don't know much about C, C++, just the basics to turn comments on/off and understand the basics of the code.
Following your tips I was able to compile HEX with arduino-ide by mounting the library in the "portable" folder.
In config.h I enabled
_#define USE_QUADRATURE_ENCODER ,  USE_HATSWITCH , USE_BTNMATRIX  , AVG_INPUTS  ,  USE_AUTOCALIB,  USE_CENTERBTN , USE_EXTRABTN_ and everything works fine.
Long live my dinosaur steering wheel and its 8 buttons + hatswitch + accelerator + brake + forcefeedback

**BUT** I feel the steering wheel a little hard at rest,
I saw that you gave the tip: "_if your motor is very hard to turn_..." (Motor driver wiring)

So I thought I'd ask you to implement "MOTOR_ENABLE_PIN with PWM+-" , something like :
  _//vsulako code
#ifdef MOTOR_ENABLE_PIN
  if (force!=0) //or other value
    digitalWriteFast(MOTOR_ENABLE_PIN, 1)
  else
    digitalWriteFast(MOTOR_ENABLE_PIN, 0);
  #endif_

I believe this will make the steering wheel turn smoother with low pwm, similar to Emc, Visulaco, RFR, etc

Sorry for the excessive blah blah blah, honestly, I'm thrilled to see my old school steering wheel coming back to life, and I'm also happy to let the local community know that there are alternative firmwares besides RFR and EMC.

ranenbg, 2024-08-07:
Hi dude, you're welcome.

Have you tried the the "tip" as the workaraound first? I'd like hear how
that went for you.

I'll think about how to implement your suggestion, I could utilize the
unused pin11 which is otherwise a direction pin, when pwm+- mode is used.
In principle, it's a very easy fix in the firmware, there should be plenty
of memory left for it.

Cheers,
Milos.

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

Marcos2BR, 2024-08-12:
> Hi dude, you're welcome. Have you tried the the "tip" as the workaraound first? I'd like hear how that went for you. I'll think about how to implement your suggestion, I could utilize the unused pin11 which is otherwise a direction pin, when pwm+- mode is used. In principle, it's a very easy fix in the firmware, there should be plenty of memory left for it. Cheers, Milos.

Hi Milos, the mechanics of my steering wheel have a 40:1 reduction , Maybe that's why at rest it feels "heavy" (with the engine braked)....
I made a connection with diodes in ENABLE (attached photo) and it was very smooth at rest and small turns.
I did not measure the PWM R/L time with an oscilloscope, but I imagine that below 20% the BTS output is still in tri-state.

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

Closed 2024-09-09.

Thread 62 (2024-08-17):

There way to replace DC motor to hoverboard motor?

x-channel, 2024-08-17:
There way to replace DC motor to hoverboard motor? There any driver for hoverboard with same PWM controller than bts7960?

Closed 2024-09-09.

Thread 63 (2024-08-25):

How would i make this work without a motor driver

n00dlephr0g, 2024-08-25:
Not really an issue but a question..
the title may make this seem silly, but i plan on building a sort of hand held steering device along with analogue pedals all within the form factor of a controller, and this means that i wont need that much torque or power.
Is there any way to just drive a small dc motor with a pwm signal or something similar? if not what would be a good alternative to the massive motor driver?

ranenbg, 2024-08-25:
Hi, you can try to use L298N, you can't power the motor directly from arduino pwm pins as it will probably burn.

I'm not sure what is your form factor, but an h-bridge is a very simple circuit to make, that requires only 4 transistors. I just did a quick google search and there are a ton of available circuits, ranging from simple to more advances with its own microcontroler. I'm guessing you will do your own pcb to place some buttons and arduino, so you could easily integrate an h-bridge into it.

Closed 2024-09-09.

Thread 64 (2024-09-02):

AS5600 Magnetic Encoder

joeyda, 2024-09-02:
Hi, I have a brushless motor with an AS5600 magnetic encoder and an arduino pro micro, is it possible to work with your firmware using i2c?

ranenbg, 2024-09-02:
Hi, at the moment AS5600 is not supported in my firmware. I have no plans to implement its support in my firmware, as this type of encoders is not suitable for the ffb wheel due to not good enough response, speed, resolution and noise level. It is used mostly for digitizing pots, knobs or basic angle readout.

joeyda, 2024-09-02:
Good to know, thank you!On Sep 2, 2024, at 12:36 AM, Miloš Ranković ***@***.***> wrote:
Hi, at the moment AS5600 is not supported in my firmware. I have no plans to implement its support in my firmware, as this type of encoders is not suitable for the ffb wheel due to not good enough response, speed, resolution and noise level. It is used mostly for digitizing pots, knobs or basic angle readout.

—Reply to this email directly, view it on GitHub, or unsubscribe.You are receiving this because you authored the thread.Message ID: ***@***.***>

joeyda, 2024-09-04:
Thank you for the additional info. I was looking into making a small handheld wheel with a brushless gimbal motor since they are so quiet and tiny. I have a motor driver and was going to use simple FOC to control it

ranenbg, 2024-09-09:
Yes, I see why you want AS5600 in the controller like this it is more convenient due to the small space, but I still think an optical encoder is far superior. It will have higher resolution, no noise at all, and instant reaction speed plus you can easily add some gears to it, add a DC motor and a small h-bridge like LN298 and you're good to go.

jairov96, 2024-09-10:
That's dope, thank you very much!

Anywhere I can donate/buy a coffee to the cause?

ranenbg, 2024-09-10:
You're welcome. I still have to do some testing, but if you wish to donate there is my paypal in the GUI near bottom part of window.

ranenbg, 2024-11-06:
I'm closing this one, as I have already released firmware v240w firmware which supports AS5600 magnetic encoder via i2C bus.

Closed 2024-11-06.

Thread 65 (2024-09-06):

Adding trigger buttons

HOMECODERNEO, 2024-09-06:
Building and testing the device I had an idea to add to the firmware and GUI program the possibility to configure some buttons as triggers (provided that in their place in the “matrix” will stand toggle switches place buttons). That at the events on-off and off-on events there was a short pulse of 200-300ms simulating the button presses, while the toggle switch will simply change its position without remaining clamped by the button as it is now. I don't know if I managed to describe the essence of the idea (I apologize as I translate through a translator) and how this idea sounds adequate in relation to your project.

ranenbg, 2024-09-06:
Hi, why not just use a normal togle switch and connect it to two buttons?

HOMECODERNEO, 2024-09-07:
For example, in the same ETS2 if I use the turn signal switch from the car in my homemade system, it turns out that to turn on and off the turn signals I have to move the lever twice, it does not look realistic. After all, this switch has a fixed position, not pressed. This is a basic example, and there are several other situations like this.

HOMECODERNEO, 2024-09-07:
This is a pretty specific case, and worth considering as an idea for improvement if it has the right to exist in the project.

ranenbg, 2024-09-07:
It's a good idea, I agree. On the coding side of things it's not simple at all to implement it, as I would need to use timers and quite some memory space for it. Also, I don't want to implement a feature in firmware that will be usable only in ets2.

I read your first post a few times and I'm not sure that I understand exactly how you want these special buttons to operate. I'd appreciate if you explain again in more details, with an example of function in the game that you want to simulate and how the firmware should handle that. How does ets2 handle sterring indicator lights?

To me it seems that what you want can be easily done by using correct hardware. There are many types of switches, like the ones with 2 poles, 3 positions that always go back to center position.

ranenbg, 2024-09-09:
It may be possible to such a feature implement on some buttons that are directly on arduino, but definitely not in the button matrix. It uses a special algorithm to scan all rows and columns to find which buttons are pressed, there can't be any timers there.

Thread 66 (2024-09-10):

How to change mappings of buttons and axis?

EbrSiami, 2024-09-10:
Hello sir, first of all I have to thank you for your very nice and practical project because it solved one of my biggest problems. Actually, I did everything right and now everything works great, but my big problem is that unlike the pictures, no screen like the one for calibrating the controls (Wheel_control_gamecontrols_setup.png) opens for me. I wanted to ask how can I solve the problem? Thank you very much
![Uploading Wheel_control_gamecontrols_setup.png…]()

ranenbg, 2024-09-10:
Hi, you are very welcome.

I'm not sure that I understand what the problem is exactly. You said yourself that everything is working well? Can you please elaborate on what you have done so far and what kind of hardware are you using?

I'm not able to open the png you attached, but I suppose you are talking about game controls plus library, which has a pink setup window. It has nothing to do with calibrating any axis. You can calibrate the analog axis directly from GUI.

EbrSiami, 2024-09-11:
Yes, exactly. Im using an Arduino Leonardo and as I said Everything connected is great, except for a few things. Actually, I want to change the buttons and other things so that they work properly as well. I tried to try other ways like changing some codes etc. but I didn't succeed.I want that pink page to open for me so that I can do this, but unfortunately this page does not open for me. Even on the first run.

ranenbg, 2024-09-11:
Ok dude, I knew who you are from the beginning, but I do appreciate wanting to do a fresh start.

Mapping the pins and axis to buttons is done through code and not through pink window. I worked extremely hard for many years to get it to this stage and all buttons and axis are mapped in that way as a result of very hard thinking. Every single pin on all 3 arduinos is used for something. Furthermore, those mappings are not static, some buttons are dynamically changing for each fimware option/version. It took me a lot of time to figure out how to do this, such that end user only needs to comment or uncomment some lines in config.h and that's all.

If you wish to change mappings, there are several layers that have to be take care of. This is a very difficuilt task for a beginner programmer. On the other hand, simply rewiring the button to a different pin, which is already assigned in code to be a button, or axis is much much easier.

I would appreciate if you show me your hardware, you mentioned that you are using some shield for axis and buttons? Just remove it and make the new connections as you wish yourself.

MrCjxer, 2024-10-29:
Hi

I need that too
please just tell us how to change mapping or change the buttons

Closed 2024-11-06.

Thread 68 (2024-11-01):

flight firm request.. also. What a shame!!

Notriatv, 2024-11-01:
Hello Rane, I have a question.. would it be possible to develop a version with an additional PWM output? It might be necessary to remove some features to free up memory for this, but the idea would be to create a specific version for flight controllers with support for feedback on two axes. I managed to feel FFB effects like side wind in MSFS20 through the steering wheel using a plugin called 'XPForce' (only 10min trial), but there is only one active PWM output in the firmware you provide. What do you think? Would it be possible to create a firmware like this? Thank you in advance.

also it's a shame that such a great piece of work receives so little recognition. : )
If you don't mind, I made a video showcasing your work and posted it on YouTube so that people can benefit from your work, which I believe has great potential. Here is the link if you want to check it out. https://youtu.be/eAml14yTIjk

ranenbg, 2024-11-01:
Hi man, tnx very much for your youtube video. I understand a little bit of spanish, so I got the gist of what you were saying in portugese. You covered most important stuff very well, and it was a cool to watch it.

Although I have two ffb axis in HID, It's not trivial to add a 2nd ffb axis via pwm output. I was busting my head before with this. This suggestion is a legit expansion of firmware and it's definately possible. The execution however, on arduino in my oppinion would not have satisfactory results. I'm talking about flight stick axis with pots and low frequency 8bit PWM (very noisy and low resolution FFB). Maybe I could use two AS5600, but still PWM would be the major limitation, as there are not 4 PWM pins with 16bit resolution. Arduino only has one 16bit timer, associated with pins D9 and D10. Another option is to make 2 channels with 16bit PWM+DIR signals, but then bts7960 can't be used. One more thing comes to mind - to use external DAC's for analog FFB output. That would allow usage of AASD and servo motors, which is a huge increase in cost. Or to have 16bit FFB on X-axis and 8bit FFB on Y-axis, with PWM+- (h-bridge) signals..There are several options how to do it, but none of them would retain the quality of the firmware as it is now, so I'm still undecided.

OpenFFB firmware for stm32 already has support for more than 1 ffb axis and various motor drivers like dual odrive and so on..It is suited much better for the flight stick and it's worth looking into.

Notriatv, 2024-11-03:
Hi bro, I'm glad that you liked it! I'll be making many more detailed videos about it. It’s really cool, and I hope more people discover your project.

So yeah, the idea is to do it at the lowest cost possible and in the easiest way as well. Using servos will make things a little more complex to deal with. I don’t know how effective an 8-bit FFB on the Y-axis would be (maybe it’s enough for a flight simulator). Anyway, I’ll soon create a mechanical part for it and will use a Bourns multiturn pot, or I might test an AS5600 in pot mode using a spring for the Y-axis and FFB for the X-axis. It should definitely be cooler than the Logitech ones. Let’s see how it goes!

Also, there is a guy (Gagagu Arduino_FFB_Yoke) working on a 2-axis FFB support for the ATmega32U4, and he’s also doing a great job . I think people underestimate the power of this chip. i know tha any stm32 is more advanced and better than it but I believe it’s enough for many users—just my opinion, you know, lol!

big tnx!!!

ranenbg, 2024-11-03:
I'm pretty sure he makes 8bit ffb on both axis with 8bit PWM, if he uses h-bridge 2ch config for each motor. This is not what I want to do, so I need to think more about how to do it properly.

Avoid using pots for any ffb axis, AS5600 is a very good alternative, if you can't use optical quadrature encoder.

Notriatv, 2024-11-04:
sure, everything you create I'm ready to test. thanks

Closed 2024-11-04.

Thread 69 (2024-11-03):

its me again with FFB matters

Notriatv, 2024-11-03:
hi.
1. I have 15nm with my belt drive wheelbase (or even more... there are some dangerous peaks sometimes). While Windows is booting, I avoid touching the steering wheel because if I do, it starts to cycle like crazy. Actually, I have a power supply switch and turn it on just after the booting process to avoid hurting myself lol. Does this happen to you too?

2. In some games like Assetto Corsa and many others, I can't change FFB filters or anything (even open Wheel Control GUI) while the game is minimized. If I do, I lose FFB, although everything else works fine.. The solution is to restart the game. (it used to happen with AI-wave wheel config too) ETS is one of the few games not affected by opening Wheel Control while playing.

3. It's not really a question, but I noticed that the friction slider really helps remove back EMF feeling from motor, making it really soft. Any value between 199-101 gradually makes it softer, with 101 being the softest and the wheel starts to "overshoot." As you increase to 200, it becomes heavier, while values below 100-0 make steering even heavier. It's a bit confusing, but I found a good range for me (170-190). It depends on other parameters like general gain/pwm frequency, etc.

thank you again!! Cheers!

ranenbg, 2024-11-03:
1. yes, best is to first plug in arduino once win boots, then turn on psu for motor
2. not sure why this is happening, again, not much I can do about it, if the game takes over the com ports
3. this seems wierd, friction effect should always make wheel more heavier, I need to have a look why it becomes softer above 100% on friction gain slider, tnx for reporting this

Cheers man

Closed 2024-11-04.

Thread 70 (2024-11-09):

Question about shift register

hikineet98, 2024-11-09:
Hello ranenbg. Thank you for this great project.
I would like to ask about shift register.

Setup:
-Arduino Leonardo
-bts7960
-Arduino nano v3.0 ch340 (shift register)
-Firmware: 241chfx

Behaviour:
Button press not work on Tx, d3 pin and other pins at Leonardo side (eg: button to switch to reverse gear at pin 4) when firmware 241chfx used. But those pins do work when i switched to firmware 241ahx.

I don't really know how the shift register work, but when i measured the voltage on each pin, pins that work show ~5v when button not press and 0v when pressed. Pins that not work is opposite.

One more thing is about Arduino nano firmware upload. I saw an old issue when you suggested upload using atmega328p (old bootloader). But when i upload using old bootloader, it just freezed at uploading state. Upload using atmega328p works immediately.

About those buttons that work. When i pressed 4 or more buttons, all the buttons in the nano just pulsing.

Also I'm using a long phone cable to connect from Leonardo to nano, and a breadboard  to connect all gnd and vc pin. Could it be too long connection or maybe some thing not properly connect cause this problem?

Please enlighten me.

ranenbg, 2024-11-09:
Hi, you're welcome.

Tnx for reporting this issue. I have not seen it before and I can't tell right away why this is happening. I will have a look at this particulair HEX version on Leonardo and let you know. My initial guess is that it has something to do with nano v3.0, as I didn't use those new ones, only older ones that come with "old bootloader".

The "shift register" code for nano has internal pullups enabled which means that all pins will be high (5V) - not pressed, until shorted to gnd (0V) - pressed. It is wierd if that's not the case on nano.

Pin Tx is not for button, it is one of encoder pins. Pins D3, D4 are buttons but not in all HEX. I will look into this, to see if I can reproduce the issue and see what can be done about it.

hikineet98, 2024-11-09:
Thanks for the quick reply.
My wheel is totally usable and i have already enjoyed some games so please take your time.
But you know, the more buttons the better :))

ranenbg, 2024-11-13:
Ok, I have managed to reproduce the issue where on HEX v241chfx, pins on nano 3.0 (with buttonbox code) Tx, D3 and D4 are not working. I'll see if anything can be done about that, if so, I'll update the buttonbox code for that nano version. I had to set ATmega328P in order to get it to upload, as the "old bootloader" did not manage to upload to this 3.0 board. It has a new bootloader and there is something different, I don't know what.

Also, you are correct, pin D4 on Leonardo for the reverse gear button is not working. I have to fix that somehow in the following fw version, tnx once again for reporting it.

hikineet98, 2024-11-14:
Thanks for the quick update! I'll test it when i get home and close the issue if there's no other problems.

Closed 2024-11-14.

Thread 71 (2024-11-19):

I couldn't find the Arduino folder

Eyadserry, 2024-11-19:
While compiling the software I reached the part where I needed to go to C/users/(username)/ local/ Arduino at that point I couldn't find the Arduino folder neither Arduino15 or any Arduino related folder I made sure that "show hidden folders" option was selected and tried to re install the Arduino boards and the Arduino IDE but it's was useless when I asked for help from someone who said that he is using your software I told me neither he could find that folder at he continued the steps and the software worked fine that's what I did too and it worked, so I'm asking you if this is gonna effect the efficiency in the future? , if yes how to solve it ?

ranenbg, 2024-11-19:
Hi, I don't know why those folders are not present in your PC. A few people did manage to compile the source themselves following those instructions already.

I did try a few times to find a way of how to utilize modified arduino core in a more elegant manner by defining include lines with a specified folder path which contains .cpp and .h, without succsess. For the past 6 years, I was hoping that someone will eventualy figure it out and help with this, and I still do. This is as far as could get on my own.

Closed 2024-11-30.

Thread 72 (2024-11-22):

Dúvida

Giraita, 2024-11-22:
Hello, I used your firmware, which is very good, by the way. Recently, I got an STM32 and switched to OpenFFBoard, but there's a problem: Open works with a range of ±32k, and I would need it to be 0 to 65k. Could you explain how you achieved this? I’m willing to edit Open's firmware!

ranenbg, 2024-11-25:
Hi, you're welcome.

I have simply changed axis range in HID.cpp and then before sending the USB input report I add 32k to a variable for that particular axis.

Giraita, 2024-11-26:
Thank you !

Closed 2024-11-26.

Thread 73 (2024-11-22):

Feature request Ability to add 16 bit ADC

moezzasif, 2024-11-22:
Please add the ability to use 16 bit adc for FFB software

ranenbg, 2024-11-22:
Hi, first of all, if you want me to even consider implementing anything in the firmware/software, you'll have to be much more specific about your request.

The firmware already supports ADS1015 (12bit) and ADS1115 (16bit) ADC chips. To enable the 16bit one, you just need to comment 1 line not to use the 12bit one and uncomment the other one for ads1115. But it's not so simple, as only X and Y axis are 16bit in HID, and others are 12bit. X-axis is already used for encoder and Y axis is reserved for load cell brake wich has 24bit HX711 chip, or can be set to pot and arduino 10bit analog input is used or ads1105 12bit. Another downside of using ads1115 is that it is very slow. It will slow down the entire loop, making all other inputs to run slow, including reducing the FFB frequency to something about 100Hz or so, depending on how many inputs you want to read from it. This is why I didn't compile a HEX with such an option.

Just out of curiosity, which ADC did you have in mind? There are many available with various comms, i2C, SPI, i2S and so on..

ranenbg, 2024-11-22:
Yes, I can see that, however, one has to start from somewhere. You are welcome.

Porting my firmware to stm32 is a huge amount of work. It requires completely rewriting most of the code from scratch and I have no plans of doing that. Others have done that already and there is plenty of available FFB firmware for stm32F407 like: MMOS, EMC, VNM, or OpenFFBoard. The last one I strongly  recommend, as it is the most advanced of all and one can use it even to make a direct drive wheel, once paired with the special motor driver board done by the same guy.

Thread 74 (2024-11-30):

problem with buttons

Eyadserry, 2024-11-30:
I don't know if this is a problem. When one button is pressed and I try to press another button, the other button doesn't work. Instead, the first button toggles .

ranenbg, 2024-11-30:
Hi, what firmware are you using? Which buttons? Are you talking about buttons on arduino, or nano or button matrix?

Eyadserry, 2024-11-30:
v240chtx, I'm using the button matrix on leonardo.

ranenbg, 2024-11-30:
Yeah, not sure, doesn't sound like normal operation that I intended, will need to investigate. Tnx for eporting it.

Eyadserry, 2024-11-30:
https://github.com/user-attachments/assets/fd9dda26-ab4d-487e-8a85-6571e560e8b5

As you can see in the video, I pressed button number 8. While it was pressed, I also pressed button number 0, and then button 8 started toggling. When I released my finger from button 8, button 0 lit up. I did the same thing again."

Eyadserry, 2024-12-01:
if you have other questions to solve the problem, I would be pleased to answer.

ranenbg, 2024-12-01:
Tnx, for now this is enough info.

Eyadserry, 2024-12-01:
ok, I'm gonna close the issue.

Closed 2024-12-01.

Thread 75 (2024-12-13):

Magnetic encoder magntek-MT6816

mac-gar, 2024-12-13:
Hello.
I would like to ask for some advice from you or the community gathered here. How to use the MT6816 magnetic encoder in this project. I see that the code has support for AS5600, which connects via I²C and my encoder has several interfaces: ABZ, UVW, PWM or SPI

I would like to use its parameters to the maximum, because they are very good:
https://xonstorage.blob.core.windows.net/pdf/magntek_mt6816ctstdr_apr22_xonlink.pdf

14-bit Core Resolution
Output Propagation Delay <2 us
Maximum Rotation Speed   25,000 RPM

If it is possible to add such support in this project, I would be very grateful. If for various reasons it is not possible. Please give me some advice, can I send these parameters to Arduino micro pro in another way.

ranenbg, 2024-12-13:
Hi, this seems like a very good  anglular sensor. Tnx for suggesting it.

After reading quickly through its data sheet that you provided I can see that it has an ABZ output of up to 1024PPR. In principle you can already use it like that, once you configure it in ABZ mode. This means you have 4096CPR which is good.

On the other hand, to utilize its full 14bit resolution by implementing SPI is possible. But if you want me to add I'd appreciate very much an example code for arduino that reads angle over SPI with multiturn capability. Then I could chech if I can fit that code into firmware.

mac-gar, 2024-12-16:
I don't know how to use the code from this source, but there is a driver for this encoder with an example

https://github.com/simplefoc/Arduino-FOC-drivers/tree/master/src/encoders/mt6816

https://github.com/simplefoc/Arduino-FOC-drivers/tree/master/examples/encoders/mt6816/mt6816_spi

ranenbg, 2024-12-16:
That is exactly what I needed, tnx.

Thread 76 (2024-12-13):

driver for bldc???

Notriatv, 2024-12-13:
Hi Rane,
Regards!

I’m really satisfied with ffb that my DIY belt-driven/IBT-2 provides. But I was thinking about using Arduino with your program to control some BLDC motors, such as hoverboard motors or any other 3-phase motors. But I’m not sure which driver would work with Wheel Control for Arduino. Which pinout should I use to connect the boards? Which mode should I run? (PWM+DIR? 0-50-100? RCM mode?)

I’m really lost on how to do this and whether it’s even possible. let me know if you know a good driver to run a bldc motor

I’ve been looking into some BLDC drivers, and here’s what I found that could be a cheap option. What do you think about them?

1
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
  https://pt.aliexpress.com/item/1005007634026470.html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,scm-url:1007.40196.366991.0,pvid:27899184-88d6-4b12-bcdd-1cecf4220a55,tpp_buckets:668%232846%238107%231934&pdp_npi=4%40dis%21BRL%2174.51%2122.35%21%21%2185.56%2125.67%21%402101efeb17341259448666382eb710%2112000041584593943%21rec%21BR%21803869506%21XZ&utparam-url=scene%3ApcDetailTopMoreOtherSeller%7Cquery_from%3A

2
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
https://pt.aliexpress.com/item/1005006419395042.html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,scm-url:1007.40196.366991.0,pvid:5b527bfd-2e90-46cf-847e-b70041d86339,tpp_buckets:668%232846%238107%231934&pdp_npi=4%40dis%21BRL%2167.78%2135.24%21%21%2177.83%2140.47%21%402101efeb17341259800057061eb710%2112000037142323608%21rec%21BR%21803869506%21X&utparam-url=scene%3ApcDetailBottomMoreOtherSeller%7Cquery_from%3A

3
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
https://pt.aliexpress.com/item/1005007442976530.html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

4
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
https://pt.aliexpress.com/item/1005006604285603.html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

useful info i guess https://docs.simplefoc.com/

That's it. I know that ATmega32 isn't the best MCU for a DD Wheel, but one day I'd like to give it a try—just to see how bad it could get XD

thanks in advance!!

ranenbg, 2024-12-13:
Hi, bldc motor driver is extremely complex topic that goes outside of the scope of my original purpose for the ffb firmware.

Out of these 4 drivers that you listed, only 4th one seems promising since it has FOC. I'm afraid that it's not possible to get good result with cheap bldc motor drivers. Most of them only have speed control, and you need torque control for ffb wheel. If the driver has pwm0-50-100 input mode (like some howerboard motor drivers) you can use that with my firmware. Maybe some will have even an analog torque input. Another option is comertial AASD 30A 3 phase motor driver and some 10Nm mige motor, this driver has analog torque input.

My advice for you is to join OpenFFboard discord and ask around how to make ffb wheel with howerboard motor + moded O-drive + stm32f407 with OpenFFb firmware. This is the cheapest DIY DD wheel one can make. There are some techical manufacturing chalenges, but it's manageable for most hobby guys.

Notriatv, 2024-12-14:
yes.. I see.. bldc is great but also a really complex thing to work..
well thanks for your tips!!
 also FFbeast for ODESC is other good option for hoverboard motors..
THXX!!

Closed 2024-12-14.

Thread 77 (2025-01-14):

Out Of Memory

namcktv, 2025-01-14:
#ifndef _CONFIG_H_
#define _CONFIG_H_

//------------------------------------- Options ----------------------------------------------------------

//#define USE_VNH5019				// Pololu dual 24V DC motor drive (partially inplemented)
//#define USE_SM_RS485				// Granite devices simple motion protocol (not implemented yet)
//#define USE_LCD					// milos, LCD via i2c (not implemented yet)
//#define USE_ADS1015       // milos, uncomment for 12bit pedals, commented is 10bit from arduino inputs (can not be used with AVG_INPUTS)
//#define USE_DSP56ADC16S			// 16 bits Stereo ADC (milos, can not be used with USE_SHIFT_REGISTER)
#define USE_QUADRATURE_ENCODER		// Position Quadrature encoder
#define USE_AS5600          // milos, uncomment to enable magnetic encoder via i2C instead of optical encoder
//#define USE_ZINDEX          // milos, use Z-index encoder channel (caution, can not be used with USE_ADS1015, USE_MCP4725 or USE_AS5600)
//#define USE_LOAD_CELL				// Load cell shield // milos, new library for LC
//#define USE_SHIFT_REGISTER			// 2x8-bit parallel-load shift registers G27 board steering wheel (milos, this one is modified for 16 buttons)
//#define USE_DUAL_SHIFT_REGISTER		// Dual 8-bit Parallel-load shift registers G27 board shifter  (milos, not available curently)
//#define USE_SN74ALS166N          // milos, uncomment to use 3x8bit parralel-in serial-out shift register chips for 24 buttons, otherwise it's 16 buttons with ard nano-buttonbox (must be used with USE_SHIFT_REGISTER, but not implemented yet)
#define USE_XY_SHIFTER    // milos, uncomment to use XY analog shifter (can not be used with USE_BTNMATRIX, note that for proMicro clutch and handbrake will be unavailable)
//#define USE_HATSWITCH        // milos, uncomment to use first 4 buttons for hat switch (D-pad)
//#define USE_BTNMATRIX        // milos, uncomment to use 8 pins as a 4x4 button matrix for total of 16 buttons (can not be used with load cell, shift register or XY shifter)
//#define AVG_INPUTS        // milos, uncomment to use averaging of arduino analog inputs (can not be used with USE_ADS1015)
//#define USE_AUTOCALIB        // milos, uncomment to use autocalibration for pedal axis (if left commented manual calibration is enabled)
//#define USE_CENTERBTN    // milos, ucomment to assign digital input pin D2 for hardware wheel recenter to 0deg (caution, can not be used with USE_ZINDEX, USE_ADS1015, USE_MCP4725 or USE_AS5600)
//#define USE_EXTRABTN    // milos, ucomment to configure analog inputs on pins A2 and A3 as a digital button inputs (2 extra buttons, note that clutch and handbrake will be unavailable)
//#define USE_MCP4725      // milos, 12bit DAC (0-5V), uncomment to enable output of FFB signal as 2ch DAC voltage output
//#define USE_ANALOGFFBAXIS // milos, uncomment to enable other than encoder X-axis to be tied with FFB axis
//#define USE_PROMICRO    // milos, uncomment if you are using Arduino ProMicro board (leave commented for Leonardo or Micro variants)
#define USE_EEPROM // milos, uncomment this to enable loading/saving settings from EEPROM

#define CALIBRATE_AT_INIT	0 //milos, was 1

Sketch uses 29382 bytes (102%) of program storage space. Maximum is 28672 bytes.
Global variables use 1192 bytes (46%) of dynamic memory, leaving 1368 bytes for local variables. Maximum is 2560 bytes.
Sketch too big; see https://support.arduino.cc/hc/en-us/articles/360013825179 for tips on reducing it.
Error compiling for board Arduino Leonardo.

ranenbg, 2025-01-14:
Hi, why are you posting this as an issue?

You obviously can't upload any program that uses more than 100% of available memory.

namcktv, 2025-01-14:
I want to use AS5600, XY_SHIFTER, EEPROM but recompilation is too memory

namcktv, 2025-01-14:
What are the benefits of EEPROM?

ranenbg, 2025-01-14:
I'm not sure that commenting out EEPROM will give you that extra 2% of memory. Best is to comment out XY shifter and use another arduino just for XY shifter.

namcktv, 2025-01-14:
> Do you ever wonder why I have not compiled a HEX that already has this? Well, I guess, now you know.
why is it mandatory to use QUADRATURE_ENCODER, while AS5600 is an alternative, you can update the code so that AS5600 runs independently without depending on QUADRATURE_ENCODER option?

namcktv, 2025-01-14:
why is it mandatory to use QUADRATURE_ENCODER, while AS5600 is an alternative, you can update the code so that AS5600 runs independently without depending on QUADRATURE_ENCODER option?

namcktv, 2025-01-14:
> I'm not sure that commenting out EEPROM will give you that extra 2% of memory. Best is to comment out XY shifter and use another arduino just for XY shifter. Or use optical encoder instead of a magnetic one.

Sketch uses 27510 bytes (95%) of program storage space. Maximum is 28672 bytes.
Global variables use 1190 bytes (46%) of dynamic memory, leaving 1370 bytes for local variables. Maximum is 2560 bytes.

ranenbg, 2025-01-14:
Ok, just change default settings when not using EEPROM and you're done.

ranenbg, 2025-01-14:
Yes, it's possible. It is on my very extensive to do list..

namcktv, 2025-01-14:
#ifdef USE_AS5600 // milos, added
cQuadEncoder myEnc;
AS5600L as5600(0x36); // uses default wire.h, milos added i2C address
#endif

And comment out USE_QUADRATURE_ENCODER

Sketch uses 15406 bytes (53%) of program storage space. Maximum is 28672 bytes.
Global variables use 1131 bytes (44%) of dynamic memory, leaving 1429 bytes for local variables. Maximum is 2560 bytes.

ranenbg, 2025-01-14:
You can't just comment it out, you then leave out everything :)

namcktv, 2025-01-14:
> You can't just comment it out, you then leave out everything :) axis, buttons, ffb, the code has nothing without USE_QUAD_ENCODER
>
> I have to work on that when I have time. Or you can do it yourself..

It is a very difficult thing for me, just hope you have time for the problem I mentioned.

ranenbg, 2025-01-14:
I'll see what I can do, but I'm not promising anything.

namcktv, 2025-01-24:
[brWheel_my.zip](https://github.com/user-attachments/files/18530378/brWheel_my.zip) I compiled and uploaded successfully but when I opened the GUI it didn't recognize the AS5600 and the project is stuck until now.

Thread 78 (2025-01-15):

maybe silly question

neas15us, 2025-01-15:
would the i2c communication work over:
 https://www.amazon.com/Bluetooth-Module-Wireless-Transceiver-Arduino/dp/B0B2WFZXPQ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

neas15us, 2025-01-15:
says it has tx rx state vcc gnd and en

ranenbg, 2025-01-15:
State and enable are control in/outs, these are not for communication.

neas15us, 2025-01-15:
what communications does the i2c need

ranenbg, 2025-01-15:
https://www.google.com/search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

neas15us, 2025-01-15:
https://www.adafruit.com/product/3876
would this one work as according to the website it has the communication pins

Thread 79 (2025-01-21):

Can use Nano's analog pins for XY shifter, throttle, clutch, brake?

NamkingWIN, 2025-01-21:
Hi, Your work is great!
I have wonder: why we dont use analog pins from Nano to control XY shifter, throttle, clutch, brake even hand brake? It will release some pins on Leonardo. With that free pins on Leonardo we can use from matrix button?
Thanks for your work

ranenbg, 2025-01-21:
Hi, thank you, you're welcome.

Even though this may sound like a good idea at first, let me explain why it's not.
1. one needs 2 arduino's for basic wheel functionality
2. reliability issues, you don't want your pedal or shifter inputs gone in the middle of a race
3. speed issues, to send six 10bit analog inputs from nano to leonardo means sending 60bits via software spi with a 90kHz clock, one needs 180 clock cycles  only to send them and this is not even counting how much time it takes nano to do adc conversion, no way could main leonardo loop run at 500Hz
4. using nano as button box as it is already, to send 16 buttons (16 bits) already slows down main leonardo loop to about 300Hz which is still acceptable as not many games have more than 300Hz ffb, but I don't want any more slowdowns
5. arduino is simply not fast enough

There, I hope this clears it.

NamkingWIN, 2025-01-22:
Thanks for your explaination. Have you think about seperating the main wheel and the shifter+pedal+button box? Or switch to stm32 controller?
But I should tell you again: your work so great and I love it. I have collecting all materials to build the FFBwheel. I am newbie so any guide with more details are avaiable? Your post on github just the wiring electronics parts.
The config I use:
#define USE_QUADRATURE_ENCODER
#define USE_SHIFT_REGISTER
#define USE_XY_SHIFTER
#define USE_HATSWITCH
#define USE_CENTERBTN
#define USE_ANALOGFFBAXIS
#define USE_EEPROM
#define CALIBRATE_AT_INIT	0

The built file has 99%
Is that OK?

Thank for your time.

ranenbg, 2025-01-22:
Hi, there is no benefit in separating the firmware into wheel and pedals, as then I would have to rework the gui and maintain two firmware instances.

I have no plans to port firmware to stm32, as it requires a complete code rewrite. I don't want to re-invent the wheel. There are already works of others like mmos, emc, vnm and openffb firmware available for stm32f407.

There are plenty of examples for a DC motor + belt drive ffb wheel builds on youtube. One great builder I worked with is Orban Kokbudak, look him up. They also have a discord channel where you can find all mechanical details.

As long as you can compile and fit the code in arduino memory, it will run fine. So far, I have not seen any issues caused by low remaining dynamical memory (ram). For your options combination, just make sure to set the firmware version to 241 (converted to hexadecimal form) in order for gui to properly recognize all the features, this is also in config.h

NamkingWIN, 2025-01-22:
Config for version is below:
#define VERSION		0xF1

Is that correct?

ranenbg, 2025-01-22:
if 15×16+1=241 then yes

Thread 80 (2025-01-27):

Change I2C pin for AS5600

namcktv, 2025-01-27:
For some reason, my Arduino Leonardo can't start if AS5600, even though I use the original example of AS5600 library, I change to pin 0 and 1 then it works. is there a way to change to 0,1 in your project?

ranenbg, 2025-01-27:
No, rx and tx pins are reserved for encoder.

Did you try using SDA and SCL pins on Leonardo for i2C?

namcktv, 2025-01-27:
SDA 2, SLC 3 but not working

namcktv, 2025-01-27:
I did everything I could, only changing the battery worked

imedox, 2025-10-04:
i get the as5600 gpio pin floating 'not connected at all) and it work just fine for me ! only i need to GND+DIR--to--->GND arduino

Thread 82 (2025-02-05):

Hex file  for ( Adc + xy shifter + button matrix )

Pawan419, 2025-02-05:
Hey. I wanna use adc and xy shifter at same time. But cant find this combo in any hex file.   And  Can someone tell me using adc can slow the main Leonardo board??  And button configuration is confusing me..  if I don't use nano for buttons or button matrix...  What's pinout for buttons then?  I can't find any combo with ( Adc + xy shifter + button matrix ) s + f + t . Can someone help me?

ranenbg, 2025-02-05:
Hi, I usually compile possible HEX combinations, the ones that can fit in leonardo's small 32k memory.

There is a HEX with f and t, but fitting also s can't be done as it goes over 32k limit. Yes, "s" option with ADS1015 considerably lowers the Arduino main loop. If you really want it, you can use another leonardo just for pedals that have the "s" option.

If you don't use button matrix or external button box (nano) then available buttons are listed in the firmware pinout, it's the first image in the github readme.

Pawan419, 2025-02-05:
Thanks sir.  I will find some way coz assetto corsa didn't let me use multiple hid devies for gameplay.  But I will make hall sensor pedals separately n try to make it work.
Can u tell me which version of hex file gives best ffb... I will adjust buttons n pedals with other Arduinos to keep ffb at its fastest response or am I wrong to do it ?
I really appreciate ur work 😊

ranenbg, 2025-02-05:
You are welcome.

All firmware versions have the same ffb, however v240 versions have full 500Hz ffb, because they are most basic. You should note that final quality of ffb depends on pwm settings, so as on game ffb update rate - 60Hz iRacing, 100Hz lfs, 180-300Hz acc and so on.

My gui can only connect to 1 leonardo at a time, so you would have keep changing COM_cfg depending on shich one you want to configure. It's not a bad idea, considering you will once calibrate pedals and not have to touch it anymore. But I recommend using v240ft and having everything in one arduino.

For pedals, you csn use hall sensors, but considering noise, if done correctly sith shielding even pots are fine.

Pawan419, 2025-02-06:
I was thinking alot last night and now woke up lil confused...  Idk much abt coding.  If I m using 6 axis with Leonardo s internal ADC... Pedals and xy shifter.    Will this make main loop slow compared to external ADC ?  I wanna use 6 as5600r for 3 pedals. 1 handbrake and 2 xy shifter. But I can replace one with hx711 load cell....    And 600 ppr incremental encoder for steering.
I have tried ai wave wheel too. It was buggy.  Affbwheel dint work well with shift registers coz ets2 wasn't reading buttons for gears well.
My main concern is.... If I use nano and configure it to give output like external ADC...  It will process data frm 6 As5600 or (5 as5600 + load cell hx711) reducing load from main Leonardo. Will this work?  N can u share ur email. I wanna ask something else too.

ranenbg, 2025-02-06:
Arduino internal ADC is quite fast, it takes about 0.1ms for a single readout, so reading 6 analog axis is still quite fast and there is even some time left even after reading encoder pulses and processing other functions.  Main loop takes anywhere between 1ms to 2ms, so full 500Hz is available.

You can use multiple AS5600 but only in analog output mode, this will be the same as if you connected 6 pots. I recommend in that case to use at least 1 of them for steering via i2C bus, that is with firmware "w" option in order to utilize its full 12bit resolution. Arduino adc is only 10bit which is fine for pedals.

Using nano to read and send analog axis via my shift register protocol has been asked many times before. I allways say that it will do no good, because sending so much data with my "software made" protocol as it is now will only slow down things way too much. It was designed to send only a few (16) bits for buttons. If one wants to send 60bits or more, i2C or SPI communication between nano and leonardo has to be implemented. This is possible, but it's a lot of work and I don't have plans to do it anyti.e soon.

You can see my email in GUI.

Thread 83 (2025-02-07):

Motor recommendation.

SurArc67, 2025-02-07:
Hi, so i really wanted to build this project, but i have no idea about what motor should i choose. So can you maybe give some recommendations, and maybe add them to the docs?

ranenbg, 2025-02-07:
Hi, I can recommend Johnson RS775 dc motor. It's 300W, cheap and has enough torque, about 0.8Nm peak. You for sure need some gear or pulley ratio of atleast 1:5 up to 1:10. There are a few versions of it, try to get one with the lowest rpm if you can, as you need low rpm high torque for ffb wheel.

Good options is also RS875. Take care about voltage, at 12V these beasts are hungry for curent, so you need a psu of at least 20A. Note that 12V will draw more curent amd 24V version will draw less. They have the same power (P), which is product of voltage×curent, so you can change the ratios between the two, depending on which psu you can get.

SurArc67, 2025-02-07:
Thanks, great work btw!

ranenbg, 2025-02-07:
Thank you, you're welcome.

Some other recommendations for pulleys. You can use HTD 3M timing belt, 15mm witdh and a smallest pulley you can find for the motor, it needs to have a 4mm bore as this is the motor shaft thickness. Guys usualy design and 3D print their own big pulley for the motor shaft. It should be 8mm minimum, aluminium or cheaper version steel rod.

ranenbg, 2025-02-07:
That depends on the pulley ratio you are going to use. After the reduction from pulleys, you should have at least 250rpm max wheel rpm in order to ensure good FFB response and reproduction of higher vibrational frequencies above 50Hz.

For example, when using a pulley ratio of 1:10, your motor has to have at least 2500rpm. Usually for RS75 motors this is around 17k rpm which is not ideal, because it means it will have low torque. A good motor for an FFB wheel is the one with a very low rpm and huge torque, like the ones in the direct drive wheels.

SurArc67, 2025-02-07:
This may be a domb questions, but there are some 795 3000 RPM motors, are they suitable for this?

ranenbg, 2025-02-07:
It's not a dumb question. Yes, that is a good motor.

Notriatv, 2025-02-07:
> Hello, there are a lot of options for rpms, and i wanted to ask, what is like the optimal number of rpms?

hey guys wasup, I recently made videos showing the power of a low speed 775 (6000rpm at 24v) 0.58nm as in seller specs..)
I did a test with a 1:12 htd3m standards and a test with 20:1 gt2 patern... I find it's a surprising motor with that size

here's a link if you want to checkout. I'm speaking portoguese but you can use captions if needed

https://youtu.be/RFx5mbu9JVg?si=bEo6Odjk0ECvDuMI  htd3m

https://youtu.be/vtaQUBeWG40?si=s_NrH49Rm9fDSlK3  gt2

Notriatv, 2025-02-07:
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

1:12 test

but considering thermal efficiency I'd recommend a 895

ranenbg, 2025-02-07:
Tnx man :)

shubham0x13, 2025-03-18:
> Hi, I can recommend Johnson RS775 dc motor.

Will I need two BTS7960B drivers if I use dual RS775 motors?

ranenbg, 2025-03-18:
Most probably yes.

shubham0x13, 2025-03-18:
Got it, thanks! I'll plan for two BTS7960B drivers then.

Thread 84 (2025-02-07):

XY Shifter with Joystick module

NinjaFrozr, 2025-02-07:
I want to make an XY shifter using a HW504 Joystick module, I've wired the module's X axis to A4 and Y axis to A5. I have grounded my unused Analog pins (A2 and A3) yet i still can't get the shifter to calibrate properly. There are areas on the calibration screen that my shifter just doesn't go to (bottom right for example). I did of course move the boundaries around but i still can't really get it to go into the 8th position.  Is it not suitable to use a joystick module for XY shifter ? Or have i made some other mistake somewhere ? I'm on an Arduino Leonardo and firmware v240azfx

ranenbg, 2025-02-07:
You didn't make any mistake, the problem is most probably with the pots themselves in the joystick module. They simply don't have enough angle range to cover full resistance swing from 0 to what ever their max resistance is.

If you have a multimeter, set it in resistance mode and measure between middle pin and one of the outer pins, move the joystick and observe how much resistance can swing. Then measure between outer pins, this is pots resistance. Middle pin should be able to reach both outer pins, if it doesn't that explains your issue.

NinjaFrozr, 2025-02-08:
Thanks for the quick and detailed response. I should probably at least find and test a spare joystick module before i consider trying your alternative solution.

I will update tomorrow and add screenshots if can't get it to work.

ranenbg, 2025-02-08:
If you don't have a multimeter, you can use arduino. Simply make a new sketch where you read 2 analog inputs and send them to serial port using Serial.print() function. It should be something like this:

void setup() {
Serial.begin(9600);
pinMode(A0, INPUT);
pinMode(A1, INPUT);
}

void loop() {
Serial.print(analogRead(A0));
Serial.print(" ");
Serial.println(analogRead(A1));
}

Connect your joystick middle pins to A0, A1, use gnd and 5V. Open serial monitor in arduino IDE and observe the 2 pot values.

NinjaFrozr, 2025-02-15:
I switched to using 2 potentiometers instead of a joystick module. Now i was able to set the boundaries so that my shifter can go into every position. But now i wonder if there is a way to calibrate the shifter potentiometers exactly how we can calibrate the pedals ? Because physically my x and y pots move very little and so all the boundaries have to be very close to each other as it is. It works, but it would be better if we could set the min and max positions for each shifter axis so that we can get a more sensitive xy position.

ranenbg, 2025-02-15:
Arduino analog inputs are 10bits. That meas total of 1024 steps between 0V and 5V, or if internal adc reference is enabled then from 0V to 2.56V. If you feed your pot with 3.3V or 5V this is the only way to increase the sensitivity of analog input when using lower than 5V ref for adc.

But, you're focusing your attention in the wrong direction. You can't fix everything through software. The software is precise enough. What you should do instead is build a joystick mechanics such that each pot is rotated more, for example by using some gears.

NinjaFrozr, 2025-02-15:
This is not what i meant. Perhaps sensitivity is the wrong word for it. I don't know how it works in the code but in the gui we can "teach" the software the min and max position of the pedal axis. I was asking if the same was possible for the shifter XY axis. And if not, it would be super useful to  have it. EMC has this feature and the XY shifter design I'm using is one of the most popular on Youtube. I've already gotten the shifter to work, i was just making a suggestion as the calibration is at the limit (the sliders can't move any closer together).

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

ranenbg, 2025-02-15:
Yes, I deliberately made it like that, but that's only in gui. After long consoderation, I believe that a correctly working shifter has to be able to have at least this minimal range of axis, for it to function correctly.

Anyway, manualy you can set shifter calibration more precisely.

Closed 2025-02-15.

Thread 85 (2025-02-08):

Faulty motor driver ?

NinjaFrozr, 2025-02-08:
My ffb is weaker on one side. I've played around the settings like FFB Balance, central gain, centering gain, min pwm etc. The centering spring allows me to turn the wheel to the left significantly more than to the right. Basically, weaker force signals in the clockwise direction are just ignored and only very powerful effects work in both directions. It's probably nothing to do with the software as i can see from the FFB monitor that it is applying forces equally in both directions. I would instantly chalk it up to a faulty BTS 7960 if it weren't for the fact that powerful effects like the end stop seem to work fine in both directions. I still think the driver is faulty but i wanted to put this out there before ordering a new one.

ranenbg, 2025-02-08:
Hi dude, for that reason I implemented FFB balance slider, it does exactly what you are describing. At which value do you have it? Center balance is at 128.

NinjaFrozr, 2025-02-08:
In the GUI i have it all the way to the right. The problem is, changing the balance more towards the weaker side only makes the working side weaker, it doesn't make the weaker side stronger. Let me explain in more detail:

With settings 100% central and centering gain, %10 min pwm and balance at center:

I can turn 20 degrees towards the right and it comes back to center when i let go. When turn left however, there's nothing until i turn 90 degrees and right then it just locks up and i can't turn it any further, but when i let go it stays there and doesn't center. It's like it can't apply any forces smaller than the force that it would apply at 90 degrees off center.

ranenbg, 2025-02-08:
I see, maybe something is reversed, or maybe I have a mistake in how I coded the ffb balance feature, but it's low probablility as it's very simple function.

I need to check it.

NinjaFrozr, 2025-02-08:
Yes, it is with the z option. Honestly i have no idea if i managed to set it correctly, but during all my ffb testing i just hit the center button to test the centering spring and during the tests the movement of the wheel icon was in line with my actual movements. So i although i couldn't set the z offset properly, i made sure that the wheel was at 0 degrees in the software when testing the centering spring.

As for the problem i had setting up the z index : when i plug in the arduino and launch the app i find my wheel at something like -147 degrees. I hit "z" , bring the wheel to a center position irl, and then hit "center" and "save". Then to test, i unplug the arduino, spin my wheel to a different place and re-plug the arduino and it's -147 again. So i didn't manage to set up the z offset properly.

ranenbg, 2025-02-08:
You need to move your wheel till z index is found then if you did everything properly it should show the correct angle. The z offset correction procedure you described seems ok.

NinjaFrozr, 2025-02-08:
Yeah this whole z index thing was new to me when i did the mounting so i didn't pay attention to it. I can fix the mounting so the real z index matches my wheel center. There's a small dent on the rim of the front metal plate of the encoder, i'm guessing that represents the z index ?

Also, any other ideas about the asymmetrical ffb situation ? I'm still leaning towards a hardware issue, you mentioned motors having different torque for each direction. My motor isn't exactly common. It's a big bulky fan motor 24V 3000RPM, very powerful.  I purchased it after seeing it from some other content creator that built a wheelbase with it, so it should be suitable for the project. I think i will just order the BTS 7960, it's not that expensive and even if that's not the issue it can't hurt to have a spare motor driver lying around. Meanwhile I'm open to do any further testing if you have something on your mind.

NinjaFrozr, 2025-02-08:
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

Here you can see that the wheel is rotated 92 degrees to the right. FFB monitor shows a big force but it just sits like that when i let go of the wheel. It stops me from turning any further, but doesn't center.

ranenbg, 2025-02-08:
Yeah very wierd, it's hard for me to ubderstand just from this picture what exactly is going on. Being it a fan motor, it could be that it realy is designed to provide more torque in just one direction, sibce fans usualy just spin one way.

NinjaFrozr, 2025-02-08:
Yeah i tried to post a video but the upload failed for some reason. Anyway, i will keep testing and report my findings here.

NinjaFrozr, 2025-02-13:
Good news, the issue is resolved and it was a faulty motor driver like I suspected. The fan motor wasn't the problem. It is still slightly unbalanced but setting the FFB Balance to %50 towards the right fixes it. So the balance slider is doing it's job properly.

Closed 2025-02-13.

Thread 86 (2025-02-11):

Question about max gain and compilation for g27 mod

laurolopesdantas, 2025-02-11:
Hi Milos, first of all, great job man, really great updates, I tried your version 240x and was perfect to my project, and then I tried to make something odd, I jumpered de signal cables of the encoder on a g27 and wired the motors with the project in order to not tear down the g27 and keep it assembled, works fine, but due to the reduction gear on the encoder the ffb was too weak(way more weaker than the original g27), can you give me some advice were in the project I can set the max gain on the ffb above the maximum 200 that it has to compensate that, and how can I compilate the 0x version of the brWheel_my.ino (I already had the arduino IDE and etc, do not know how to select the version to compilate the 240x), Thanks in advance.

ranenbg, 2025-02-11:
Hi Lauro, thank you for copying the question in github. I get a lot of questions directly on my email and I can't keep repeating myself, so I hope you understand why I insisted to continue here.

Now about your question about max ffb gain. Obviously ffb signal has a limit and that is 100% (general gain slider). This is very much like audio signal level - where sound card can output only so much. You should not use more than 100% as this will lead to ffb clipping and loss of details. Instead try to increase ffb level from the source - game.

If you still need more, any further amplification is done by - amplifire, in our case this is the motor driver, or BTS7960. Since it operates in constant voltage mode, ffb signal amplitude is modulated using pwm (pulse width modulation) to drive the motor. Simply, a power supply voltage is quickly being turned on and off. The 0% pwm duty cycle corresponds to 0V, while 100% pwm is power supply voltage, say 12V. Motor coils have a certain resistance which for the sake of simplicity we're consider only as resistive (no complex impedance). By applying voltage across the coil some current will start passing and this current will create magnetic field in rotor which then interracts with a static mag field from magnets in stator and produce mechanical torque. Our ffb signal is this torque and it is in a direct relation with coil current.

If you want more ffb, you simply have to send more curent into the motor. This you can do by feeding more voltage to BTS, say 24V like original G29 motor driver circuit. Note that at 24V motor will draw more curent and power supply has to be able to provide that. This will also cause motor to dissipate some more heat, which you need to move away otherwise it will overheat and burn eventualy. I'm not sure, but G29 mainboard may have a constant curent motor driver and this is much better and it can directly control torque - ffb.

I have a section about compiling arduino source code in github readme towards bottom, have a look there if you're getting compiler errors. If you can compile, then go into config.h and simply comment out or uncomment certain lines. For v240x, you need only quad encoder and analog ffb axis, everything else is commented out. Correspondingly in the same header file a little bit down you need to set a version to 240, in hex format this is 0xF0. Correct version is required such that GUI can correctly recognize the specific firmware features and configure itself to properly display them.

laurolopesdantas, 2025-02-11:
Hi, I  understand your explanation but I made some tests and the weakness is related to de reduction gear on the g27 encoder, if I use a incremental encoder direct on the wheel shaft the ffb is fine, about the same of the original g27, but using the g27 optical encoder with the gear reduction the ffb end up divided by the ratio I guess. I will try to compile following your instructions, thanks for the answer

ranenbg, 2025-02-11:
You have to set the correct CPR including the gear reduction in GUI.You have to experiment a little bit untill you get 1:1 match between rotation of the virtual wheel in GUI and your G27 wheel rim.

I think encoder in G27 has 30 or 60PPR and gear reduction is 15:1. That gives a max CPR=4×60×15=3600, so try with this and adjust from there.

laurolopesdantas, 2025-02-11:
yes I did that in the beginning, 3600 and 4000 matches the angle but the ffb keeps weak, even with everything max out include in games, I think the code does not take into consideration the gear reduction, that same problem happens with other firmwares

ranenbg, 2025-02-11:
The firmware does take it into consideration if the CPR is set correctly. Even if it's not set correctly ffb does not depend on wheel angle, because the games send constant force ffb effect only. The ffb is weak probably because motors don't have enough curent.

laurolopesdantas, 2025-02-11:
12v 30A, as I said works fine if I place a incremental encoder directly on the shaft, only gets too weak using the geared optical encoder of the g27, how can I install the Arduino Boards v1.6.21 too compile the project ?

ranenbg, 2025-02-11:
Not sure why it makes a difference when mounting encoder on wheel shat as opposed to the motor via gear reductor.

In arduino IDE 1.8.19, go to manage boards then select 1.6.21 and install it.

Notriatv, 2025-02-12:
> 12v 30A, as I said works fine if I place a incremental encoder directly on the shaft, only gets too weak using the geared optical encoder of the g27, how can I install the Arduino Boards v1.6.21 too compile the project ?

g27 works with 24v motors

ranenbg, 2025-02-12:
What are you using to create ffb? Are you just using autocenter spring force or are you actualy testing in some game? If so, which game is it? You can also generate and test ffb with programs provided in misc folder like fedit or wheelcheck.

Enable realtime ffb monitor in GUI by pressing on a small red square button next to general gain slider. There you can see how strong the ffb signal is, coming directly from the game. If it's already in the red, increasing the gain will not do anything as ffb is already maxed out.

ranenbg, 2025-02-12:
That depends on how you connected the two motors. You have two options: [1] serial or [2] parallel connection.

For [1] the voltage will be split between motors, and for [2] current will be split between them. Neither of the options is ideal and the splitting will most probably be uneven. It will depend on the mechanical load that each motor sees, as well as coil temperature (resistance). You have to give both a try and observe the differences.

The ideal would be to use 2 bts and just provide the same PWM inputs to both of them.

laurolopesdantas, 2025-02-12:
The serial wiring is better, I  tried righ now and make a difference, the effects itself are not that much weaker, is more the resistance while turning that not maches the original g27 force, I tried to change the torque in PWD torque = torque*2; but seems to not make much difference.

ranenbg, 2025-02-12:
I see. Don't increase pwm signal by brute force, you will only get clipping.

ranenbg, 2025-02-12:
Not really, but you can ise pin11 for bts enable pins. I made such a feature to turn off bts when ffb is 0, so without autocenter spring it shouod be easier to turn.

laurolopesdantas, 2025-02-12:
But i want the opposite, the spring is already numb on turning, I want to boost up lol

laurolopesdantas, 2025-02-12:
I tried, make little to none difference, anyway thanks for the help, let me know in the future if you tried this odd behavior when the ffb end up been a lot weaker if using a low resolution encoder with a high gear reduction such that 1:15 one, I find this setup interesting because of the possibility of not tear down the original g27, and it is a lot more easy to build because the encoder is already in place and working, you can keep all your buttons, gearbox, pedals and etc, i think a lot of people would find this interesting.

ranenbg, 2025-02-12:
You are welcome.

Yes, that is the idea behind the project.

laurolopesdantas, 2025-02-12:
Don't ask me how, Out of the nowhere after some firmware reinstalling starts to work, now the force is the same as the original, not great but with a better and improved ffb, and I rewire the motors in parallel, thanks and again great job

laurolopesdantas, 2025-02-12:
for those who are interested in making this assembly is just jumper the first and the third pins on the encoder plug of g27 board(black and white wires) to the signals on the arduino, and then wire the motors to the bts(in parallel) and that is it!

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

ranenbg, 2025-02-12:
You also need to connect ground wire from G27 board to the Arduino. How is encoder getting powered? Don't need to give it 5V to work?

laurolopesdantas, 2025-02-12:
don't need to connect the ground or the 5v, with the g27 on the usb it is already powered, as well the gearbox, pedals and all buttons, the advantage is exactly to use the wheel buttons and etc.

ranenbg, 2025-02-13:
Ah ok, you have a working G27 already :)

laurolopesdantas, 2025-02-19:
Yeap, today I notice a little problem with this build, de perfect CPR is 3945, I can turn the wheel to both ends and matches perfectly, I turn  all the way several time and the center keeps right, but if I turn the ffb on(BTS on psu) after a couple turns in game or in config it loses gradualy the center, there's no interference in the signal wires and only happen with the ffb on.

ranenbg, 2025-02-19:
Hi Lauro, yes, this is typical situation that we call "encoder step skipping".

Encoder needs pullup resistors, the lower the value the faster encoder response. Typicaly values between 10k and 1k do the trick. If you didn't put any pullups that explains the problem. I have enabled internal pullups in firmware but they are 100k which is simply not fast enough and additional ones are required.

ranenbg, 2025-02-19:
It has no pullups. That 1 resistor you see there is to limit the current on IR led. You need to put pullups between A - 5V and B - 5V.

laurolopesdantas, 2025-02-19:
Yeah I did that, equal what I do with the normal setup that I had, didn't work, 1k resistor

ranenbg, 2025-02-19:
Maybe it needs a pulldown resistor instead of pullup. The only way to know for sure is if you measure its output with a scope. Each encoder channel should have a nice square signal, where low level is 0V and high above 3V.

laurolopesdantas, 2025-02-20:
Tried pulldown and pullup and nothing in both cases the sensor turn off after do it, tune down all sliders to 0 except constant gain seems to help but the problem persist, very strange.

ranenbg, 2025-02-20:
No, ffb sliders have nothing to with it.

laurolopesdantas, 2025-02-20:
I was able to fix this issue by unplugging the encoder from de g27 board and providing a separated GND and 5v power to the cable, instead of take advantage of the g27 board 5v and gnd, thanks again, now this build is complete haha

ranenbg, 2025-02-20:
Great, I was about to suggest you the same thing.

Closed 2025-02-20.

Thread 87 (2025-02-13):

About ffb texture

laurolopesdantas, 2025-02-13:
Hi Milos, me again bothering you, I did some tests with the ffb and the only thing I could find that I dislike is the texture of the scrub effect while braking, feels a little bit odd, not mute, but different of anything else I tried before, is like i can't feeling that signature bouncing texture on the ffb, is that something that I could tweat with the sliders of configuration, or mess up with the code frequencies to tweak that ?

ranenbg, 2025-02-13:
You can adjust PWM settings, to give you a little bit more details, because this is what defines the final FFB resolution, regardless of what the game is sending.

I made safe defaults in firmware phase correct, 16kHz, pwm+-, which gives +-500 steps of FFB resolution in both directions. You can use fast top, 8kHz this wilo give you +-2000 steps of FFB which should be enough.

Make sure you don't use more than 100% in general gain and constant force sliders, as this lowers the FFB resolution as well. Use FFB monitor to fine tune level of FFB strenght in game such that you barely see red (avoid clipping).

Ultimately, FFB quality depends on a game, car, setup, track..

laurolopesdantas, 2025-02-13:
Doesn't change, but as you said I notice that is game related, in AC the scrub ffb is pretty much the same I'm use to, but in AMS 2 has this odd and different feeling, I suspect that is more advanced, in others games the scrub feels like a kurb, but in ams2 is much more subtle, like a sandpaper, I think I wold have to go in ther other way and tune down de details on ffb to get the same result of AC, again thanks.

ranenbg, 2025-02-13:
Note that you have to restart arduino in order to apply any changes in pwm settings.

Each sim has its own "flavour" of FFB, that we get so much used to after playing for a long time, in a way that everything else just feels wierd. But the truth is that none of sims have "real" FFB, because in a real car most of the car feel comes from the seat and g-forces, the forces in the wheel alone are not telling much. Game devs have to incorporate all of that into wheel forces in some way. Each one has their own idea how that should be done and that is why each sim has its own charm.

laurolopesdantas, 2025-02-13:
yeap, you're right. Now i'm experiencing suddenly lost of ffb mid turn, seems the spring just gave up and return a few seconds latter, this is a known issue ?

ranenbg, 2025-02-14:
No, I never noticed loss of ffb just all of a sudden. In which game is this?

laurolopesdantas, 2025-02-14:
In AMS2, using a custom ffb profile

ranenbg, 2025-02-14:
Ok, I have that game, will check.

In the meantime, could you please describe how can I reproduce ffb loss behaviour?

laurolopesdantas, 2025-02-14:
I just select custom ffb(I will send you the file) gain 50, fx 50 everything else at 0, then load interlagos on f3 301 version 5 laps and that's it, after a few laps the loss of ffb starts to happen mid turn, then return after a few seconds or turns, as I said is like the spring just gave up suddenly

[ffb_custom_settings.txt](https://github.com/user-attachments/files/18800628/ffb_custom_settings.txt)

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

laurolopesdantas, 2025-02-18:
Hi again, I noticed the same problem in AC, so is not game related, then I tried everything, change USB, change the config, use a note shared gnd to the BTS and nothing, even suspecting of overheating in the motot or BTS, so watching the ffb monitor on AC I noticed that was clipping and staying in the red zone for too long and Tried to reduce de gain in game, that seems to help, do not know yet if solve for complete the problem, but definitely help, there is a way to debug the program to know whats happening when the problem show up ?

ranenbg, 2025-02-18:
I have the ffb debugging feature in the firmware. It is possible to see exactly which ffb effects the game is sending and with which parameters.

I was suspecting a problem with periodic effects which have timing, but you said it's also in AC. Those games only send constant force ffb effect and eventualy damper effect. Both of these are time independent, which leads me to beleive there is a hardware issue on your side. If ffb monitor still shows signals when you observe ffb cut, that means it's not firmware related.

Bts has internal over temperature protection, where it shuts down. It could be this.

laurolopesdantas, 2025-02-18:
Yeah, In think that could be that, the ffb monitor keeps running normal and sometimes in the red when the problem happens, also the BTS heatsinc was very hot, I'm gonna try some cooling solutions, thanks

ranenbg, 2025-02-18:
As long as the heatsinc is hot that is good, because you can always move heat away from it by directed airflow from a fan for example.

laurolopesdantas, 2025-02-18:
Today is a very hot day here in Brazil and placing a fan righ on the BTS seems to be solved or mitigated the problem

Thread 88 (2025-02-17):

Hall effect sensors for pedals

MrCjxer, 2025-02-17:
Hi bro

Can i use this hall effect sensors for pedals?🤔

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

ranenbg, 2025-02-17:
Hi bro. I've looked ar the datasheet for 3144, it seems that is only has a switching operation, meaning only 2 states. Unless you want to use your pedals like buttons, this will not work. LM394 is just an opamp which sets the high level of signal to 5V I guess. In other state when there is no mag field, I suppose output is 0V.

MrCjxer, 2025-02-18:
Hi
Yes i did tested it and it's work just like a button
But what model do you recommend to me ?
I bought 3 of these but i should throw it to trash 😭

ranenbg, 2025-02-18:
Sorry bro, S49E is analog.

MrCjxer, 2025-03-18:
Thank you bro

Closed 2025-03-18.

Thread 89 (2025-02-20):

Arduino not recognized

namcktv, 2025-02-20:
Windows has stopped this device because it has reported problems. (Code 43)

A request for the USB device descriptor failed.

The arduino back to normal when i upload another sketch not your project, i think its a problem with the hex file

namcktv, 2025-02-20:
Please compile brWheel_my.ino.leonardo_v241chfx.hex and brWheel_my.ino.leonardo_v240zfx.hex and brWheel_my.ino.leonardo_v240fx.hex

ranenbg, 2025-02-20:
Tnx man, I'll try to do it as soon as I can.

ranenbg, 2025-02-21:
Hi, I have just uploaded the existing HEX files in my GitHub repository you mentioned to my Leonardo board and this is what I found:
[1] leonardo_v240zfx.hex - reported and works normally
[2] leonardo_v240fx.hex - reported and works normally
[3] leonardo_v241chfx.hex - reported and works normally

I don't keep the source code for v23X firmware so I can't recompile its HEX anymore (you should use v24X), but anyway, I gave them the same checking and I found that:
[1] leonardo_v230zfx.hex - reported and works normally
[2] leonardo_v230fx.hex - reported and works normally
[3] leonardo_v231chfx.hex - reported and works normally

So everything seems fine from my end. You should download the HEX from my repository, don't get it from the release. I've re-compiled some HEX after the release as there were some configuration mistakes. I'm preparing a new release with some updates and that is why I didn't re-release v24X.

namcktv, 2025-02-22:
My Arduino Leonardo may be faulty, I tried things related to i2c and serial port all stuck not booting and Windows doesn't recognize arduino, thanks for the help. By the way I may do a project for STM32F4XX based on your project, can you support me?

Thread 90 (2025-02-24):

dual bts7960

kick-a-poo, 2025-02-24:
hello, the issue im having is with dual bts7960, I have both connected in parallel but i am having issues where the ffb works in only 1 direction, if i move to the left it works but from center to right it completely freaks out and makes loud noises from the motor and starts to spin more to the right.

fixes i have tried
replaced both motor drivers
replaced the wiring
rewired everything to make sure it is working
swapped motor cables and tested it, now it works to the right but from center to left it freaks out

any help is appreciated

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

kick-a-poo, 2025-02-24:
update found the issue, it was the LPWN wire that was loose, update to future people if 1 side is working it is most likely a loose connector

Closed 2025-02-24.

Thread 91 (2025-03-15):

How to use the hardware wheel re-centering feature?

shubham0x13, 2025-03-15:
I am using an AS5600 sensor and need guidance on how to use the hardware wheel re-centering feature. How does it work, and what steps should I follow?

ranenbg, 2025-03-15:
Hi, unfortunately, in the current version of firmware it's not possible to use an i2C bus device like AS5600 and centering button at the same time. They both require hardware interrupt capability of pin D2. For i2C bus this is the data line or SDA and centering button is also setup on this pin.

Tnx very much for asking about this, as it didn't occur to me before. I'm at the moment working on a new firmware version where I have made quite some changes. One of those is a possibility to completely disable usage of an optical encoder - its two hardware interrupt capable pins TX and RX become unused. I'll have a look if there is enough memory left to remap the center button pin to one of those two if optical encoder is not used and if as5600 is used. I think it will be doable.

shubham0x13, 2025-03-15:
Thanks for the clarification! I appreciate the effort you're putting into the new firmware version with added flexibility. Looking forward to the update, great work!

ranenbg, 2025-03-15:
You're welcome dude, tnx for this great suggestion. After thinking about how to implement it, I'm very optimistic, since it's only a matter of remaping center button pin, by using compiler predefinitions. No actual changes in the code are neccessary.

shubham0x13, 2025-03-15:
Maybe a dumb question, but I need to connect a switch/button to a pin and design my DIY wheel in such a way that it gets triggered when the wheel is in the centered position.

ranenbg, 2025-03-15:
No, it's much simpler than that.

You will connect a button or a switch to a center button pin in a way that once you press it it connect the center button pin to the ground, that's all.

The firmware is using interrupt and a pullup. I made it in such a way that you firat need to press the button, then once you release it the centering function is executed.

shubham0x13, 2025-03-15:
Ohh, I see! I initially thought it would automatically calibrate the wheel's center position at boot or on a button press, similar to an endstop in 3D printers. But now I get it pressing the button simply brings the wheel back to the center position I calibrated earlier.

ranenbg, 2025-03-15:
It's even simpler than that. There is nothing to calibrate, I simply initialize as5600 position at 0deg on arduino powerup. So you have two options:

[1] align wheel to center, plug arduino to usb port
[2] If it happens that your wheel was angled before arduino startup you will move it back to center by hand and then press center button

shubham0x13, 2025-03-15:
Got it! Thanks for the explanation and help.

MrCjxer, 2025-03-18:
> Tnx very much for asking about this, as it didn't occur to me before. I'm at the moment working on a new firmware version where I have made quite some changes. One of those is a possibility to completely disable usage of an optical encoder - its two hardware interrupt capable pins TX and RX become unused. I'll have a look if there is enough memory left to remap the center button pin to one of those two if optical encoder is not used and if as5600 is used. I think it will be doable.

Hey buddy. What?! Did I hear that right?! You want to completely disable optical encoder support?! 😲
Or do you want to add the ability to disable the optical encoder in the firmware? 😃

MrCjxer, 2025-03-20:
> Nothing to worry about. It's going to be just a firmware option, where if you comment out the usage of the quad encoder in Config.h simply the functions for the encoder will not be used and some program memory will become free.
>
> update. I have already implemented this feature in new firmware, the re-center button is remapped to the TX pin, when no optical encoder is used and when the magnetic encoder is used along side center button firmware option. I still have plenty of things to finish up and test before I can release v250, but it's coming soon.

OH , thank you bro . poof .

And when will this new firmware be released?
If the exact date is not specified, give me an estimate because I want to plan accordingly, my friend. 😊🔥

ranenbg, 2025-03-20:
I plan to release it as soon as it's ready.

I have finished coding firmware and GUI, updated documents, manuals, pinouts, and wiring images. I still have to compile HEX files for both Leonardo and proMicro. There are new firmware options, so now I have many more combinations for HEX, I'm still deciding which ones to compile. After that, I have to upload everything to Git Hub and update the readme's. I don't want to give any rough estimates, but most of the hard work I have already done, what's left is the most boring stuff.

MrCjxer, 2025-03-20:
Hi

Oh yeah, thanks bro! 😎😍
I wish you success, both in work and in life. 😊🙌🏻🥂

ranenbg, 2025-03-20:
I've just uploaded a new firmware release. The original question is implemented, so I will close this issue.

Closed 2025-03-20.

Thread 92 (2025-03-20):

Custom Firmware Modifications & Feature Requests 🚀

MrCjxer, 2025-03-20:
# 📌 Custom Firmware Modifications & Feature Requests 🚀
# 📌 Custom Firmware for Racing Setup 🚀

## Project Overview
Hello, my friend! 😊

I've been trying to modify a firmware for my setup, but due to my **limited programming knowledge**, I haven't been able to implement the changes I need, even after months of effort. I would really appreciate your help!

---

## 🔧 Hardware Configuration

### 🎛️ Analog Inputs (A)
| **Pin** | **Function** |
|---------|------------|
| **A0**  | Throttle   |
| **A1**  | Brake     |
| **A2**  | Clutch    |
| **A4**  | Button (or disabled due to a faulty board) |
| **A5**  | Empty     |

### 🎛️ Digital Inputs/Outputs (D)
| **Pin** | **Function** |
|---------|------------|
| **D0**  | Encoder   |
| **D1**  | Encoder   |
| **D2**  | Re-center wheel |
| **D3**  | Empty     |
| **D4**  | Empty     |
| **D5**  | Empty     |
| **D6**  | NANO 16 Button |
| **D7**  | NANO 16 Button |
| **D8**  | NANO 16 Button |
| **D9**  | Motor Driver |
| **D10** | Motor Driver |
| **D11** | Motor Driver |
| **D12** | Empty     |
| **D13** | LED / Empty |

---

## 🎮 Requested Modifications

| **Pin** | **New Function (Convert to Button)** |
|---------|--------------------------------|
| **A4**  | Button (or disabled) |
| **A5**  | Button |
| **D3**  | Button |
| **D4**  | Button |
| **D5**  | Button |
| **D12** | Button |
| **D13** | Button (if LED is not used) |

## ⚙️ Additional Features Required

| **Option** | **Function** |
|-----------|------------------------------------------|
| `"a"`     | Enable pedal axis auto-calibration (otherwise, manual calibration) |
| `"c"`     | Hardware wheel re-center support |
| `"h"`     | Hat Switch (D-pad) support |

---

## 📂 Preferred Output
✅ **Open-source code** (preferred)
✅ Otherwise, a **HEX file** would work

💰 I understand that this requires time and effort. If necessary, I am **willing to compensate** for your hard work with a payment or donation. I'd rather support **you** than go to someone else.

**I truly appreciate your help!** Looking forward to your response. 😊🙏

ranenbg, 2025-03-20:
You may check out HEX v250achexn, it should have everything you mentioned.

MrCjxer, 2025-03-22:
> You may check out HEX v250achexn, it should have everything you mentioned. For more details refer to ver_info_leonardo_micro.txt

Hi
Thank you for your response but bro for example on " E " option " clutch " is unavailable ...

Please can you do this for me ?!
I'm looking for someone do it for me and i want pay to him
I can donate it to you or i pay to you
Thank you ❤️

ranenbg, 2025-03-22:
I've already invested a lot of my time on v250 release. I need some motivation..

MrCjxer, 2025-03-22:
Yeah i know 🥲
It's hard to do it just yourself
But I'll wait a bit so you can rest and regain your motivation.

I'm from Iran, and the financial situation is very tough.
I can send you half of my total balance, which is about $5.
Is that okay?
My whole balance is 9$ :)

ranenbg, 2025-03-22:
No need to send anything, keep your balance where it is. It's weekend, I'm resting and spending time with my family.

MrCjxer, 2025-03-22:
❤️

MrCjxer, 2025-03-22:
> No need to send anything, keep your balance where it is. It's weekend, I'm resting and spending time with my family.

Oh sorry bro 🙌🏻
I wish you and your family best 💗

ranenbg, 2025-03-24:
I've fixed the ffb issue. You may try HEX v250achxn.

MrCjxer, 2025-03-27:
Hi
Yes i tested new firmware and FFB works fine 👌🏻
But i have found another problem with FFB which i will open another issues or here

**"About the buttons - are you saying it's absolutely impossible to have 22 buttons?** 🤔
When using a button box (Arduino Nano), can I really not use the main board's pins for buttons? ( A5, D3, D4, D5, D12, D13 are empty )

I need:
- 8 for gears
- 12 on the steering wheel
- 2 shifters behind the wheel"

ranenbg, 2025-03-27:
Hi looking forward to your new issue about FFB.

Well, you are right, 22 buttons is possible, I never said it's not. I just didn't structure my code that way, so it's not a small task to get it to work and I was avoiding it so far. You are the first one who needs nano button box + buttons on leonardo at the same time. I'll add it to my to do list and see what can be done.

MrCjxer, 2025-03-27:
1 - Regarding the FFB issue
In Assetto Corsa, when I'm going in reverse and want to turn quickly, if I rapidly turn the wheel left or right, the wheel itself spins 3 or 4 times and exceeds the 900-degree rotation I set for it.

2 - And yes, I know XY shifter can be used, but my shifter is designed for micro switches. Changing it would take a lot of time and cost, otherwise it would be a great solution .

-

> I just didn't structure my code that way, so it's not a small task to get it to work and I was avoiding it so far. You are the first one who needs nano button box + buttons on leonardo at the same time .

3 - So from what I understand, it's not something I or another programmer can add as a feature.
It's all on you, buddy. ♥

**4 - I think it would be good if you could make it so that any extra pin on the main board can be converted into a button. This way, I think fewer pins would be wasted, right?**

ranenbg, 2025-03-27:
1. The FFB issue you're talking about is not caused by my firmware, it's how the game handles forces. There is very little that can be done in firmware to prevent it. The only thing I could do is to set ffb to 0 wheel axis goes past the range, but I'm not liking this idea - once the wheel goes back inside range a max force will be slammed all of a sudden.
2. I understand, that's fine.
3. Anyone can do it if enough effort is invested.
4. Yes, that would be great so as milion of other things that I would like this firmware to have. The complexity is that I have already many configurations or firmware options that change the firmware in many ways. It has become so difficuilt to manage all possible combinations simply by using precompiler defines. I will see what I can do.

MrCjxer, 2025-03-27:
1 - So this is a game issue, but do commercial wheels like Logitech and Moza have the same problem?

2 - Yeah I know damn it, it's really problematic.
But you could make these features available only to those who compile the code themselves.
I mean in the **" config.h "** file where we add or remove // comments.
At first I thought it was difficult, but after doing what was suggested, I realized it's actually quite simple - just by commenting or uncommenting lines.
This was just a suggestion, but I hope you can do it

MrCjxer, 2025-03-27:
WOW ! Dude, you're a genius!

After all this time searching for a 9-pin cable and socket, or looking for a way to add 6 extra buttons with 16 buttons on leonardo, then boom, discovered this shift register trick!!
**" r - support for external shift register chips for 24 buttons (3x SN74ALS166 wired in series) "**

1- Does it have to be exactly this model of shift register?
Because I couldn't find this exact model to purchase from any store

2 - Can shift registers be used with the H (Hat Switch) option as well?

3 - Is it possible for you to create a visual guide (like you did for other components) for using:

3.1 - A single shift register

3.2 - Three shift registers

I believe this would solve my problem - and many other users who need more buttons - eliminating the need to convert those 6 pins or other pins into button inputs.

ranenbg, 2025-03-27:
Logitech gear driven wheels can't have such problem because they have a mechanical hard stop limit at end of axis range.

And for dd wheels like moza I don't know really. What keeps them inside of range is electrical endstop spring ffb effect. If you are stong enough amd if motor has low enough holding torque you can always push through it.

You wheel probably has a week motor and this electrical end stop is not so strong.

MrCjxer, 2025-03-28:
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

1 - So you're saying I should wait until the 3 shift registers get fixed?
Or is there a chance this might never work at all?
I remember one user managed to make about 64 buttons with the same Arduino and shift registers.
Why not ask them for help?

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

**2 - Do you mean I can use any shift register that is SN74?
Even SN74HC165N? Or only and only SN74ALS166?
Because in Iran, we don't have "Ebay" to buy from 🥲**

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

3 - Yes, I know there's an end-stop force, but my exact issue is that at that specific moment I mentioned, it seems inactive and lets me push past it! And when I cross the end point, I have to manually rotate the wheel 2-3 full turns to get back into the force feedback range!
Maybe it's a game bug—I need to test it again.

4 - The motor I'm using is an RS 775 (brushless), and my wheel is wooden and super lightweight, so no power is wasted. In fact, when I tested the end-stop force feedback, it felt really powerful and satisfying—I loved it! 😅😍

MrCjxer, 2025-03-28:
Sorry, my mistake...
If you can , answer me
Thanks ❤️

ranenbg, 2025-04-02:
I've just published a new release to address this question. I think that we can now close this issue. If you have further questions make a new issue.

Closed 2025-04-02.

Thread 94 (2025-03-22):

FFB Not Working In-Game After Updating to v250cdwhx

shubham0x13, 2025-03-22:
I was previously using v240wx, but after flashing v250cdwhx (along with the new GUI app), the FFB only works for idle spring force. However, in-game or when testing with WheelCheck, it doesn't work. Reverting to v240wx it works fine.

ranenbg, 2025-03-22:
Hi, tnx for report. which game did you use?

shubham0x13, 2025-03-22:
Assetto Corsa, F1 2020. In Assetto Corsa, when the car is idle, the wheel feels stiff, but when I accelerate, crash, or drive, it becomes loose.

ranenbg, 2025-03-22:
Assetto corsa uses damper ffb effect when car is stationary. You can try to lower damper gain slider in gui and see if that helps.

shubham0x13, 2025-03-22:
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
FFB only works for Centering Gain in the GUI app. When I open Wheel Check and select any effect, nothing happens.

ranenbg, 2025-03-22:
Ok, I'll have a look what is going on.

Would be good if you could check other HEX with "w" option. If they all show the same behaviour then just keep using 240wx untill I try to sort it out.

shubham0x13, 2025-03-22:
I tried v250acdwhx, but it's the same. Switching back to v240wx works.

ranenbg, 2025-03-22:
You can also try something with "b" and "w", that one has 2 ffb axis.

shubham0x13, 2025-03-22:
At first, I mistakenly tried using hex with "b" and thought that was why it wasn’t working. Later, I tried it without "b".

ranenbg, 2025-03-22:
That is extremely strange, I'll check it out.

MrCjxer, 2025-03-22:
Hi, yeah, I have this problem too.
I tested it in Assetto Corsa (it's the only game I have).

As long as I'm in the GUI and Windows, it works fine,
but as soon as I enter the game, it stops working.

The only thing that works is the last lock, which engages when the wheel reaches the end.

ranenbg, 2025-03-24:
I have found the issue and fixed it, it was something very minor. I've re-compiled all HEX and re-released v250 firmware. You may now check it out.

shubham0x13, 2025-03-24:
It's working now.

Closed 2025-03-24.

Thread 95 (2025-04-01):

Snowrunner

NinjaFrozr, 2025-04-01:
Can't get this to work in SnowRunner. There are in-game options for direct input mode and custom wheel preset but i still can't bind any axis, the game doesn't detect it.  Is there any way to make it work ?

ranenbg, 2025-04-03:
Hi, one thing that comes to my mind is that the game cannot detect the axis you're trying to bind because other axes are slightly moving due to ADC noise, and the game struggles with it. If that's the case, make sure to set axis calibration correctly such that absolutely no movement is seen if you're not touching anything. In some games, for the axis to be correctly detected, you must move it almost through its entire range, like more than 70%.

If this doesn't help, there is nothing else that can be done from my side regarding firmware.

shubham0x13, 2025-04-03:
Try https://www.youtube.com/watch?v=vEcKw1PVPpQ

shubham0x13, 2025-04-03:
> Is there any way to make it work ?

Try https://www.youtube.com/watch?v=vEcKw1PVPpQ

Thread 96 (2025-04-13):

Question about shift registers and Hall effect sensors

MrCjxer, 2025-04-13:
**Hi there,**

I'm glad the issue with the shift registers is resolved and we can now move forward 😊

I have a few questions:

### 1. Shift Register Compatibility
Do we need to use the exact models you mentioned — **SN74ALS166N** or **SN74HC165N**?
Unfortunately, these specific parts are not available in my country (Iran), but I have access to similar 8-bit shift registers, such as:
- 74LS166AN
- 74F166N
- SN74166 (8-bit)
- 74LS166
- ...or similar variants.

👉 **Would any of these be acceptable substitutes?**
Also, I’d really appreciate it if you could provide some guidance on how to choose the right shift register for this project.

### 2. Hall Effect Sensor Alternatives
Can I use a model like **SS49E** as a Hall effect sensor alternative?

### 3. Recommended Hall Effect Sensors
If possible, could you please list a few Hall effect sensor models that would be suitable for this project (for pedal use)?

Thanks so much for your time and support! 🙏

ranenbg, 2025-04-13:
Hi, you're asking me too much. You can find answers to all of those questions through some googling.

Any shift register with similair features as the two I mentioned will do, just look at the data sheet.

Any hall sensor with analog voltage output will do fine, like ss49e, those are the most standardly used. Just take care about correct magnet placement - two mag poles have to rotate around the sensor in order to have linear mapping between angle and voltage.

MrCjxer, 2025-04-13:
Hi. Yes i know bro 🥲
And I'm sorry for that ...

Believe me, I've been researching during these past two weeks since you uploaded the new firmware, but since my field isn't electronics, the more I research, the more confused I get.

Thanks for your guidance.

---

I managed to find and order the SN74HC165N version.
Could you please add a wiring diagram for this type of shift register on the main page as well? (Whenever you have time.)
Because, as always, it's confusing 🥲

---

And also, do Hat Switchs exist in this type of button box?
If they do, which pins are they connected to?
The first 4 pins of the first shift register maybe ?

---
I'm soooo sorry again bro

I’ll try to make this my last question, and after this, I’ll vanish into oblivion, never to return 🥲💔

ranenbg, 2025-04-13:
The information in the wiring diagram I already provided is enough to connect any shift register. Important part is that output of 1st one goes into arduino, and output of any shift register behind goes into the serial input of the one ahead - they are stacked in series.

Yes, hat switch will use first 4 bits, so that is pins A, B, C , D from 1st shift reguster chip.

MrCjxer, 2025-04-13:
Ok
Thank you so much ❤️🙏🏻
I'm sorry to waste your time :)

---
But I have a new idea.
It's about head tracking! ( Tracking the head in games :) )
I've done some research on it and I have some fairly good information.
If you're interested, let me know where you'd like me to explain it

Here, or by email, new issues or even if you're not interested in knowing at all.

Thank you again
And bye 👋🏻

ranenbg, 2025-04-14:
No thank you, I've played with camera head tracking some 20 years ago.

MrCjxer, 2025-04-14:
No, it's not camera Head tracking.
Bmi160 and MPU-6050 sensors and may other sensors.

I just wanted to share it with you in case you’d like to use it in this project or maybe a new one.
Thanks a lot!
Take care!

Closed 2025-04-14.

Thread 97 (2025-04-21):

can this use printer encoder

Gandoun, 2025-04-21:
can this use printer encoder

ranenbg, 2025-04-21:
Hi, short answer - yes.

Long answer - the firmware requires 2 channel quadrature encoder signals. Any device that can provide such signals will work, the only requirement is 5V logic level. Open collector encoders will work also, but you have to put a pullup resistor.

Gandoun, 2025-05-11:
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

when i press ok the application closes

shubham0x13, 2025-05-11:
Go to the `data` folder within the app directory, create a file named `COM_cfg.txt`, write your Arduino Leonardo COM port in it (e.g., `COM6`), save the file, and start the app.

Thread 98 (2025-05-18):

BTS7960 instead of Cytron MD30C

CboatDesign, 2025-05-18:
Hello

Can I use Cytron MD30C motor controller or not?
My last project it was fault because the BTS board to weak.

Thanks

ranenbg, 2025-05-18:
Hi, after looking at specifications of that h-brigde motor driver it seems that it doesn't have a PWM input. It has an onboard pot for adjustment of motor speed and a switch for changing direction, it is definately not suitable replacement for bts7960.

It's quite strange that you call bts7960 weak, it has 43A curent rating. But it's true that cooling is done very badly on the chinese pcb. You should put thermal paste between heatsinc and pcb, it will help a little with taking geat away from power mosfets.

Thread 99 (2025-05-24):

AS5600 + XY shifter

TimofeyVneTopa, 2025-05-24:
Hi, I want to use AS5600 magnetic encoder with XY analog shifter, but I can't find such combination. Can i do something about this?

shubham0x13, 2025-05-24:
As far as I know, the firmware currently only supports analog potentiometers for XY shifters. There is no built-in support for the AS5600 magnetic encoder. That said, I do not think encoder support is necessary in this case because an XY shifter operates within fixed limits that a potentiometer can handle just fine. Additionally, potentiometers are simpler and more cost-effective for this use.

TimofeyVneTopa, 2025-05-24:
I mean, that I want to use magnetic encoder for wheel mechanism and XY shifter based on potentiometers together. But I don't see .hex files with support both of them.

shubham0x13, 2025-05-24:
Oh, my bad! You can try modifying the `Config.h` file, as it’s well documented, and then compile your own firmware. Instructions on how to compile the source can be found [here](https://github.com/ranenbg/Arduino-FFB-wheel?tab=readme-ov-file#how-to-compile-the-source). Just keep in mind that it might not be possible to use both the AS5600 and XY shifter configurations at the same time due to the Arduino Leonardo’s memory limitations. That could be the reason why the configuration doesn’t exist by default.

TimofeyVneTopa, 2025-05-24:
Thanks for the explanation. I'll try to figure it out now.

ranenbg, 2025-05-24:
Hi, it is possible to use both xy shifter and magnetic encoder in my most recent version of firmware. I made some optimizations so there is just barely enough memory left for such config (like a few bytes). I didn't release it yet, but I think I have uploaded it in the main repository.

phatgamer0166832-crypto, 2025-08-02:
can you add a hex file version for as5600 + XY shifter?

ranenbg, 2025-08-02:
Yes, here it is:
[brWheel_my.ino.leonardo_v250dwfx.zip](https://github.com/user-attachments/files/21557566/brWheel_my.ino.leonardo_v250dwfx.zip)

Closed 2025-10-07.

Thread 100 (2025-06-07):

Shifter calibration

kick-a-poo, 2025-06-07:
Hello, thanks for this awesome program I have been working on it for a good 2 years, currently having an issue thaat might seem dumb, for some reason I cant calibrate the shift

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

much help would be appreciated

ranenbg, 2025-06-07:
Hi, yes, there was a misshap from my side in the latest release. Just use the HEX with xy shifter option from the github repository, there I have fixed this and re-uploaded, as I didn't think it was worth it to make a new release just for 2-3 new HEX files.

ranenbg, 2025-06-07:
That's great. Would be very useful to make an "issue", and explain your wiring with dual bts, motor and gear/pulley setup, ratios.. Just plsease name it non-an-issue or something not to be missleading.

perides, 2025-09-18:
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

Can someone help me? I’m using the latest version of the firmware and also the wheel control, but I’m not able to calibrate the shifter.

I’ve tried everything:

- Using the latest precompiled versions of both
- Building and flashing from the source code

But in both cases I couldn’t get the calibration to work.

Thanks in advance.

ranenbg, 2025-09-19:
Great. I'm closing this thread as issues with shifter calibration are fixed.

Thread 101 (2025-06-09):

250~~~~ issues I've been facing

Notriatv, 2025-06-09:
Hi Rane, greetings!

I’ve been testing the new version for a while, and here’s what I found a bit problematic:

The FFB feels weaker than in previous versions...
I tried a few variations of your new firmware version (v250xxxx), and I noticed that the FFB seems weaker compared to the older versions, even using the same FFB settings in the software. Sometimes, the force feedback doesn’t work at all in tools like rfrWheel Test or WheelCheck with this firmware.

Also, my analog H-shifter isn’t working… I mean, the analog movement is recognized by the software, but the buttons don’t turn green when they reach the activation zone.

Those are the little issues I’ve found so far.

Another point: version 241chfx, which I currently use (and thank you for that!), is still the best for my personal setup. It offers all the basic analog axes for a regular car, 16 buttons via the Nano, a working H-shifter, and strong, consistent FFB. I missed those features in the new versions.

The closest I found was v250hfxnl, but I’m not really interested in a load cell brake at the moment. I also missed the centering button.

So, since the FFB feels off and the H-shifter isn’t working properly, I’ve gone back to the 24xx firmware.

One more tip, in case you weren’t aware: the MT6701 magnetic encoder already works as a native replacement for the optical encoder — no special code needed. I’ve tested it, and it works great at 4096 CPR.

If you plan to keep developing this project and release future versions, please consider making something closer to the 241chfx, if possible. 🙂

Anyway, thanks so much in advance for all the hard work you’ve already put into this project!

ranenbg, 2025-06-16:
Hi, you are welcome, I'll try to keep this project alive and going as long as I can.

About weak FFB, I don't know why you feel that, I did not change the strength of FFB in new firmware. I did change the default PWM settings from 16kHz, 500 steps, phase correct to 8kHz 2000 steps and fast pwm. If you are using min torque slider above zero, there may be some differences so make sure that PWM settings are the same as for the ones you used in earlier firmware.

I'll see what I can do with compiling equivalent HEX for 241chfx. In the new firmware, this should be something like 250chnfx and should be doable concerning memory constraints.

Notriatv, 2025-06-27:
Hi Rane, I’m back. Thanks for making this firmware available — it fixed the H-shifter, but the FFB still feels weird... kind of stuck, “rubbery,” or sluggish.

And before you make any recommendations, I should say that I already tested with another Leonardo/BTS7960/motor, double-checked all the wiring or methods, and tried different settings in the GUI — but it still feels very different compared to version 240 or below
It’s like it's skipping steps or something — hard to explain.
Anyway, version 240 is already excellent for me.
The only change I’d like to know if it’s possible: maybe using the SN74 instead of the Nano to get more buttons.
Other than that, I honestly don’t see how this version could be improved.Not that I’m trying to limit your creativity, but considering the limitations of the Arduino Leonardo, this is already amazing!

Regarding the MT6701, I was having issues with it losing center — something that was solved by using shielded cables and a 1nF ceramic capacitor between VCC and GND

ranenbg, 2025-06-27:
The thing is that I can't go back to firmware 240, as this has been updated to v250, I can only add features to that one. I have already made SN74 for 24 buttons feature, it's only a matter of uncommenting it in the config.h. Let me know if you need me to compile you a new v250 HEX with your previous options, including the shift register chips. It can be from 1 to 3 chips (for 8 to 24 buttons).

Notriatv, 2025-07-03:
https://youtu.be/oW1KTgZWjRk?si=q0ugjlhHk6mlLqwk
I tried making a video in English — hope it's understandable haha

Notriatv, 2025-07-03:
> The thing is that I can't go back to firmware 240, as this has been updated to v250, I can only add features to that one. I have already made SN74 for 24 buttons feature, it's only a matter of uncommenting it in the config.h. Let me know if you need me to compile you a new v250 HEX with your previous options, including the shift register chips. It can be from 1 to 3 chips (for 8 to 24 buttons).

If it were possible to test an unofficial version of 240 with SN74 support, that would be great!
Right now, version 250 is just not usable for me due to these issues...
But no pressure — only if it’s not too much trouble for you. :)

Also, let me know if you ever change that device usage thing in hid.cpp that you mentioned in f1 23 post — I’d like to see if that helps the wheel get recognized more easily in some games..
thanks in advance!

ranenbg, 2025-07-11:
Hi man, thank you for testing, I'm glad that FFB is now sorted out in v250.

About endstop force, in v250 I made it in a way that it is activated just a little bit before the axis end, by 1/64 of axis range to be exact, from both sides. I did it intentionally, because when you set a pot as an input for FFB axis, in a joystick for example, it can only go up to the axis end, which would result in the absence of endstop force. With an optical encoder, it's possible to go far beyond the axis range, and I could make the endstop activate exactly at the end of the axis range. I understand that it is annoying, as before in v24X endstop was like this. I can make it back for 1-FFB axis and for 2-FFB axis firmware option, I can leave the small 1/64 gap, this is easy to do by using precompiler if statements, without extra memory cost. I'd like to keep one version of firmware, which has this kind of chameleon ability to transform into many colors.

 I'll make this change and then recompile all HEX and make a re-release soon.

Closed 2025-07-11.

Thread 103 (2025-07-16):

xy shifter

Gandoun, 2025-07-16:
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

Why are the buttons not pressed in the game?

ranenbg, 2025-07-16:
Hi, tnx for reporting the issue with XY shifter in v250. I've just did a quick check of  HEX v250fx that you use and it does seem to have some problem with gear to button conversion. You came just in the right time as I'm in the process of fixing some other smaller bugs, I'm planning a re-release of v250.

I would appreciate if you could do some more testing and tell me which button gets reported for each XY shifter gear. I can see that 2nd gear is working, but I can't easily and quickly test the other ones at the moment. Help in this regard would be appreciated.

ranenbg, 2025-07-17:
Hi, it turns out this was a known bug in v250. I have already made a fix some time ago; however, I've recompiled all (35+) HEX files today. I will be doing a re-release of v250 sometime later today. You can then use the fixed HEX and it should work fine.

Thread 104 (2025-07-18):

Nano button not working

921358676, 2025-07-18:
Hello, I'm facing problem in my 16 nano button, they all are only blinking. I don't know what to do, please help me.

Thread 105 (2025-07-30):

Is it possible to use this esp32 as buttonbox on wheel wirelessly instead of NANO or promicro

Mamunmk1, 2025-07-30:
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

ranenbg, 2025-07-30:
Hi, yes, absolutely, just not with my firmware. There is already available Bluetooth firmware for ESP32wroom that turns it into a game device with buttons, it can even have axis as well, but it has no FFB. You can use it along side my firmware that will act as a wheel and this other board and firmware as a separate stand alone button box with many buttons, up to 64 I think.

ranenbg, 2025-07-30:
Hi, you can have a look at this also, I did play with it for some time.
It's for Esp32Wroom, you can user Arduino IDE to upload it to ESP32 but you
need to install ESP boards first.

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

Closed 2025-07-30.

Thread 106 (2025-08-06):

Clip LED not working

brunoccosta5, 2025-08-06:
In the latest update, the clip LED stopped working on the Arduino Leonardo. I was able to confirm that the issue is related to the latest firmware, as I tested an older version (v230) and the LED works normally. I'm currently using the leonardo_v250fx firmware and Wheel Control v2.6.5.

ranenbg, 2025-08-06:
You're welcome man.

Ok, tnx very much for checking the HEX, no further actions needed, this is enough for me to start digging into the code. I'll let you know once I figure it out.

Closed 2025-08-27.

Thread 107 (2025-08-11):

BTS7960 Failure and Arduino Wiring Issues

AR9A, 2025-08-11:
So, I'll start with the main problem I caused.
 I looked at the motor driver wiring from another place and thought that for projects like this, the wiring is always the same. What I did was i connect R_EN and L_EN simultaneously and to digital pin 8 of the Arduino Leonardo, and RPWM to pin 10, LWPM to pin 9, VCC to 5 volts of the Arduino, and GND to GND of the Arduino. Also, the firmware version I used was v250htx. As soon as I connected the power supply (12v 30amp) to turn on the BTS7960 driver, a buzzing sound was heard from the power supply, and after about 2 minutes, the driver capacitor blew and smoke rose from the driver. After that, I changed the capacitor for the driver with same specs as orginal one and wired everything exactly according to your wiring. Now, when I test the force feedback, the motor (RS550) only turns in one direction, that is, only to the right, and if I try to turn it in the other direction, a sound like a buzzing sound is heard from both the driver and the power supply, meaning that the motor does not turn to the left at all. Also, when I was doing all these tests, only the bts7960 was connected to the Arduino.
My questions are:
1- Is this driver damaged and do I need a new driver? 2- Has this action caused any problems for the Arduino board? (It is currently on and I can flash the firmware on it and the encoder works)
I would appreciate your guidance. Thank you for your time.

ranenbg, 2025-08-11:
Hi, yeah, that was a very silly mistake, but it happens. Make sure to carefuly read and follow my wiring instructions for h-bridge motor driver.

My suggestion is to right away order new arduino leonardo and bts7960 boards. There is a high chance that arduino is fine, so if budget is tight you may just get a new bts7960. I think one channel is probably gone. I'm not sure why this would happen, in "t" firmware pin8 is part of button matrix, it's configured as digital input or output, can't remember. In eaither case, motor would not spin in any direction at all, or would be very jerking in both directions.

To check if motor is fine, reverse its polarity and see if it rotates in the opposite direction normally, you can use 9V battery, but only power it for 1s or so. As I don't usualy make such wiring mistakes, I can't tell you what may have got damaged, you will have to find that out yourself.

AR9A, 2025-08-11:
Special thanks for your response.
I tested the motor and it turns in both directions with the battery and there is no problem.
So I will buy a new bts 7960 because my budget is limited and I will announce the result here

AR9A, 2025-08-17:
Hello again. The new driver arrived and I'm afraid to test it lol. I had a few questions. I would appreciate your advice. Is it better to have the PWM on Fast PWM or Phase-correct PWM? Do I need to modify the PWM sections at all? Also, the motor I want to use now is a windshield wiper motor. And which part of the Adreno FBB gui is related to FBB and reduces its intensity?

ranenbg, 2025-08-17:
Hi, do not touch anything in the firmware (code), you can use HEX that I compiled, or just compile yourself with ypur desired firmware options.

In GUI set PWM+- mode, you can use 8kHz or 16kHz pwm frequency and fast pwm type. Use general gain slider to set final FFB strenght.

ranenbg, 2025-08-24:
Yes, try with some min torque it will help with lower forces.

AR9A, 2025-08-24:
I installed the potentiometer correctly for the throttle alone, but the three pedals work at the same time. What is the problem? Thanks.

ranenbg, 2025-08-24:
The problem is that signal from lin A0 is reflected to other floating pins. You need to put other pins to gnd if you do not want them to pickup noise from other neigbouring pins.

Closed 2025-08-17.

Thread 108 (2025-08-12):

What firmware to install on Arduino Pro Micro

Stauzebench, 2025-08-12:
Hi Ranenbg,
I am very excited to build my Arduino FFB Wheel and want to ask what HEX I need. My Setup will be Pro Micro with Single BTS7960 and AS5600. I maybe want 3 pedals, but 2 are good for now with buttons for up and down shift. So just basic. There are so many files to choose and I dont want to make a mistake by choosing the wrong one.
Thanks for your help.

ranenbg, 2025-08-12:
Hi, you can't make a mistake, as you can always flash another HEX. Don't be afraid to experiment. Go in proMicro folder v250 and find a HEX that has "w" in it, that one has as5600 support.

Stauzebench, 2025-08-13:
Alright thanks,
so I use either bcdwxm, or bcdwxgm. What are the differences with these two firmwares?

ranenbg, 2025-08-13:
The difference between those two is the "g" option, which is for analof FFB output via i2C dac, mcp4725 but you don't need it if you plan to use an h-bridge motor driver like bts7960. The option "b" stands for 2 axis FFB, which is meant to be used for flight controlers.

You may read a ver info txt file which is located in proMicro hex folder, I've put there description of all firmware options that each HEX contains.

Stauzebench, 2025-08-13:
Can you compile me a hex that can handle the following hardware.
One Axis for steering with AS5600 and Motor driver input with BTS7960.
I first want to make gas and breaking onto the wheel itself, something like the ps4/ps5 R2/L2 triggers. Is it possible to do that with pressure sensors or is a potentiometer more easy to begin with.
Two inputs for shifting up and down.
I think that is all to begin simple racing, if I haven't forgot something. I hope that is not too much to ask for.
Thanks in advance.

ranenbg, 2025-08-13:
You can use v250cdwhxm, I've already compiled that one and included it in latest release. It has everything you mentioned plus some extra features like hardware re-center button on pin D2 and a hat switch which takes up 4 normal pins for buttons. I'm not sure if there is enough button pins left for your other functions, but this is a good start, as this HEX is suitable for your gamepad build.

At some latter point I'll compile v250cdwxm which is the one you need.

Stauzebench, 2025-08-16:
Hey,
I had time to put everything together and flash the firmware to the arduino. At first all seems to work and I could feel some kind of force trom the motor. I opened the ffb iracing setup.exe and without any other settings i choose simple force and the motor began to spin endlessly in one direktion. To not damage something i unpluged the psu and after replugging, the motor couldnt begin to run, the psu always rebooted, like too much power drawn. I unwired the motor to get in the settings, but the arduino wasnt recognised anymore. After unwired everytning and testet around, I came across that the ibt is shorted at the positiv side. Is there some kind of protection like a diode we can use to protect the driver from inducting to much current back into? I use a MY1016 24V 350W and this thing will push back alot of current back into the system if nothing can absorb it.

ranenbg, 2025-08-16:
Hi, by default wheelcheck sets coefitient for simple spring effect to max, which is 10000. This means that even a tinyest movement of X axis will cause FFB output to max out. That motor is obviously too big of a bite for default bts7960 (without improved cooling).

I allways recommend to test FFB in my GUI. By default firmware has an autocenter spring activated. Even at 100% strenght it is much weaker than the one from wheelcheck. It will output max FFB only when you max out X-axis (or whichever axis is tied to ffb). You can use general gain slider to set overall FFB to an acceptable and safe level for your hardware combination.

Usualy, one would use a braking resistor circuit to dampen the energy from the motor when it is in generator mode. This is whenever no ffb is sent but motor is still spinning due to inertia or by external force from hand. Normaly for motors like RS775 or even RS875 with 12V psu this is not needed as bts7960 can handle the damping. But for 24V 350W motor, back elektromotor force is way to high. You can easily damage it if voltage goes above 30V or so. You can check with multimeter in voltag mode how much voltage your motor can generate in open circuit - just voltmeter connected.

Stauzebench, 2025-08-16:
Thanks for explaining.
Yeah, I have ordered some more BTS and will use your GUI to test FFB and connect just 12V for testing and setting up.

Stauzebench, 2025-08-16:
One more question.
I have an IBT-4 laying aroung. Is it possible to use this as well? It just has In1 and In2 to controll the motor. GPT says:

IN1 = PWM, IN2 = LOW → Motor forward

IN1 = LOW, IN2 = PWM → Motor reverse

IN1 = LOW, IN2 = LOW → Motor coast (free spin)

IN1 = PWM, IN2 = PWM (both HIGH/PWM) → Motor brake (shorted, only use briefly).

Closed 2025-10-07.

Thread 109 (2025-08-21):

PWM mode problem

CboatDesign, 2025-08-21:
Hello

I use Arduino promicro board and Cytron md20a controller, this type working with pwm+dir signals, firmware v240wxm, PWM Pin9, DIR Pin 16.
When I started the wheel control software the motor working fine but only one direction, when I turn it right the spring working well it turn the wheel for 0 position, but I turn it left direction the motor continuously rotate with full speed.
I read the whole document but I couldn't solve this.
Please help.

Thanks, Istvan.

ranenbg, 2025-08-21:
Hi, tnx for reporting this issue. It looks like that dir signal is missing for whatever reason. You should measure with a multimeter at your driver input side if this signal is being changed from 0V to 5V.

As you may know, I have recently made a fix for PWM signal generation for firmware v250, so PWM+DIR mode should work fine, but I didn't test it for proMicro yet. There may be a firmware problem, I'll check it. Did you try the HEX v250wxm from latest release?

ranenbg, 2025-08-22:
Just pay attention that firmware ending with "m" has replacement pinouts for proMicro board. It is possible to upload that firmware to leonardo board as well, but then dir signal will be missing as it has no pin 16.

CboatDesign, 2025-08-22:
Yes, you right, I put this one 250dwfx on the Leonardo, the wheel check see it, PWM 9 DIR 11 but the spring force working only the middle, after I turn some direction the motor rotation become to continiouosly both direction.

ranenbg, 2025-08-22:
Hi, that is good news. It seems that something is reversed; now you have FFB changing direction, but it's the opposite. The spring force is trying to make the wheel go away from the center, no matter which direction you turn it. Is that correct?

CboatDesign, 2025-08-22:
I changed the polairty and the wheel working fine, I dont understand why not work with the proMicro, but the Leonardo is good.
Thanks for your help, you are was very helpful!
Are you have a patreon or something else?

ranenbg, 2025-08-22:
Great that you got it working on Leonardo. It should also work fine with proMicro, just use HEX from today's release.

I don't have patreon, tnx for asking, I do have paypal, you can see it in my gui.

Thread 110 (2025-09-12):

Problema no driver bts7960    porta 10  funciona normal ja a 9 n tenho resposta

carlosalbertovieirasilva01-ops, 2025-09-12:
Estou usando  a versão v240cfx

Com inconder magnético

Funcionado tudo normal  menos o volante  a porta 10 recebe o sinal e funciona  forcefedbak
Ja a porta 9 recebe o sinal   mais o forcefedbak  não funciona..

Pode ser meu driver  bts7960

 Nos jogos de corrida pra explicar melhor
Para o lado esquerdo  o forcefedbak  funciona  já  pra o direito

Ja tirei da porta 11 e ja coloquei  no 5v

 Lembrando foi feito  fiel  igual o projeto

Obrigado  pelo  seu tempo

Closed 2025-09-26.
