ranenbg/Arduino-FFB-wheel/brWheel_my/ConfigHID.ino

//#include "Config.h" // milos, commented out
//#include "debug.h" // milos, commented out
#include "ConfigHID.h"

void configHID(USB_ConfigReport *data) {
#ifdef USE_CONFIGHID
  if (data->Info == 1) { // milos, update firmware settings from an incomming HID packet
    int16_t temp = data->Rotation;
    temp = constrain(temp, 30, 1800);
    ROTATION_MAX = CPR * temp / 360;
    ROTATION_MID = ROTATION_MAX / 2;
    //brWheelFFB.offset = (MAX_ENCODER_ROTATION - ROTATION_MAX) / 2; //milos, commented out

    if (data->Calibrate == HIGH) brWheelFFB.calibrate();

    configGeneralGain = constrain(data->GeneralGain, 0, 200);
    configConstantGain = constrain(data->ConstantGain, 0, 200);
    configDamperGain = constrain(data->DamperGain, 0, 200);
    configFrictionGain = constrain(data->FrictionGain, 0, 200);
    configPeriodicGain = constrain(data->PeriodicGain, 0, 200);
    configSpringGain = constrain(data->SpringGain, 0, 200);
    configInertiaGain = constrain(data->InertiaGain, 0, 200);
    configCenterGain = constrain(data->CenterGain, 0, 200);
    configStopGain = constrain(data->StopGain, 0, 200);

    /*temp = data->MinForce;
      if (temp < MM_MAX_MOTOR_TORQUE) {
      MM_MIN_MOTOR_TORQUE = constrain(temp, 0, TOP - 1);
      data->Info = 99;
      }

      temp = data->MaxForce;  // milos, commented out
      if (temp > MM_MIN_MOTOR_TORQUE) {
      data->Info = 99;
      MM_MAX_MOTOR_TORQUE = constrain(temp, 1, TOP);
      }*/
  } else if (data->Info == 255) { // milos, send all firmware settings to HID packet
    /*  uint8_t ReportId;
      uint16_t Rotation;
      fwOpt fwOption; // milos, added
      int32_t Offset; // milos, added
      int32_t EncCPR; // milos, added
      uint8_t GeneralGain;
      uint8_t ConstantGain;
      uint8_t DamperGain;
      uint8_t FrictionGain;
      uint8_t PeriodicGain;
      uint8_t SpringGain;
      uint8_t InertiaGain;
      uint8_t CenterGain;
      uint8_t StopGain;
      uint16_t MaxForce;
      uint16_t MinForce;
      uint8_t PWMstate; // milos, added
      uint8_t EFFstate; // milos, added
      uint8_t LCscale; // milos, added
      boolean Calibrate; // milos, changed from uint8_t
      uint8_t Info;
      uint16_t Version; // milos, changed from uint8_t*/
    //data->ReportId = 0xF2; // milos, already
    data->Rotation = ROTATION_DEG; //milos, added
    data->Offset = brWheelFFB.offset; //milos, added
    data->EncCPR = CPR; // milos, added
    data->GeneralGain = configGeneralGain;
    data->ConstantGain = configConstantGain;
    data->DamperGain = configDamperGain;
    data->FrictionGain = configFrictionGain;
    data->PeriodicGain = configPeriodicGain;
    data->SpringGain = configSpringGain;
    data->InertiaGain = configInertiaGain;
    data->CenterGain = configCenterGain;
    data->StopGain = configStopGain;
    data->MaxForce = MM_MAX_MOTOR_TORQUE;
    data->MinForce = MM_MIN_MOTOR_TORQUE;
    data->PWMstate = pwmstate; // milos, added
    data->EFFstate = effstate; // milos, added
    data->LCscale = LC_scaling; // milos, added
    data->Version = FIRMWARE_VERSION;
    data->fwOption = fwOptions; // milos, added
  }
#endif // end of use config hid
  //uint8_t *response = (uint8_t*)data;
  HID_SendReport(0xF2, (uint8_t*)data, 64);
}
