ranenbg/Arduino-FFB-wheel/arduino-1.8.5/hardware/arduino/cores/arduino/ConfigHID.h

#include "Config.h"
#include "debug.h"

#ifndef _CONFIGHID_H_
#define _CONFIGHID_H_

typedef struct
{
  uint8_t ReportId;
  uint16_t Rotation;
  int32_t Offset; //milos, added
  uint8_t GeneralGain;
  uint8_t ConstantGain;
  uint8_t DamperGain;
  uint8_t FrictionGain;
  uint8_t PeriodicGain;
  uint8_t SpringGain;
  uint8_t InertiaGain;
  uint8_t CenterGain;
  uint8_t StopGain;
  uint16_t MaxForce;
  uint16_t MinForce;
  uint8_t Centralize;
  uint8_t Calibrate;
  uint8_t Info;
  uint16_t Version; //milos, changed from uint8_t
} USB_ConfigReport;


void configHID(USB_ConfigReport *data);

#endif // _CONFIGHID_H_
