ranenbg/Arduino-FFB-wheel/(commit log)

2021-09-23 init my repo
    [log2 2019-01-19 11-40-20.csv, log2 2019-01-19 12-11-56.csv, log2 2019-01-19 12-30-00.csv]
2022-04-21 ads1015 wiring
2022-04-28 mcp4725 wiring
2022-05-31 button matrix
2022-06-01 8 buttons
2022-06-03 button matrix fix
2022-06-07 bts wiring
2022-07-10 XY shifter support
    [log2 2019-01-19 11-40-20.csv, log2 2019-01-19 12-11-56.csv, log2 2019-01-19 12-30-00.csv]
2022-08-12 manual cal and pwm0.50.100
2022-08-29 rcm mode
    [RCM_mode.xlsx]
2022-09-23 button box wiring
2022-11-03 X-axis calib 0-65k
2022-11-03 fw-v22x wiring
2022-12-25 HEX v220cm D-pad fix
    [Config.h, Inputs.ino, pwm.ino]
2025-03-20 updated wirings
2025-03-24 dac wiring
    [Firmware-v24X button mappings.xlsx]
2025-03-24 xyshifter wiring fix
2025-07-17 pwm and xy shifter fixes
    [Config.h, ffb_pro.ino, pwm.ino]
2025-08-21 FFB clip LED fix
    [Config.h, pwm.ino]
2026-01-15 Fix case sensitivity in Arduino.h include directive
    [ffb.h]
2026-01-15 Fix include case sensitivity for Arduino header
    [ffb.h]
